twmiv/Voron-Hardware/Taco_Raven/KiCad/Voron_Klipper_Board.kicad_pcb

## KiCad design Taco_Raven/KiCad/Voron_Klipper_Board.kicad_pcb (2020-08-16)

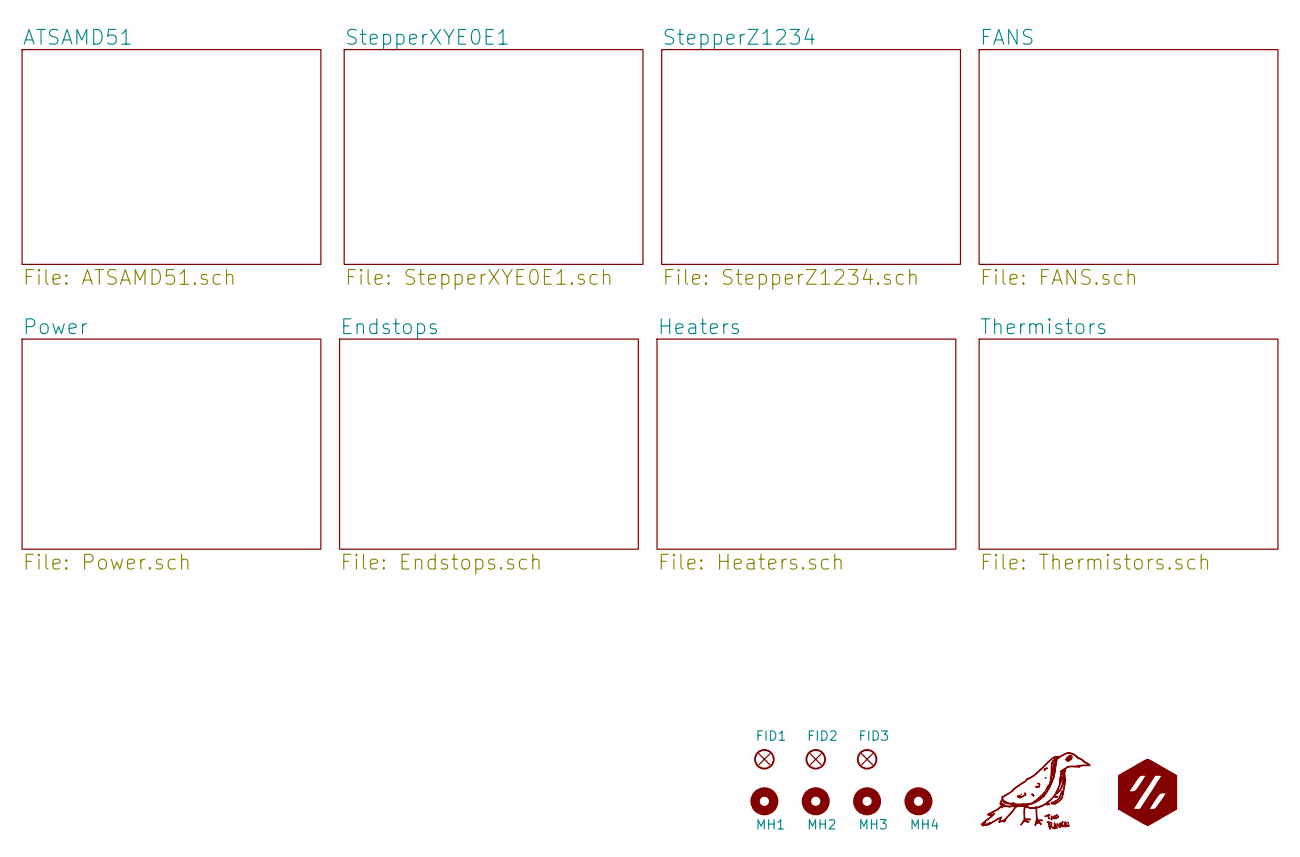
[picture p1: schematic Voron_Klipper_Board.sch, Taco Raven]

Parts:
FID1, FID2, FID3: FIDUCIAL_1MM; Fiducial_1mm_Dia_2.54mm_Outer_CopperBottom
G1: TACo; taco
G2: mzbot; LOGO
MH1, MH2, MH3, MH4: MountingHole; MountingHole_3.2mm_M3_DIN965

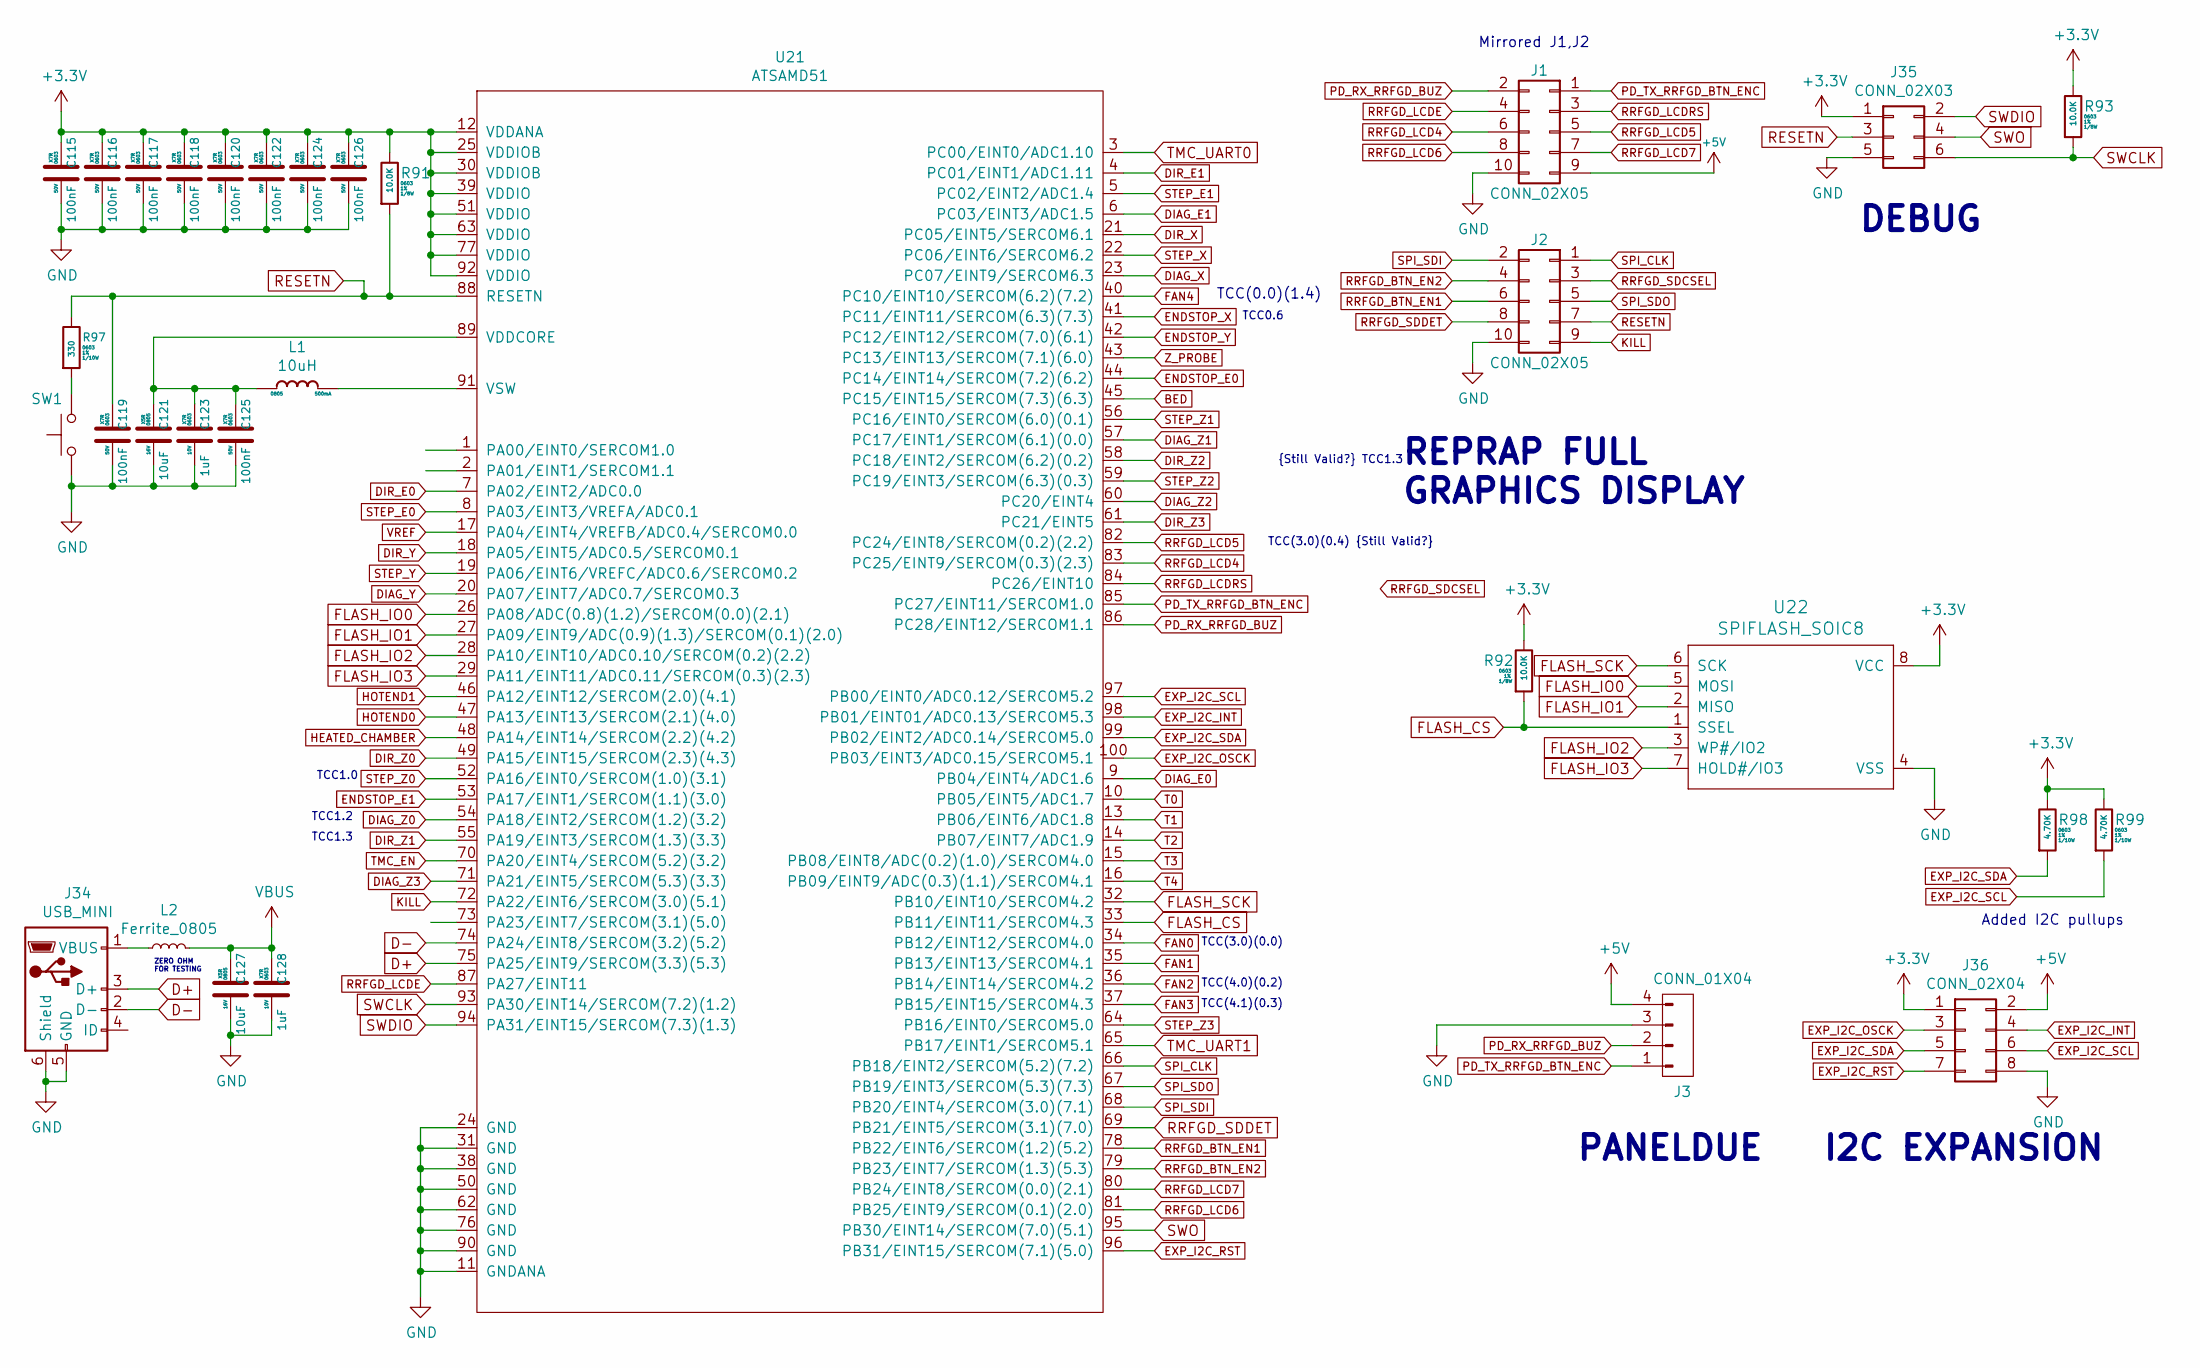
[picture p2: schematic ATSAMD51.sch, Taco Raven]

Parts:
C115, C116, C117, C118, C119, C120, C122, C124, C125, C126: 100nF; C_0603; Voltage 50V; MFG PN CC0603KRX7R9BB104; Digikey P/N 311-1344-1-ND
C121, C127: 10uF; C_0805; Voltage 16V; MFG PN CL21A106KOQNNWE; Digikey P/N 1276-2894-1-ND
C123, C128: 1uF; C_0603; Voltage 10V; MFG PN CL10B105KP8NNNC; Digikey P/N 1276-1946-1-ND
J1, J2: CONN_02X05; PinSocket_2x05_P2.54mm_Vertical; MFG PN 302-S101; Digikey P/N ED1543-ND
J3: CONN_01X04; Molex_KK_1X4; MFG PN 0022232041; Digikey P/N WM4202-ND
J34: USB_MINI; USB_Mini-B_Lumberg_2486_01_Horizontal; MFG PN 690-005-299-043; Digikey P/N 151-1206-1-ND
J35: CONN_02X03; PinHeader_2x03_P2.54mm_Vertical
J36: CONN_02X04; PinHeader_2x04_P2.54mm_Vertical; MFG PN 75869-332LF; Digikey P/N 609-5123-ND
L1: 10uH; L_0805_2012Metric; MFG PN MLZ2012N100LT000; Digikey P/N 445-6762-1-ND
L2: Ferrite_0805; L_0805_2012Metric; MFG PN CRCW08050000Z0EA; Digikey P/N 541-0.0ACT-ND
R91, R92, R93: 10.0K; R_0603; Tolerance 1%; MFG PN RNCP0603FTD10K0; Digikey P/N RNCP0603FTD10K0CT-ND
R97: 330; R_0603; Tolerance 1%; MFG PN RMCF0603JT330R; Digikey P/N RMCF0603JT330RCT-ND
R98, R99: 4.70K; R_0603; Tolerance 1%; MFG PN RC0603FR-074K7L; Digikey P/N 311-4.70KHRCT-ND
SW1: SW_Push; SW_SPST_B3S-1000; MFG PN B3S-1000P; Digikey P/N SW836CT-ND
U21: ATSAMD51; TQFP-100_14x14mm_P0.5mm; MFG PN ATSAMD51N19A-AU; Digikey P/N ATSAMD51N19A-AU-ND
U22: SPIFLASH_SOIC8; SOIC-8_3.9x4.9mm_Pitch1.27mm; MFG PN AT25SF041-SSHD-T; Digikey P/N 1265-1131-1-ND

Connections:
+3.3V: C115.2, C116.2, C117.2, C118.2, C120.2, C122.2, C124.2, C126.2, J35.1, J36.1, R91.1, R92.1, R93.1, R98.1, R99.1, U21.12 (VDDANA), U21.25 (VDDIOB), U21.30 (VDDIOB), U21.39 (VDDIO), U21.51 (VDDIO), U21.63 (VDDIO), U21.77 (VDDIO), U21.92 (VDDIO), U22.8 (VCC); also elsewhere on the board
+5V: J1.9, J3.4, J36.2; also elsewhere on the board
BED: U21.45 (PC15/EINT15/SERCOM(7.3)(6.3)); also elsewhere on the board
D+: J34.3 (D+), U21.75 (PA25/EINT9/SERCOM(3.3)(5.3))
D-: J34.2 (D-), U21.74 (PA24/EINT8/SERCOM(3.2)(5.2))
DIAG_E0: U21.9 (PB04/EINT4/ADC1.6); also elsewhere on the board
DIAG_E1: U21.6 (PC03/EINT3/ADC1.5); also elsewhere on the board
DIAG_X: U21.23 (PC07/EINT9/SERCOM6.3); also elsewhere on the board
DIAG_Y: U21.20 (PA07/EINT7/ADC0.7/SERCOM0.3); also elsewhere on the board
DIAG_Z0: U21.54 (PA18/EINT2/SERCOM(1.2)(3.2)); also elsewhere on the board
DIAG_Z1: U21.57 (PC17/EINT1/SERCOM(6.1)(0.0)); also elsewhere on the board
DIAG_Z2: U21.60 (PC20/EINT4); also elsewhere on the board
DIAG_Z3: U21.71 (PA21/EINT5/SERCOM(5.3)(3.3)); also elsewhere on the board
DIR_E0: U21.7 (PA02/EINT2/ADC0.0); also elsewhere on the board
DIR_E1: U21.4 (PC01/EINT1/ADC1.11); also elsewhere on the board
DIR_X: U21.21 (PC05/EINT5/SERCOM6.1); also elsewhere on the board
DIR_Y: U21.18 (PA05/EINT5/ADC0.5/SERCOM0.1); also elsewhere on the board
DIR_Z0: U21.49 (PA15/EINT15/SERCOM(2.3)(4.3)); also elsewhere on the board
DIR_Z1: U21.55 (PA19/EINT3/SERCOM(1.3)(3.3)); also elsewhere on the board
DIR_Z2: U21.58 (PC18/EINT2/SERCOM(6.2)(0.2)); also elsewhere on the board
DIR_Z3: U21.61 (PC21/EINT5); also elsewhere on the board
ENDSTOP_E0: U21.44 (PC14/EINT14/SERCOM(7.2)(6.2)); also elsewhere on the board
ENDSTOP_E1: U21.53 (PA17/EINT1/SERCOM(1.1)(3.0)); also elsewhere on the board
ENDSTOP_X: U21.41 (PC11/EINT11/SERCOM(6.3)(7.3)); also elsewhere on the board
ENDSTOP_Y: U21.42 (PC12/EINT12/SERCOM(7.0)(6.1)); also elsewhere on the board
EXP_I2C_INT: J36.4, U21.98 (PB01/EINT01/ADC0.13/SERCOM5.3)
EXP_I2C_OSCK: J36.3, U21.100 (PB03/EINT3/ADC0.15/SERCOM5.1)
EXP_I2C_RST: J36.7, U21.96 (PB31/EINT15/SERCOM(7.1)(5.0))
EXP_I2C_SCL: J36.6, R99.2, U21.97 (PB00/EINT0/ADC0.12/SERCOM5.2)
EXP_I2C_SDA: J36.5, R98.2, U21.99 (PB02/EINT2/ADC0.14/SERCOM5.0)
FAN0: U21.34 (PB12/EINT12/SERCOM4.0); also elsewhere on the board
FAN1: U21.35 (PB13/EINT13/SERCOM4.1); also elsewhere on the board
FAN2: U21.36 (PB14/EINT14/SERCOM4.2); also elsewhere on the board
FAN3: U21.37 (PB15/EINT15/SERCOM4.3); also elsewhere on the board
FAN4: U21.40 (PC10/EINT10/SERCOM(6.2)(7.2)); also elsewhere on the board
FLASH_CS: R92.2, U21.33 (PB11/EINT11/SERCOM4.3), U22.1 (SSEL)
FLASH_IO0: U21.26 (PA08/ADC(0.8)(1.2)/SERCOM(0.0)(2.1)), U22.5 (MOSI)
FLASH_IO1: U21.27 (PA09/EINT9/ADC(0.9)(1.3)/SERCOM(0.1)(2.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), U22.2 (MISO)
FLASH_IO2: U21.28 (PA10/EINT10/ADC0.10/SERCOM(0.2)(2.2)), U22.3 (WP#/IO2)
FLASH_IO3: U21.29 (PA11/EINT11/ADC0.11/SERCOM(0.3)(2.3)), U22.7 (HOLD#/IO3)
FLASH_SCK: U21.32 (PB10/EINT10/SERCOM4.2), U22.6 (SCK)
GND: C115.1, C116.1, C117.1, C118.1, C119.1, C120.1, C121.1, C122.1, C123.1, C124.1, C125.1, C126.1, C127.1, C128.1, J1.10, J2.10, J3.3, J34.5 (GND), J34.6 (Shield), J35.5, J36.8, SW1.1, U21.11 (GNDANA), U21.24 (GND), U21.31 (GND), U21.38 (GND), U21.50 (GND), U21.62 (GND), U21.76 (GND), U21.90 (GND), U22.4 (VSS); also elsewhere on the board
HEATED_CHAMBER: U21.48 (PA14/EINT14/SERCOM(2.2)(4.2)); also elsewhere on the board
HOTEND0: U21.47 (PA13/EINT13/SERCOM(2.1)(4.0)); also elsewhere on the board
HOTEND1: U21.46 (PA12/EINT12/SERCOM(2.0)(4.1)); also elsewhere on the board
KILL: J2.9, U21.72 (PA22/EINT6/SERCOM(3.0)(5.1))
unnamed: C121.2, C123.2, C125.2, L1.1, U21.89 (VDDCORE)
unnamed: J34.1 (VBUS), L2.1
unnamed: L1.2, U21.91 (VSW)
unnamed: R97.2, SW1.2
PD_RX_RRFGD_BUZ: J1.2, J3.2, U21.86 (PC28/EINT12/SERCOM1.1)
PD_TX_RRFGD_BTN_ENC: J1.1, J3.1, U21.85 (PC27/EINT11/SERCOM1.0)
RESETN: C119.2, J2.7, J35.3, R91.2, R97.1, U21.88 (RESETN)
RRFGD_BTN_EN1: J2.6, U21.78 (PB22/EINT6/SERCOM(1.2)(5.2))
RRFGD_BTN_EN2: J2.4, U21.79 (PB23/EINT7/SERCOM(1.3)(5.3))
RRFGD_LCD4: J1.6, U21.83 (PC25/EINT9/SERCOM(0.3)(2.3))
RRFGD_LCD5: J1.5, U21.82 (PC24/EINT8/SERCOM(0.2)(2.2))
RRFGD_LCD6: J1.8, U21.81 (PB25/EINT9/SERCOM(0.1)(2.0))
RRFGD_LCD7: J1.7, U21.80 (PB24/EINT8/SERCOM(0.0)(2.1))
RRFGD_LCDE: J1.4, U21.87 (PA27/EINT11)
RRFGD_LCDRS: J1.3, U21.84 (PC26/EINT10)
RRFGD_SDCSEL: J2.3
RRFGD_SDDET: J2.8, U21.69 (PB21/EINT5/SERCOM(3.1)(7.0))
SPI_CLK: J2.1, U21.66 (PB18/EINT2/SERCOM(5.2)(7.2))
SPI_SDI: J2.2, U21.68 (PB20/EINT4/SERCOM(3.0)(7.1))
SPI_SDO: J2.5, U21.67 (PB19/EINT3/SERCOM(5.3)(7.3))
STEP_E0: U21.8 (PA03/EINT3/VREFA/ADC0.1); also elsewhere on the board
STEP_E1: U21.5 (PC02/EINT2/ADC1.4); also elsewhere on the board
STEP_X: U21.22 (PC06/EINT6/SERCOM6.2); also elsewhere on the board
STEP_Y: U21.19 (PA06/EINT6/VREFC/ADC0.6/SERCOM0.2); also elsewhere on the board
STEP_Z0: U21.52 (PA16/EINT0/SERCOM(1.0)(3.1)); also elsewhere on the board
STEP_Z1: U21.56 (PC16/EINT0/SERCOM(6.0)(0.1)); also elsewhere on the board
STEP_Z2: U21.59 (PC19/EINT3/SERCOM(6.3)(0.3)); also elsewhere on the board
STEP_Z3: U21.64 (PB16/EINT0/SERCOM5.0); also elsewhere on the board
SWCLK: J35.6, R93.2, U21.93 (PA30/EINT14/SERCOM(7.2)(1.2))
SWDIO: J35.2, U21.94 (PA31/EINT15/SERCOM(7.3)(1.3))
SWO: J35.4, U21.95 (PB30/EINT14/SERCOM(7.0)(5.1))
T0: U21.10 (PB05/EINT5/ADC1.7); also elsewhere on the board
T1: U21.13 (PB06/EINT6/ADC1.8); also elsewhere on the board
T2: U21.14 (PB07/EINT7/ADC1.9); also elsewhere on the board
T3: U21.15 (PB08/EINT8/ADC(0.2)(1.0)/SERCOM4.0); also elsewhere on the board
T4: U21.16 (PB09/EINT9/ADC(0.3)(1.1)/SERCOM4.1); also elsewhere on the board
TMC_EN: U21.70 (PA20/EINT4/SERCOM(5.2)(3.2)); also elsewhere on the board
TMC_UART0: U21.3 (PC00/EINT0/ADC1.10); also elsewhere on the board
TMC_UART1: U21.65 (PB17/EINT1/SERCOM5.1); also elsewhere on the board
VBUS: C127.2, C128.2, L2.2; also elsewhere on the board
VREF: U21.17 (PA04/EINT4/VREFB/ADC0.4/SERCOM0.0); also elsewhere on the board
Z_PROBE: U21.43 (PC13/EINT13/SERCOM(7.1)(6.0)); also elsewhere on the board

Notes on the sheet:
PANELDUE
REPRAP FULL GRAPHICS DISPLAY
TCC0.6
TCC1.0
TCC1.3
{Still Valid?} TCC1.3
DEBUG
TCC(3.0)(0.0)
TCC(4.0)(0.2)
TCC(4.1)(0.3)
TCC(3.0)(0.4) {Still Valid?}
TCC(0.0)(1.4)
I2C EXPANSION
ZERO OHM FOR TESTING
Mirrored J1,J2
Added I2C pullups
TCC1.2
