twmiv/Voron-Hardware/Taco_Raven/KiCad/Voron_Klipper_Board.kicad_pcb

## KiCad design Taco_Raven/KiCad/Voron_Klipper_Board.kicad_pcb (continued)

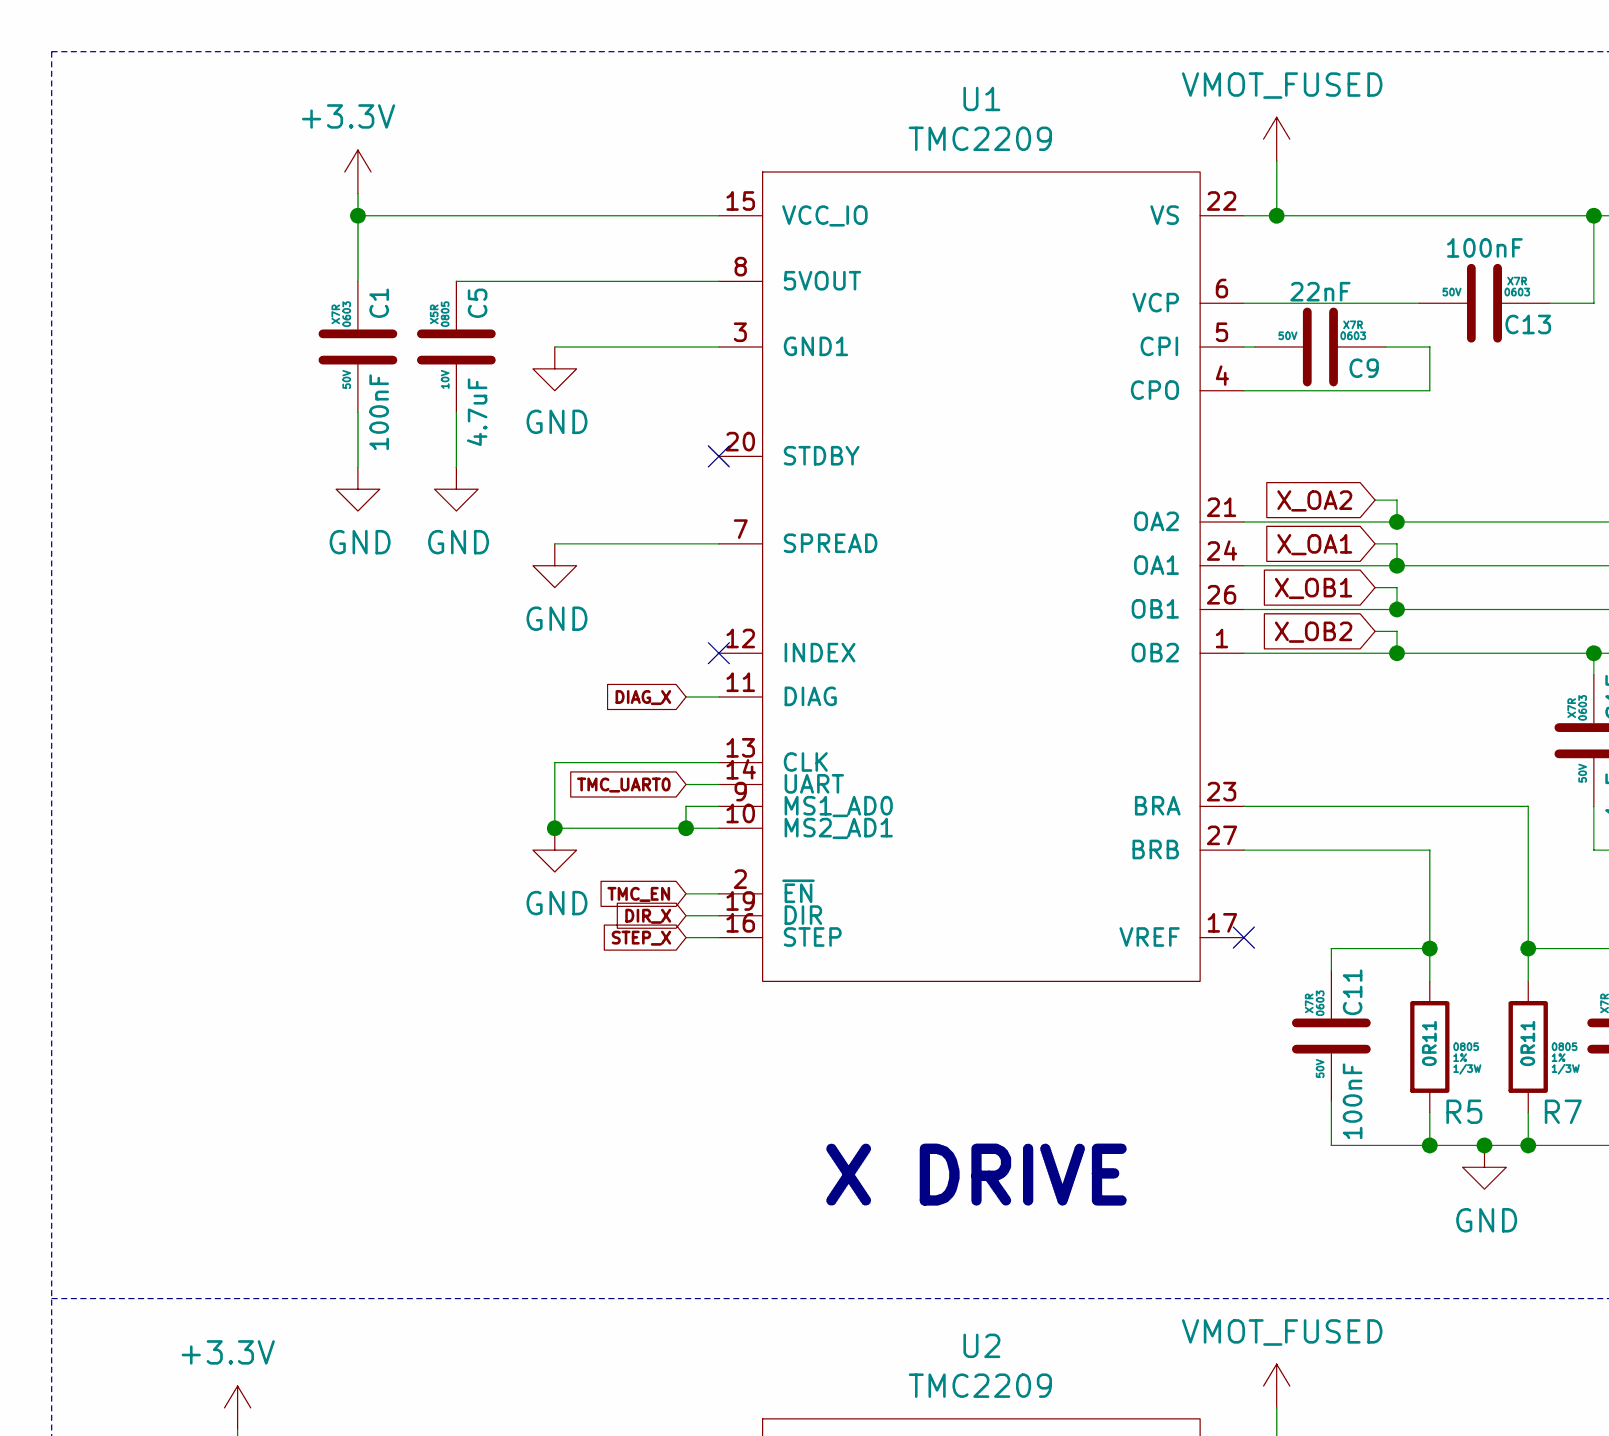
[picture p3: schematic StepperXYE0E1.sch, Taco Raven, part in row 1, column 1]

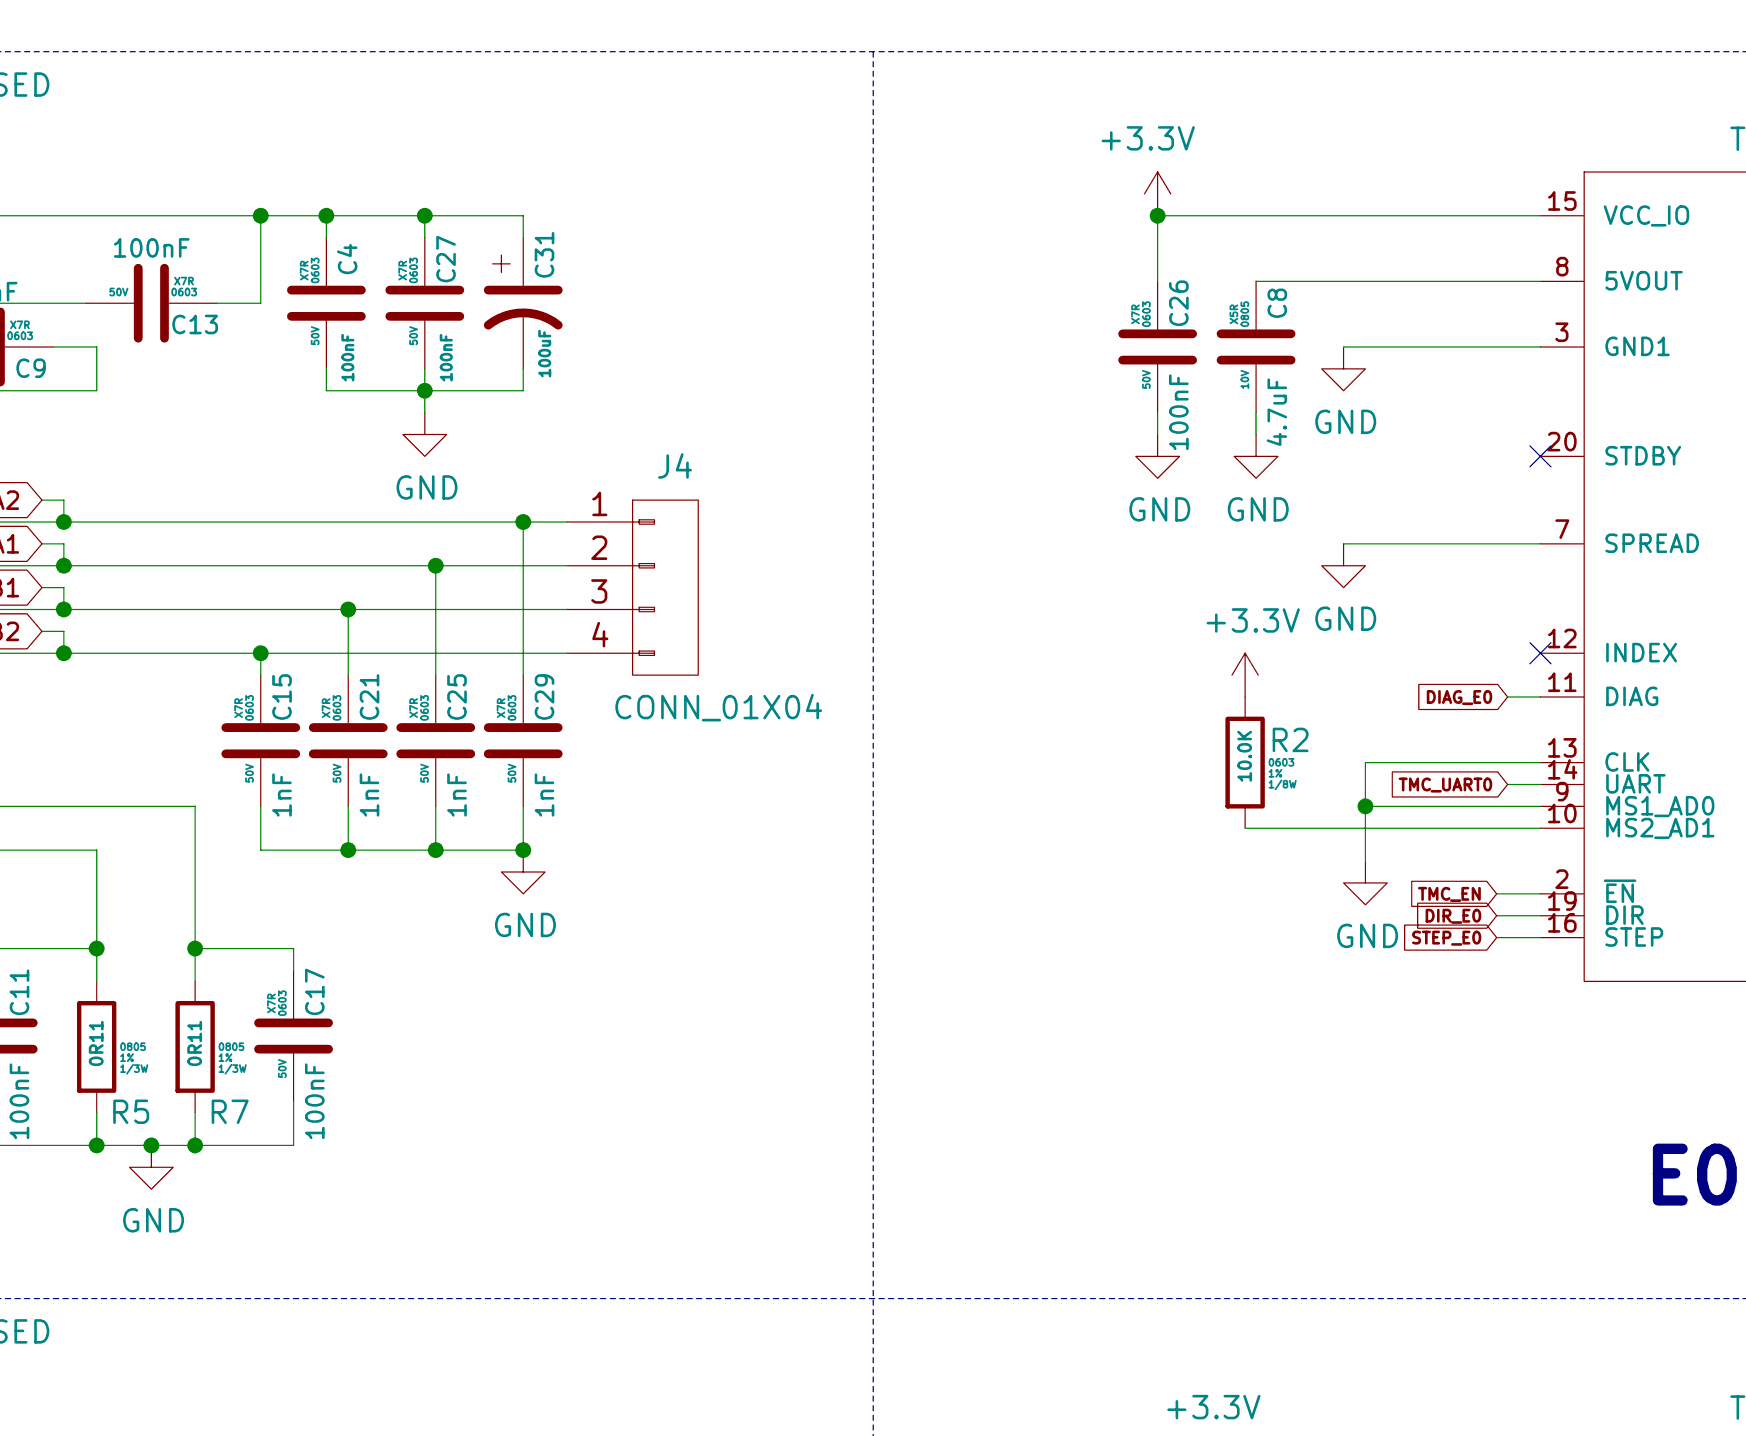
[picture p4: schematic StepperXYE0E1.sch, Taco Raven, part in row 1, column 2]

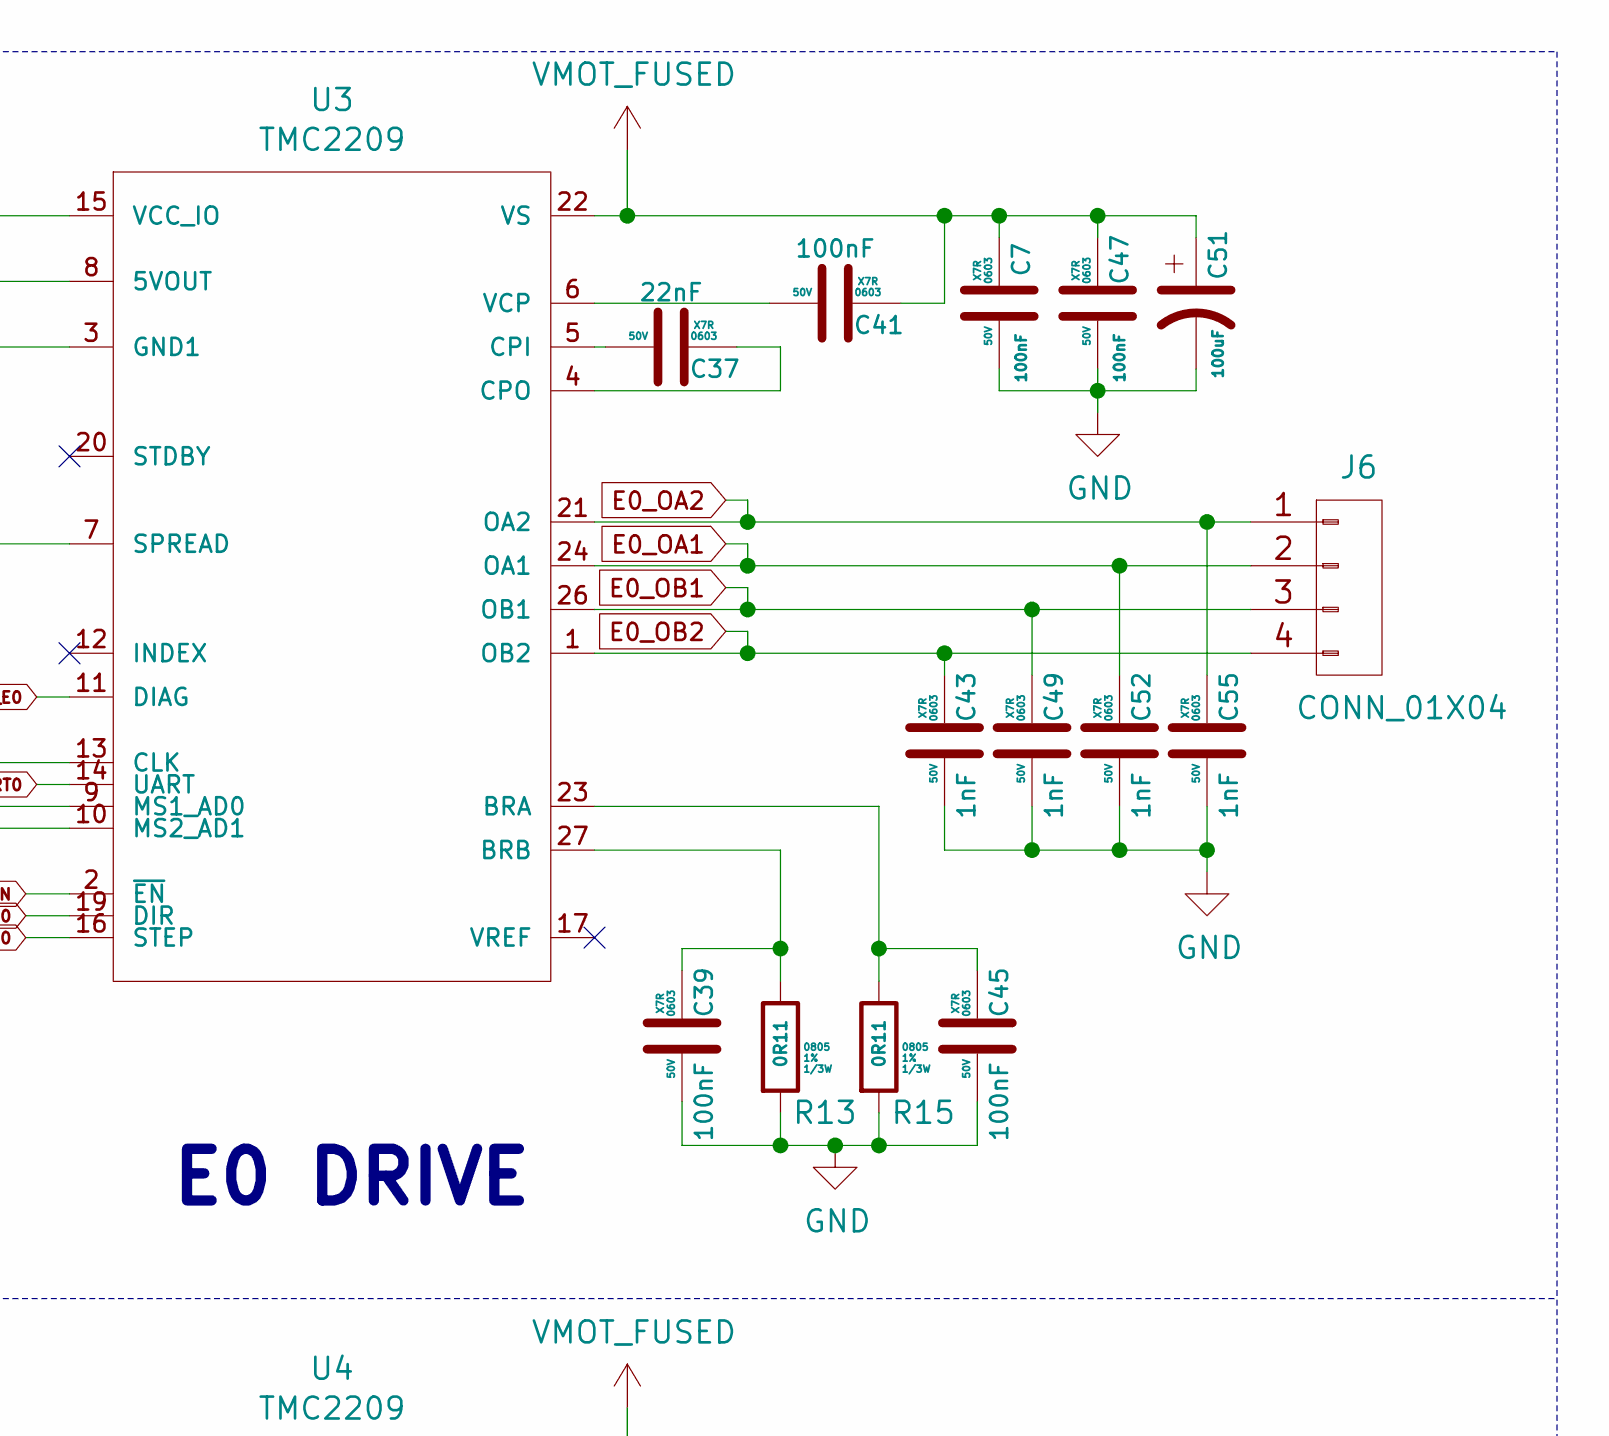
[picture p5: schematic StepperXYE0E1.sch, Taco Raven, part in row 1, column 3]

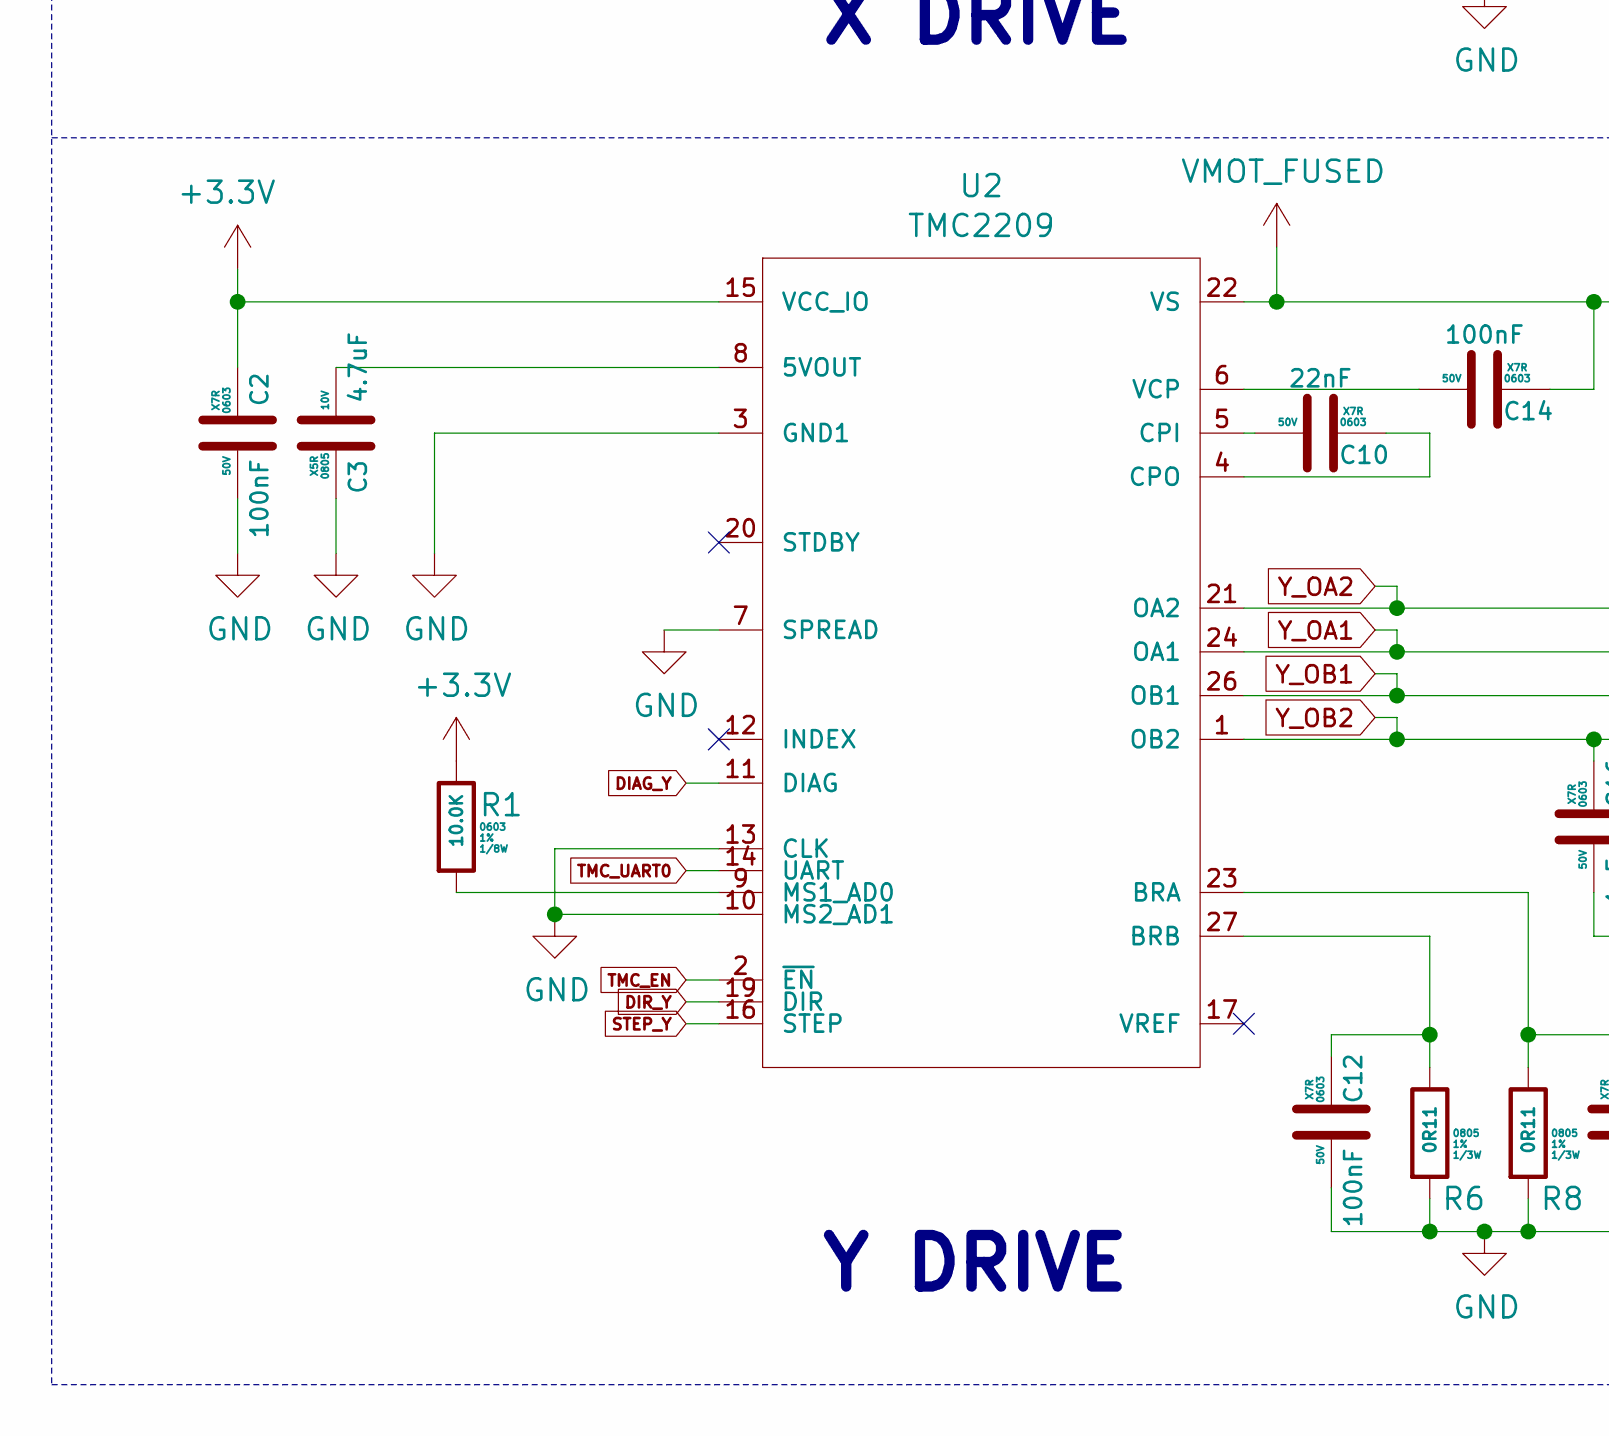
[picture p6: schematic StepperXYE0E1.sch, Taco Raven, part in row 2, column 1]

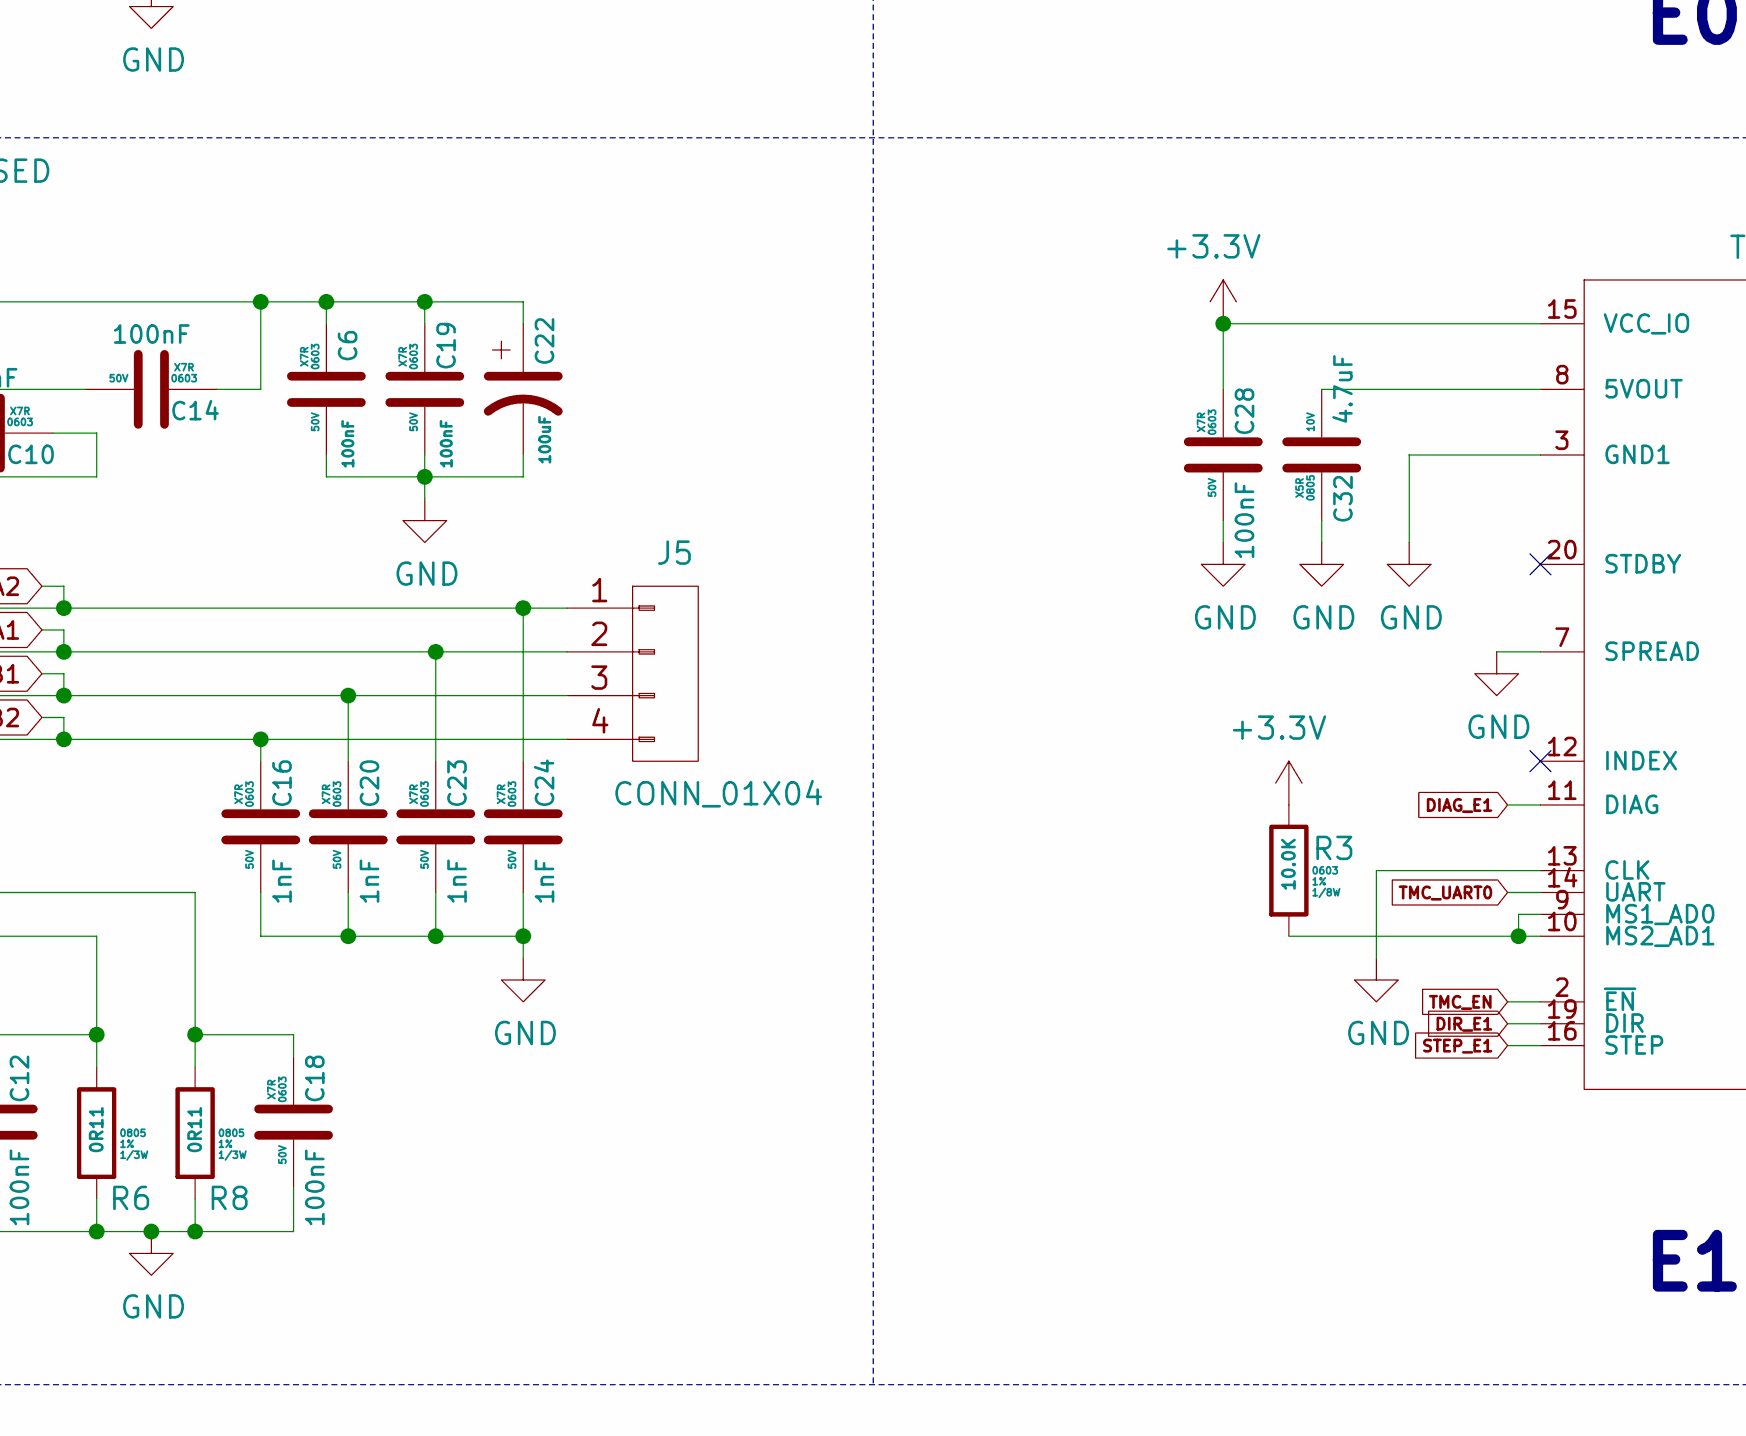
[picture p7: schematic StepperXYE0E1.sch, Taco Raven, part in row 2, column 2]

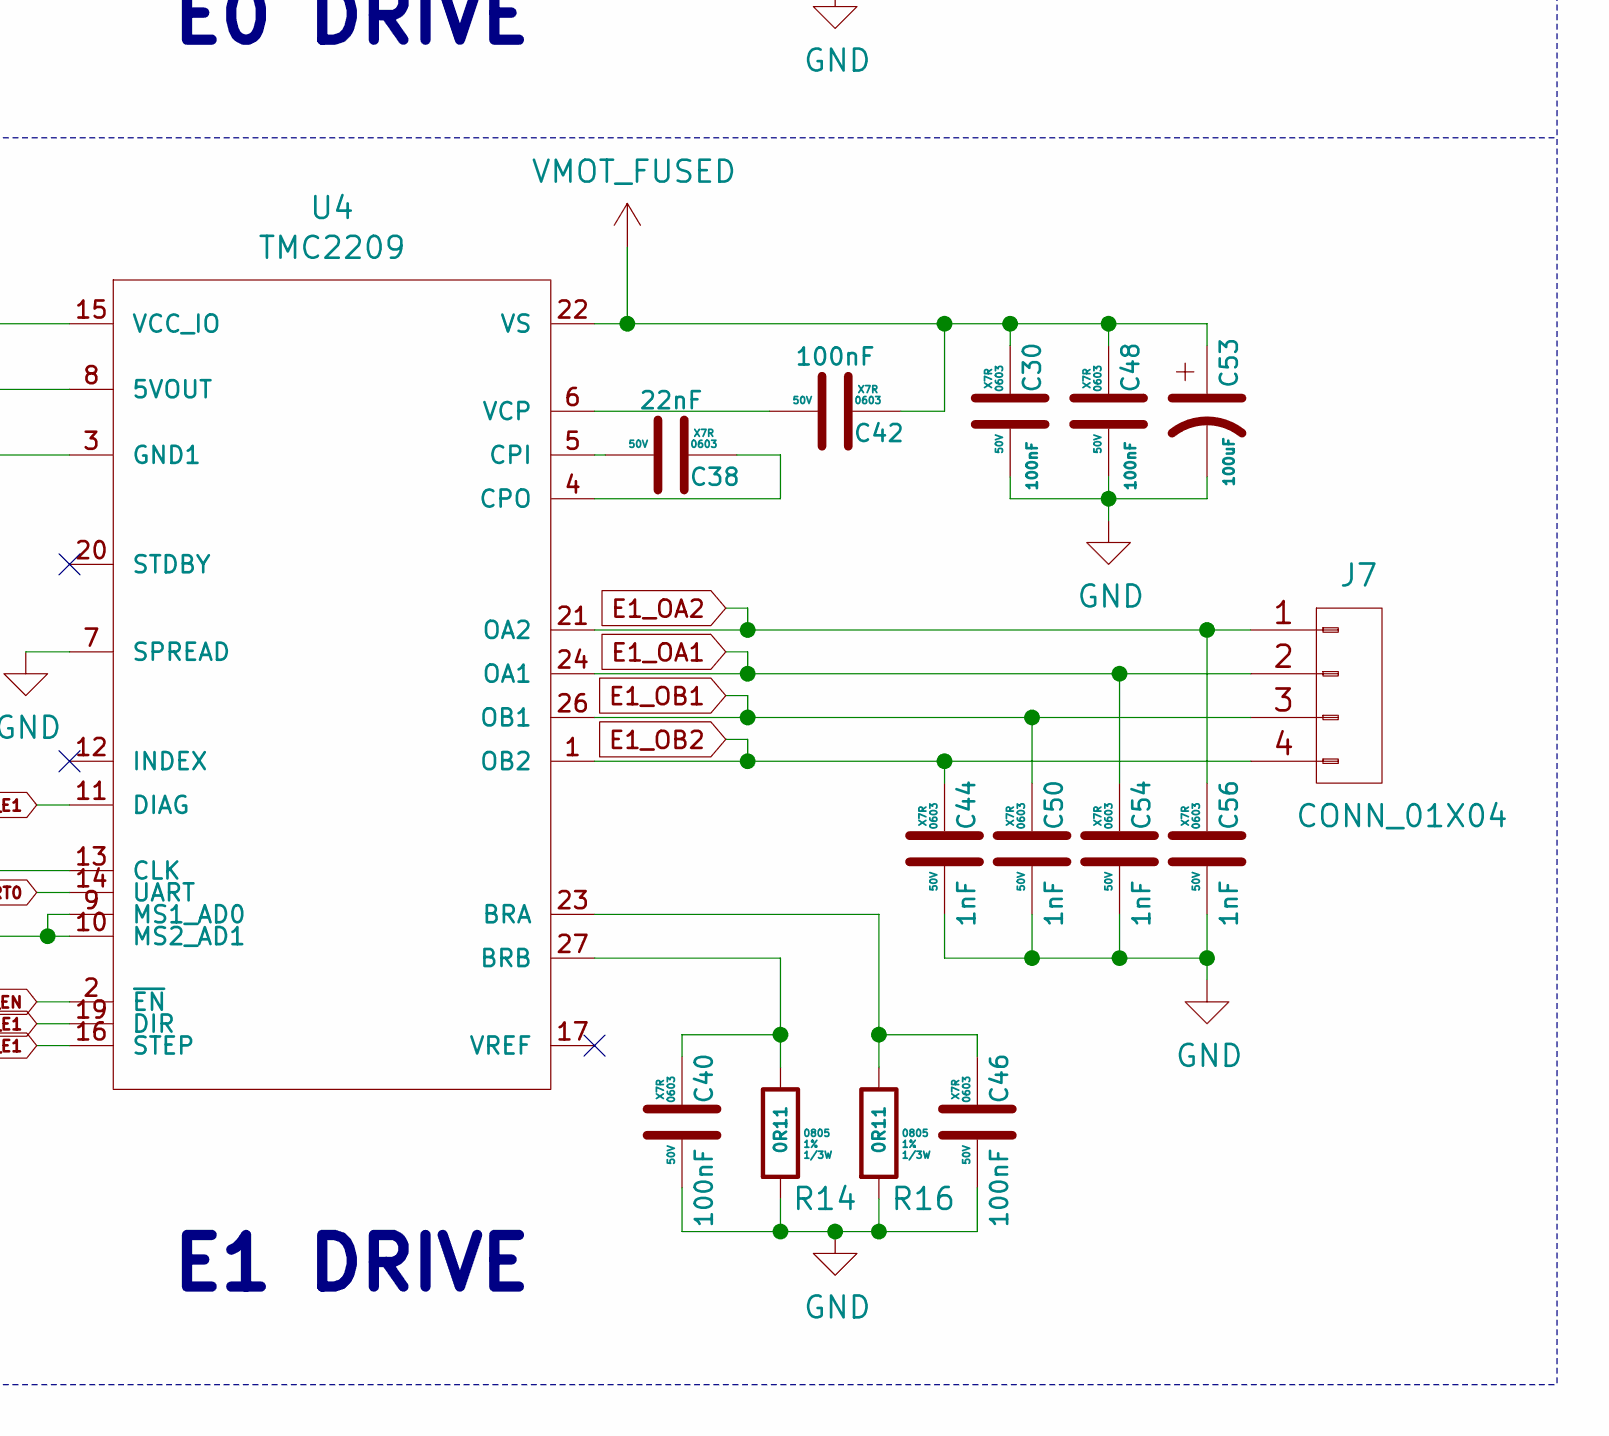
[picture p8: schematic StepperXYE0E1.sch, Taco Raven, part in row 2, column 3]

Parts:
C1, C2, C4, C6, C7, C11, C12, C13, C14, C17, C18, C19, C26, C27, C28, C30, C39, C40, C41, C42, C45, C46, C47, C48: 100nF; C_0603; Voltage 50V; MFG PN CC0603KRX7R9BB104; Digikey P/N 311-1344-1-ND
C3, C5, C8, C32: 4.7uF; C_0805; Voltage 10V; MFG PN CL21A475KPFNNNG; Digikey P/N 1276-6464-1-ND
C9, C10, C37, C38: 22nF; C_0603; Voltage 50V; MFG PN CL10B223KB8WPNC; Digikey P/N 311-3601-1-ND
C15, C16, C20, C21, C23, C24, C25, C29, C43, C44, C49, C50, C52, C54, C55, C56: 1nF; C_0603; Voltage 50V; MFG PN CC0603KRX7R9BB102; Digikey P/N 311-1080-1-ND
C22, C31, C51, C53: 100uF; CP_Elec_6.3x7.7; Voltage 50V; MFG PN EMZR500ARA101MF80G; Digikey P/N 565-5153-1-ND
J4, J5, J6, J7: CONN_01X04; Molex_KK_1X4; MFG PN 0022232041; Digikey P/N WM4202-ND
R1, R2, R3: 10.0K; R_0603; Tolerance 1%; MFG PN RNCP0603FTD10K0; Digikey P/N RNCP0603FTD10K0CT-ND
R5, R6, R7, R8, R13, R14, R15, R16: 0R11; R_0805; Tolerance 1%; MFG PN RL1220S-R11-F; Digikey P/N RL12S.11FCT-ND
U1, U2, U3, U4: TMC2209; QFN-28_EP_5x5_Pitch0.5mm

Connections:
+3.3V: C1.2, C2.2, C26.2, C28.2, R1.1, R2.1, R3.1, U1.15 (VCC_IO), U2.15 (VCC_IO), U3.15 (VCC_IO), U4.15 (VCC_IO); also elsewhere on the board
DIAG_E0: U3.11 (DIAG); also elsewhere on the board
DIAG_E1: U4.11 (DIAG); also elsewhere on the board
DIAG_X: U1.11 (DIAG); also elsewhere on the board
DIAG_Y: U2.11 (DIAG); also elsewhere on the board
DIR_E0: U3.19 (DIR); also elsewhere on the board
DIR_E1: U4.19 (DIR); also elsewhere on the board
DIR_X: U1.19 (DIR); also elsewhere on the board
DIR_Y: U2.19 (DIR); also elsewhere on the board
E0_OA1: C52.2, J6.2, U3.24 (OA1)
E0_OA2: C55.2, J6.1, U3.21 (OA2)
E0_OB1: C49.2, J6.3, U3.26 (OB1)
E0_OB2: C43.2, J6.4, U3.1 (OB2)
E1_OA1: C54.2, J7.2, U4.24 (OA1)
E1_OA2: C56.2, J7.1, U4.21 (OA2)
E1_OB1: C50.2, J7.3, U4.26 (OB1)
E1_OB2: C44.2, J7.4, U4.1 (OB2)
GND: C1.1, C2.1, C3.2, C4.1, C5.1, C6.1, C7.1, C8.1, C11.1, C12.1, C15.1, C16.1, C17.1, C18.1, C19.1, C20.1, C21.1, C22.2, C23.1, C24.1, C25.1, C26.1, C27.1, C28.1, C29.1, C30.1, C31.2, C32.2, C39.1, C40.1, C43.1, C44.1, C45.1, C46.1, C47.1, C48.1, C49.1, C50.1, C51.2, C52.1, C53.2, C54.1, C55.1, C56.1, R5.2, R6.2, R7.2, R8.2, R13.2, R14.2, R15.2, R16.2, U1.3 (GND1), U1.7 (SPREAD), U1.9 (MS1_AD0), U1.10 (MS2_AD1), U1.13 (CLK), U1.18 (GND2), U1.25 (GND3), U1.29 (G_PAD), U2.3 (GND1), U2.7 (SPREAD), U2.10 (MS2_AD1), U2.13 (CLK), U2.18 (GND2), U2.25 (GND3), U2.29 (G_PAD), U3.3 (GND1), U3.7 (SPREAD), U3.9 (MS1_AD0), U3.13 (CLK), U3.18 (GND2), U3.25 (GND3), U3.29 (G_PAD), U4.3 (GND1), U4.7 (SPREAD), U4.13 (CLK), U4.18 (GND2), U4.25 (GND3), U4.29 (G_PAD); also elsewhere on the board
unnamed: C3.1, U2.8 (5VOUT)
unnamed: C5.2, U1.8 (5VOUT)
unnamed: C8.2, U3.8 (5VOUT)
unnamed: C9.1, U1.5 (CPI)
unnamed: C9.2, U1.4 (CPO)
unnamed: C10.1, U2.5 (CPI)
unnamed: C10.2, U2.4 (CPO)
unnamed: C11.2, R5.1, U1.27 (BRB)
unnamed: C12.2, R6.1, U2.27 (BRB)
unnamed: C13.1, U1.6 (VCP)
unnamed: C14.1, U2.6 (VCP)
unnamed: C17.2, R7.1, U1.23 (BRA)
unnamed: C18.2, R8.1, U2.23 (BRA)
unnamed: C32.1, U4.8 (5VOUT)
unnamed: C37.1, U3.5 (CPI)
unnamed: C37.2, U3.4 (CPO)
unnamed: C38.1, U4.5 (CPI)
unnamed: C38.2, U4.4 (CPO)
unnamed: C39.2, R13.1, U3.27 (BRB)
unnamed: C40.2, R14.1, U4.27 (BRB)
unnamed: C41.1, U3.6 (VCP)
unnamed: C42.1, U4.6 (VCP)
unnamed: C45.2, R15.1, U3.23 (BRA)
unnamed: C46.2, R16.1, U4.23 (BRA)
unnamed: R1.2, U2.9 (MS1_AD0)
unnamed: R2.2, U3.10 (MS2_AD1)
unnamed: R3.2, U4.9 (MS1_AD0), U4.10 (MS2_AD1)
STEP_E0: U3.16 (STEP); also elsewhere on the board
STEP_E1: U4.16 (STEP); also elsewhere on the board
STEP_X: U1.16 (STEP); also elsewhere on the board
STEP_Y: U2.16 (STEP); also elsewhere on the board
TMC_EN: U1.2 (~EN), U2.2 (~EN), U3.2 (~EN), U4.2 (~EN); also elsewhere on the board
TMC_UART0: U1.14 (UART), U2.14 (UART), U3.14 (UART), U4.14 (UART); also elsewhere on the board
VMOT_FUSED: C4.2, C6.2, C7.2, C13.2, C14.2, C19.2, C22.1, C27.2, C30.2, C31.1, C41.2, C42.2, C47.2, C48.2, C51.1, C53.1, U1.22 (VS), U1.28 (VS), U2.22 (VS), U2.28 (VS), U3.22 (VS), U3.28 (VS), U4.22 (VS), U4.28 (VS); also elsewhere on the board
X_OA1: C25.2, J4.2, U1.24 (OA1)
X_OA2: C29.2, J4.1, U1.21 (OA2)
X_OB1: C21.2, J4.3, U1.26 (OB1)
X_OB2: C15.2, J4.4, U1.1 (OB2)
Y_OA1: C23.2, J5.2, U2.24 (OA1)
Y_OA2: C24.2, J5.1, U2.21 (OA2)
Y_OB1: C20.2, J5.3, U2.26 (OB1)
Y_OB2: C16.2, J5.4, U2.1 (OB2)

Notes on the sheet:
X DRIVE
Y DRIVE
E0 DRIVE
E1 DRIVE
