twmiv/Voron-Hardware/Taco_Raven/KiCad/Voron_Klipper_Board.kicad_pcb

## KiCad design Taco_Raven/KiCad/Voron_Klipper_Board.kicad_pcb (continued)

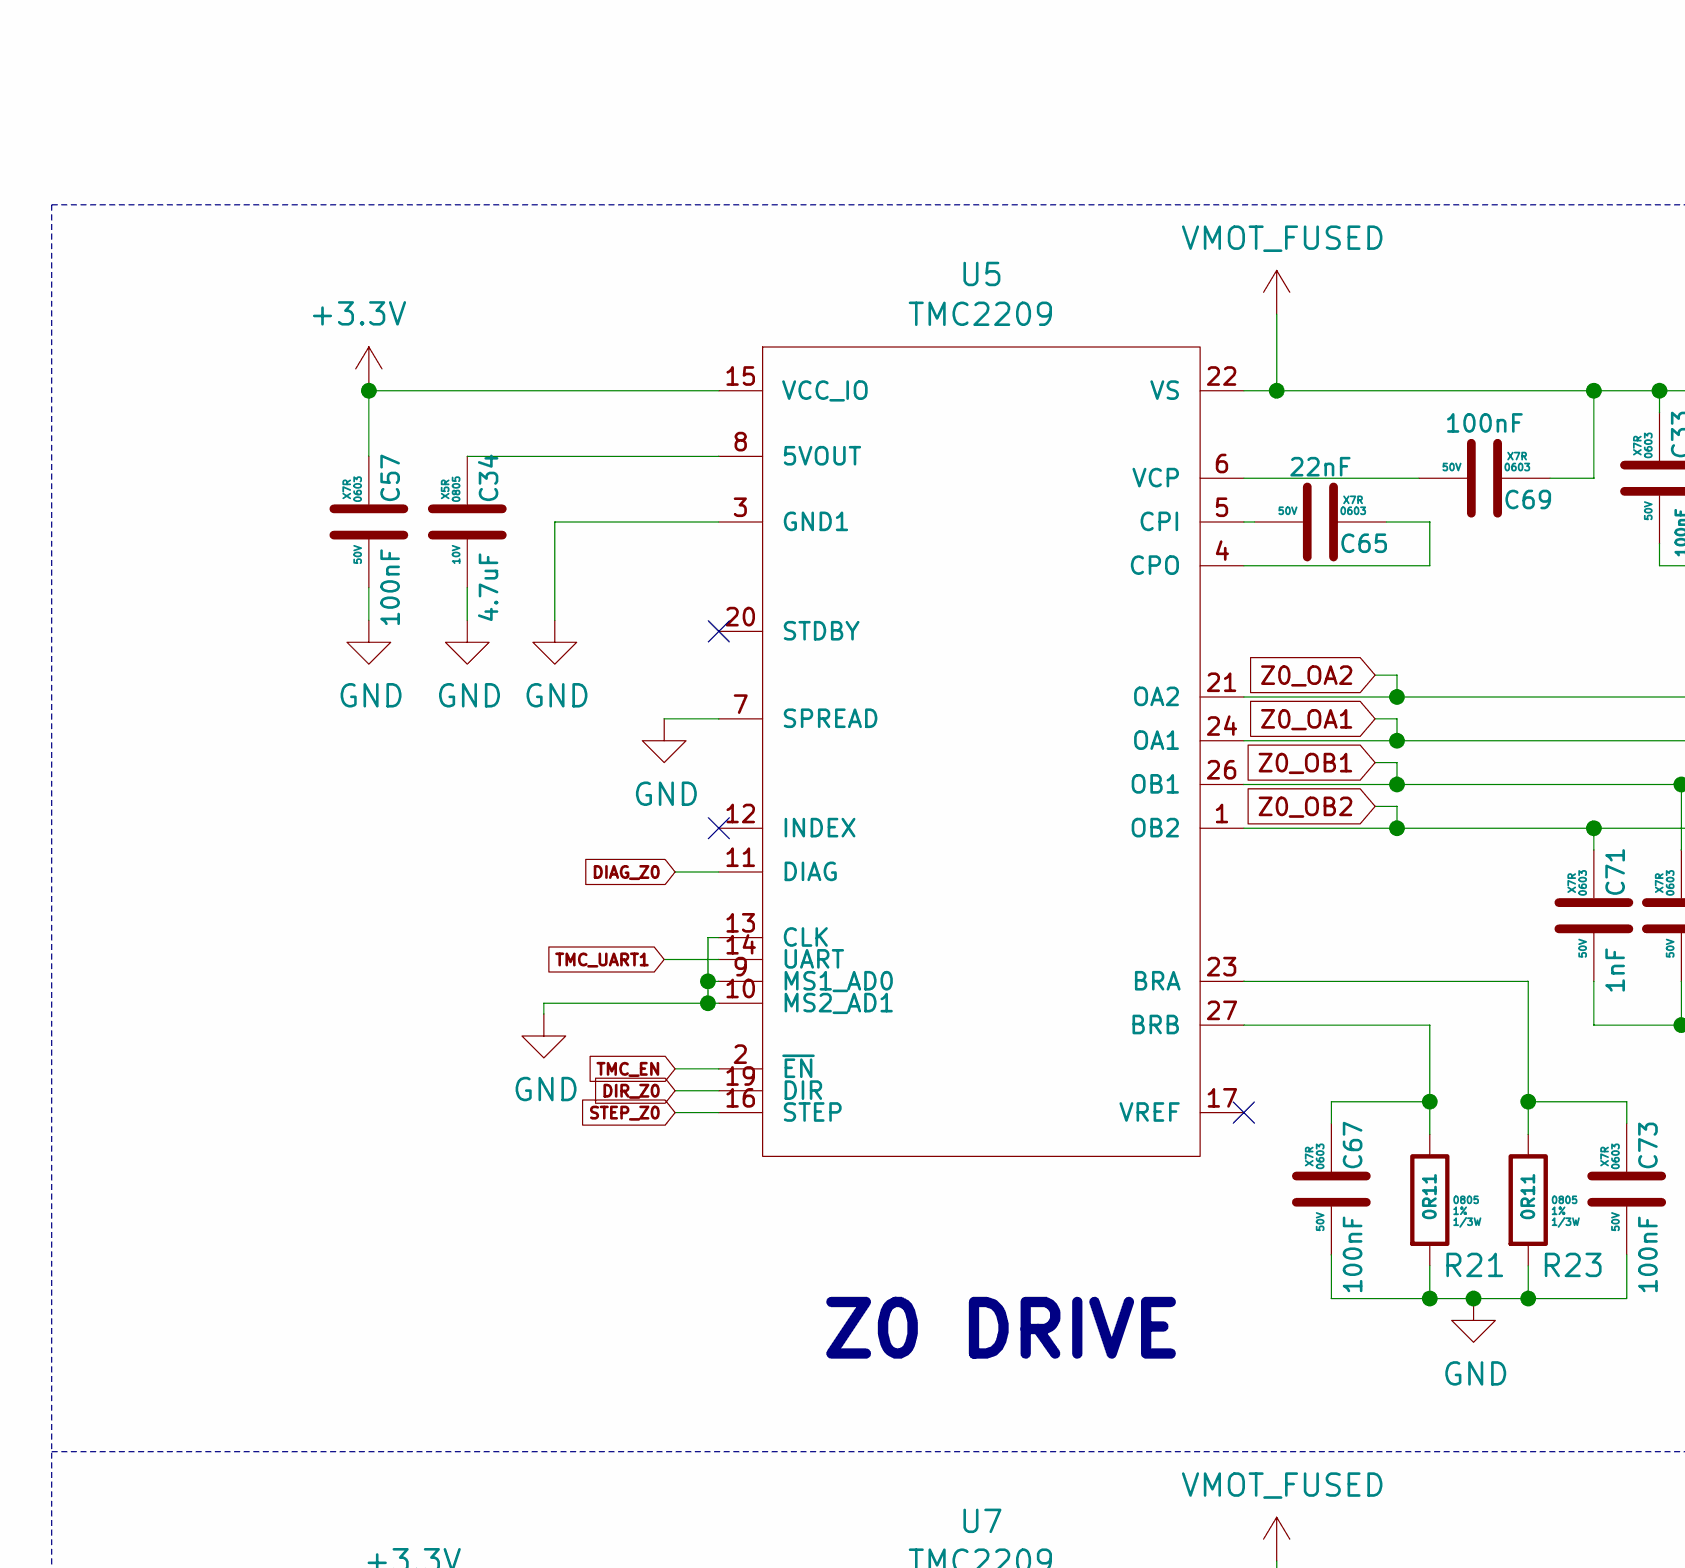
[picture p9: schematic StepperZ1234.sch, Taco Raven, part in row 1, column 1]

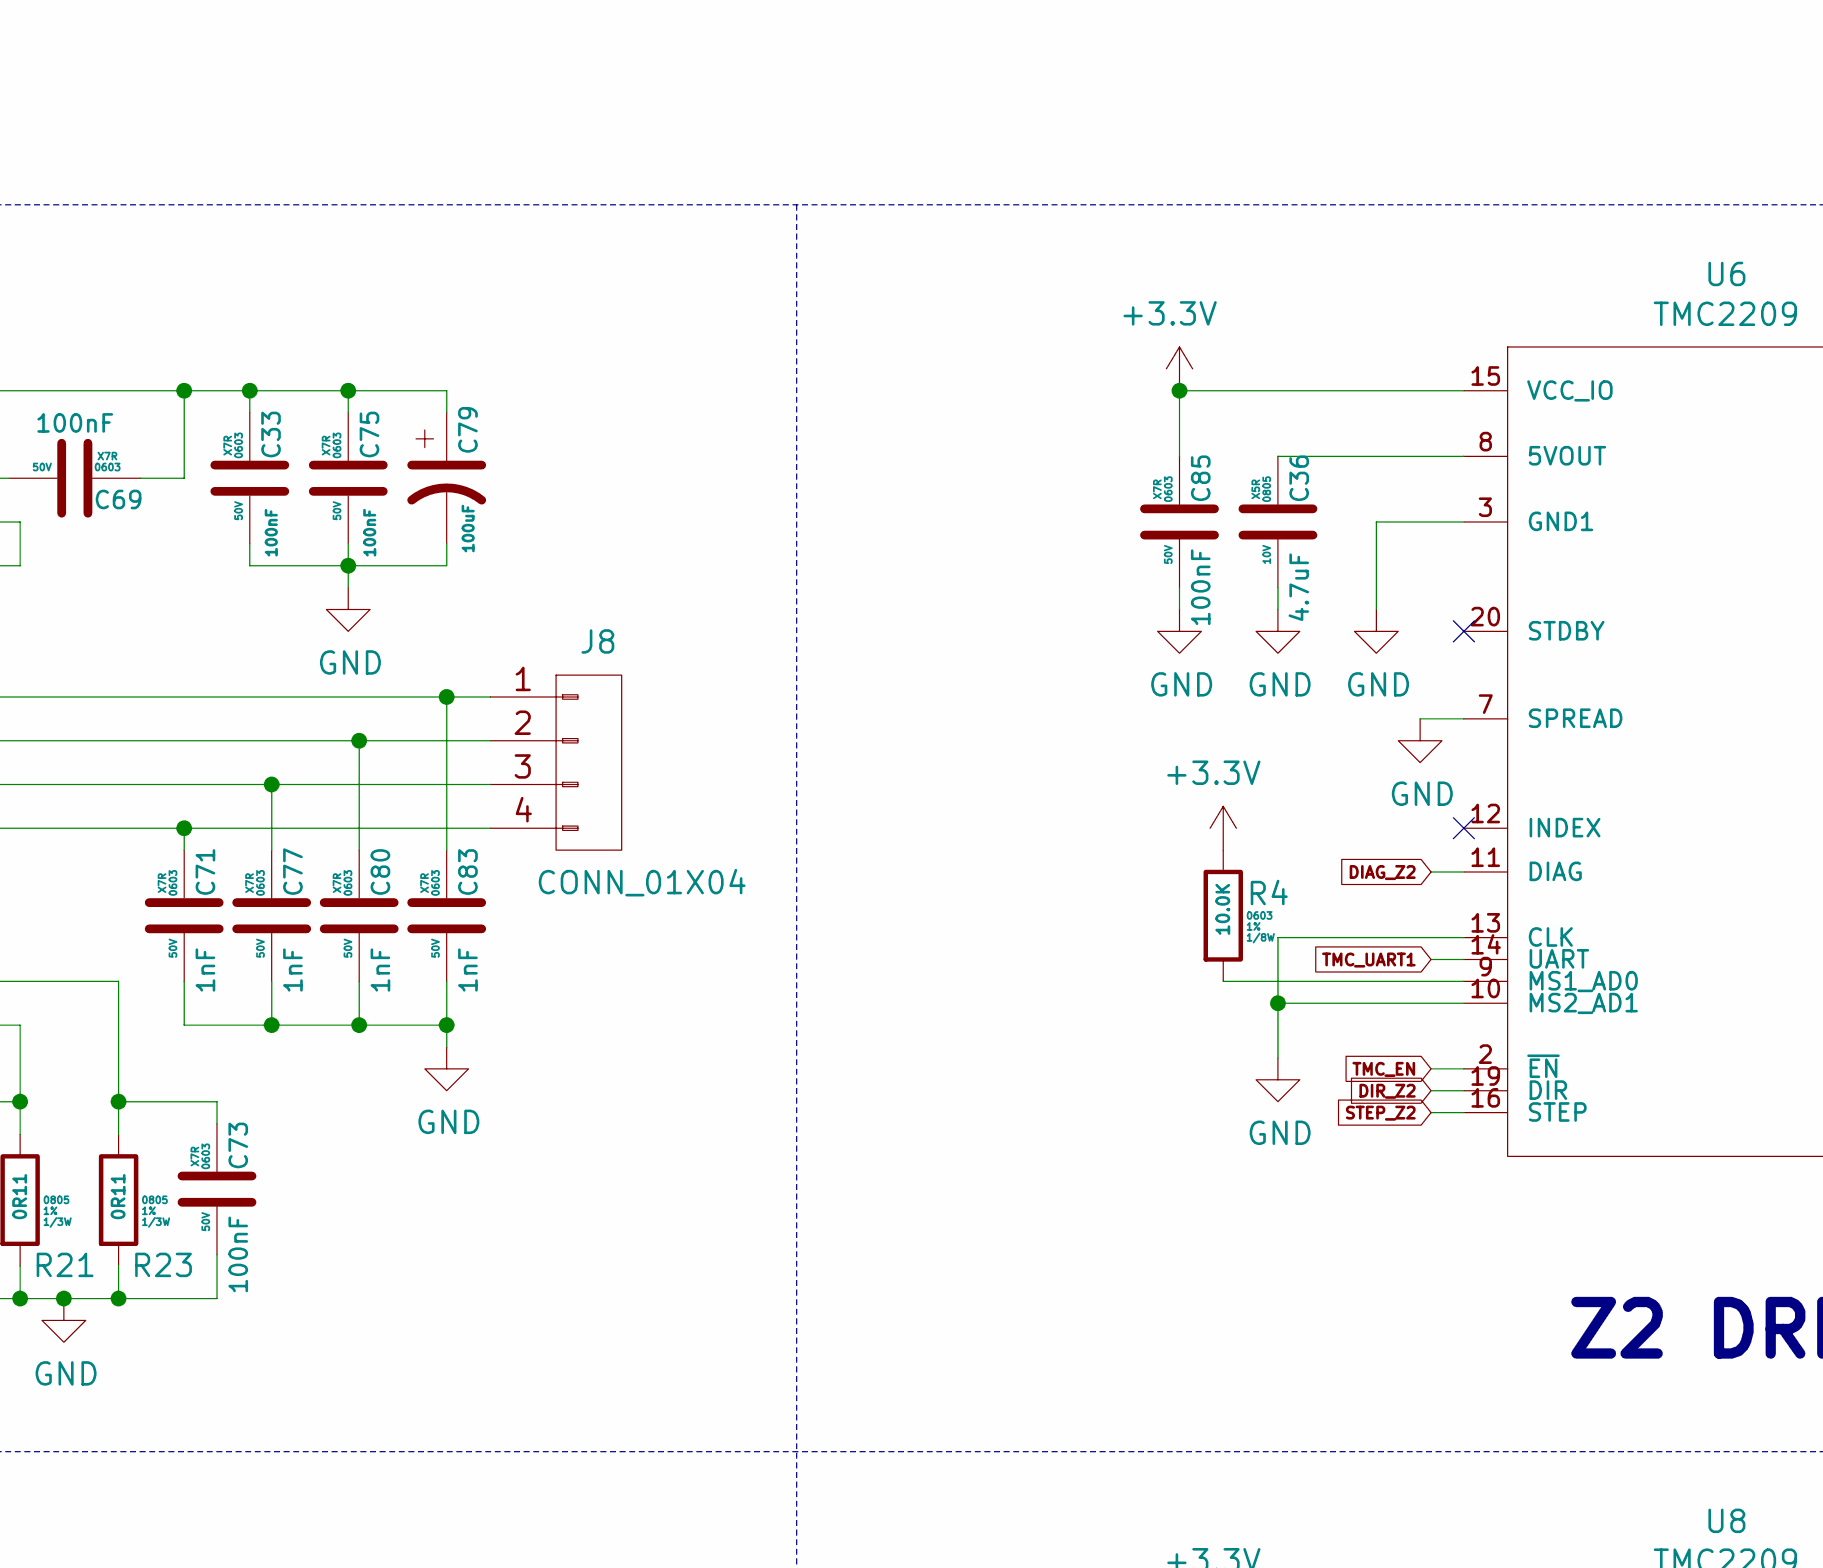
[picture p10: schematic StepperZ1234.sch, Taco Raven, part in row 1, column 2]

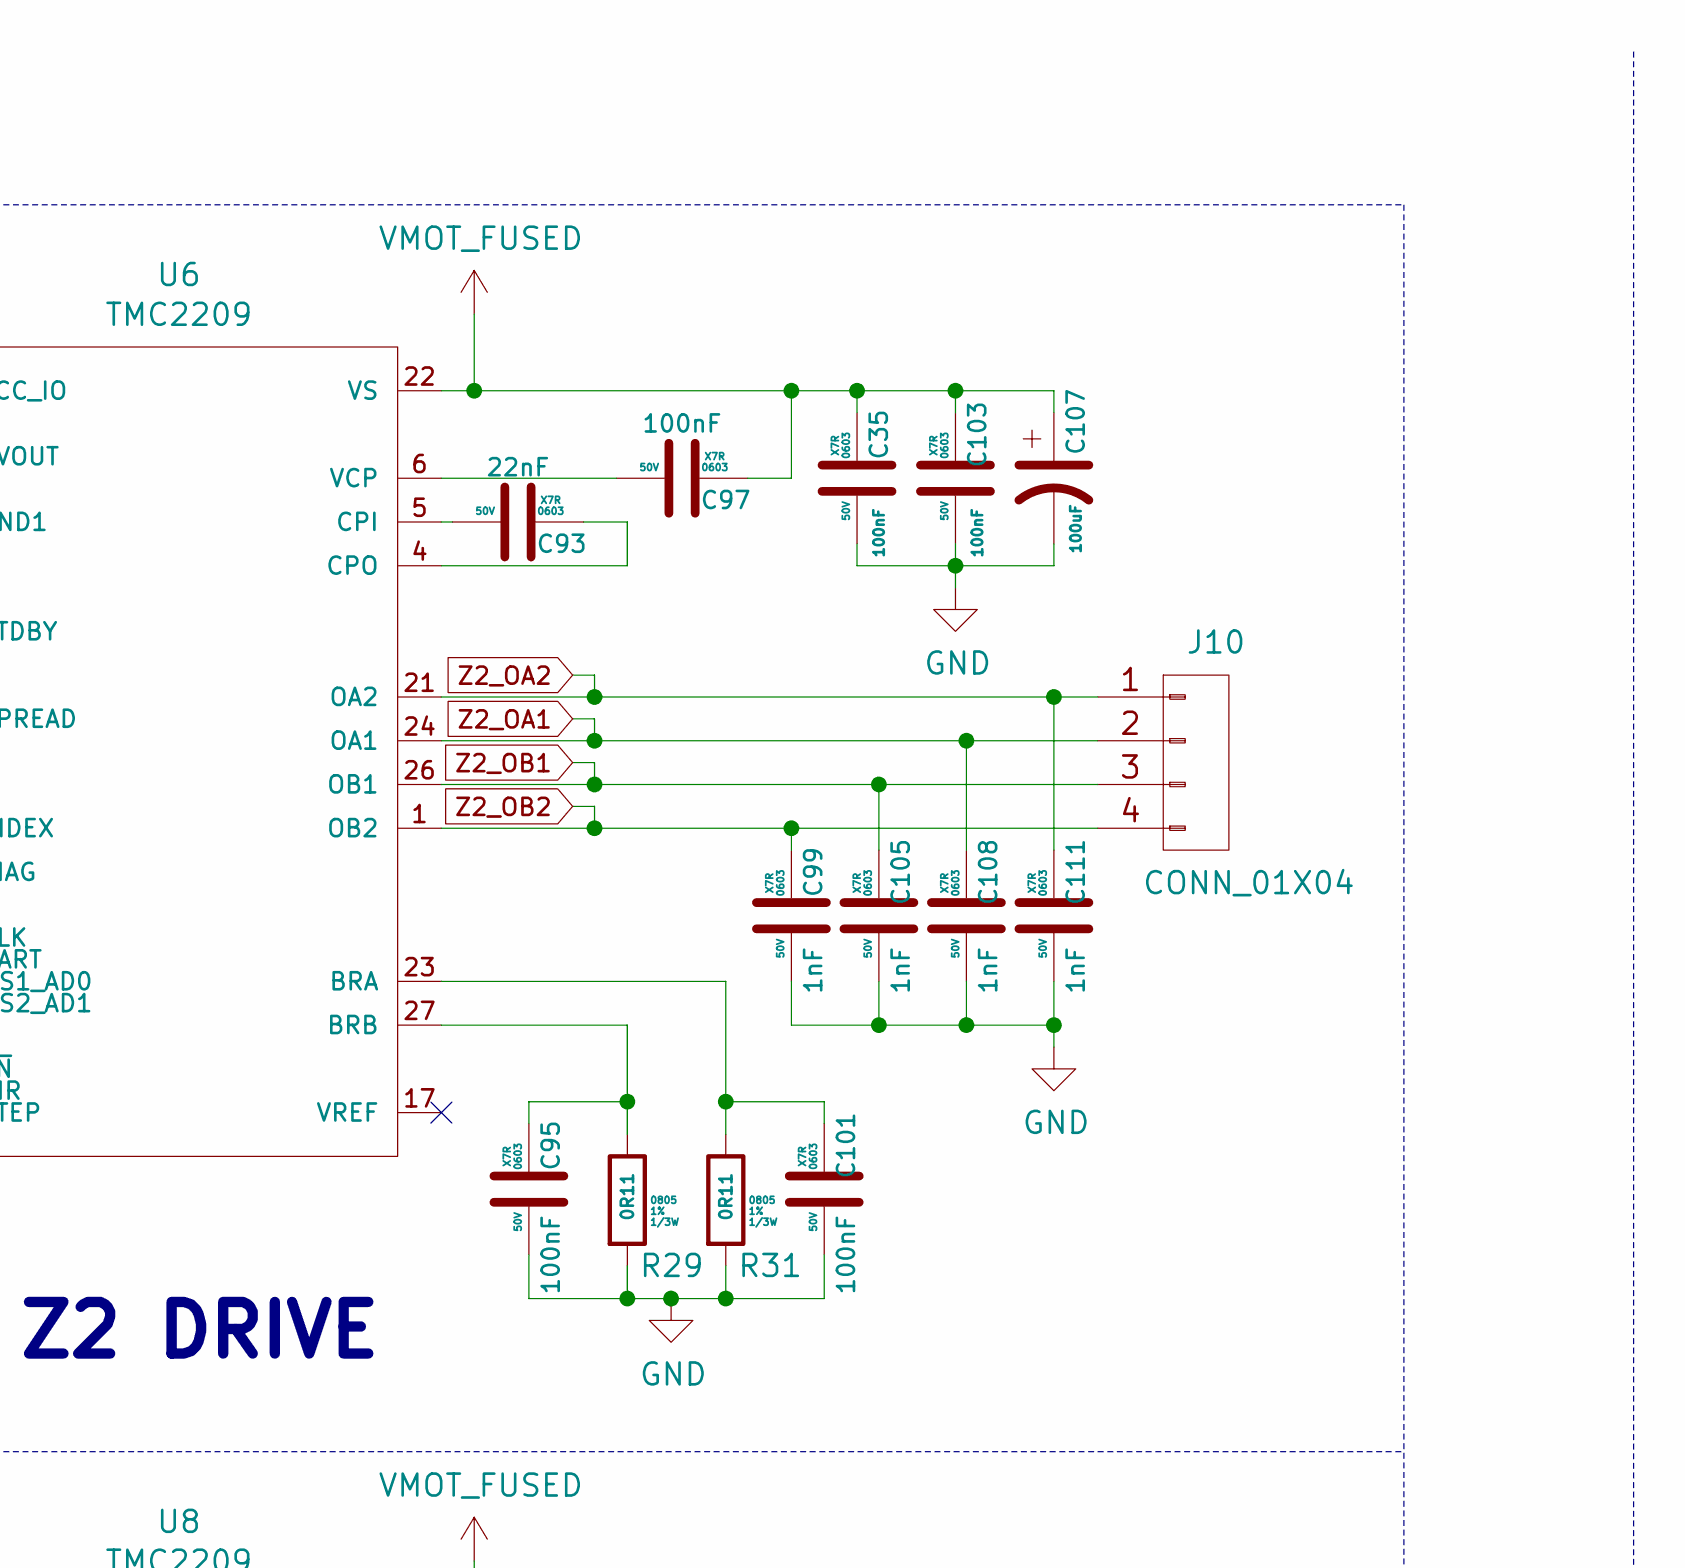
[picture p11: schematic StepperZ1234.sch, Taco Raven, part in row 1, column 3]

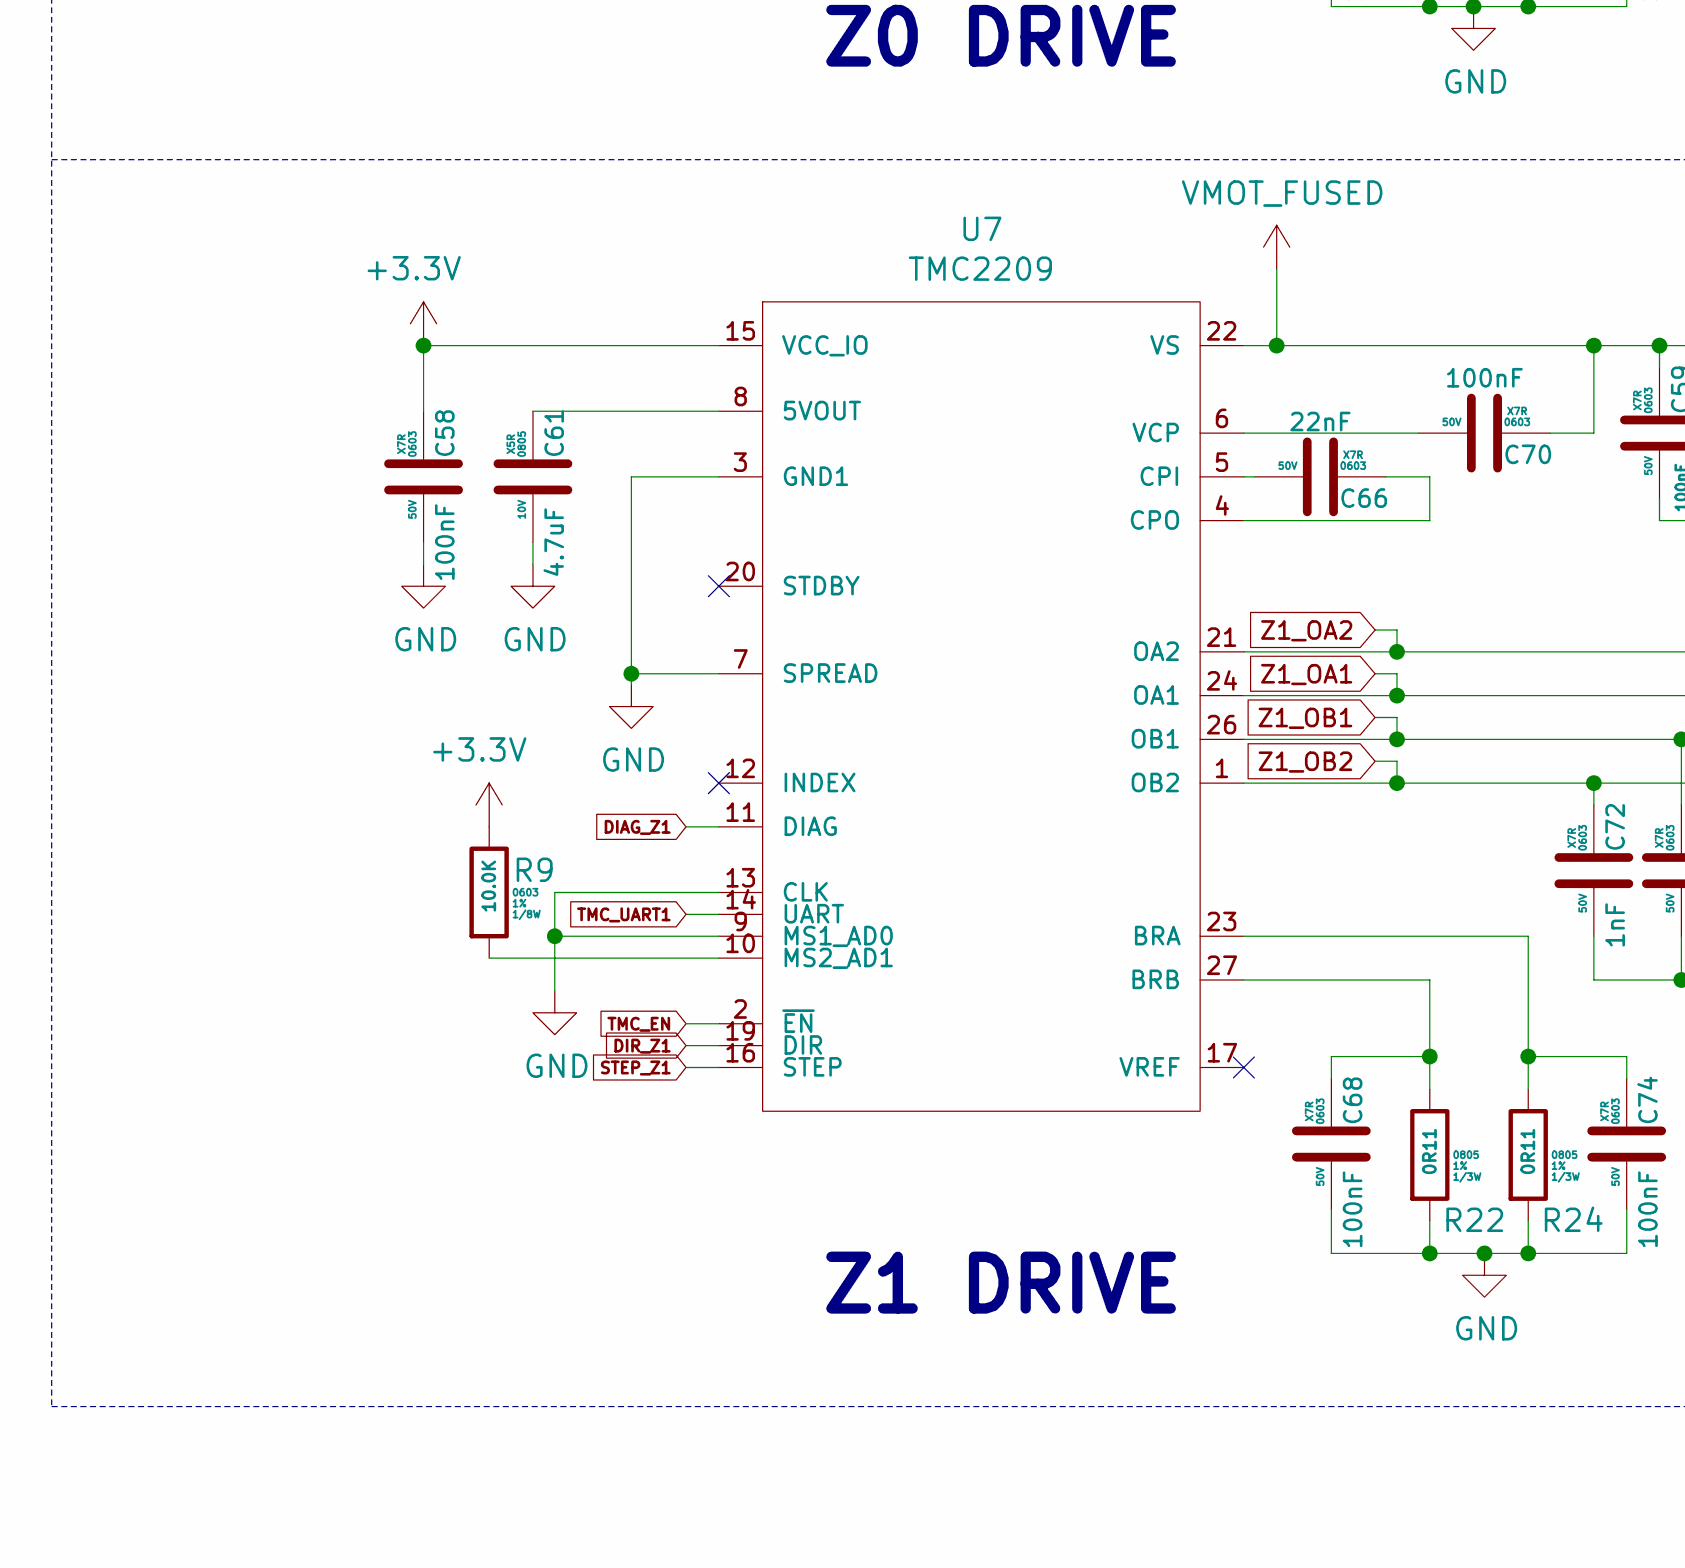
[picture p12: schematic StepperZ1234.sch, Taco Raven, part in row 2, column 1]

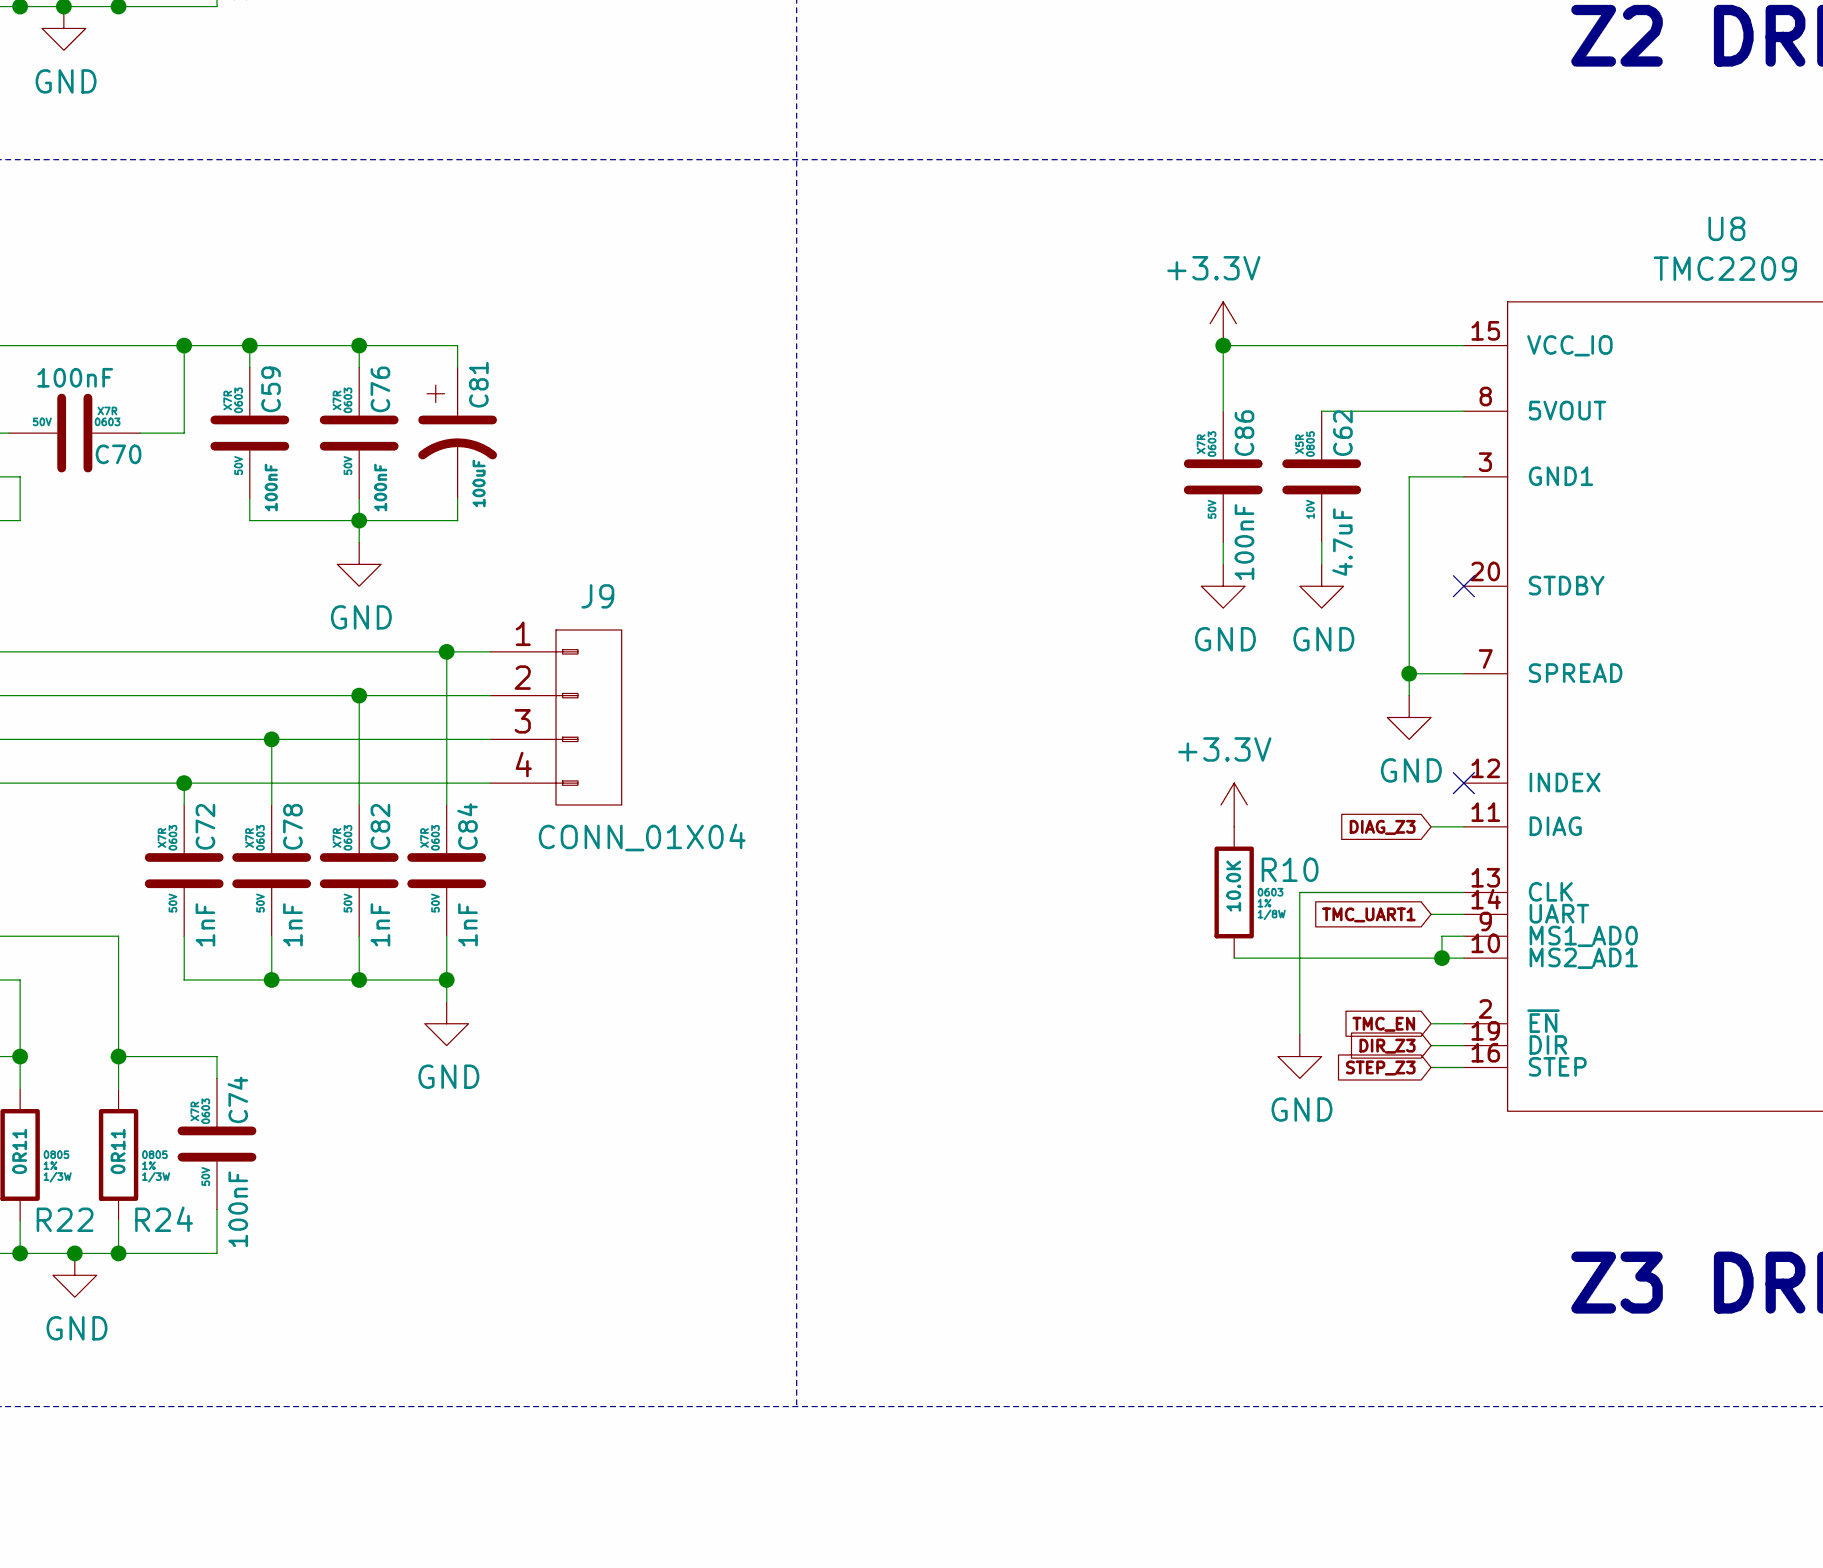
[picture p13: schematic StepperZ1234.sch, Taco Raven, part in row 2, column 2]

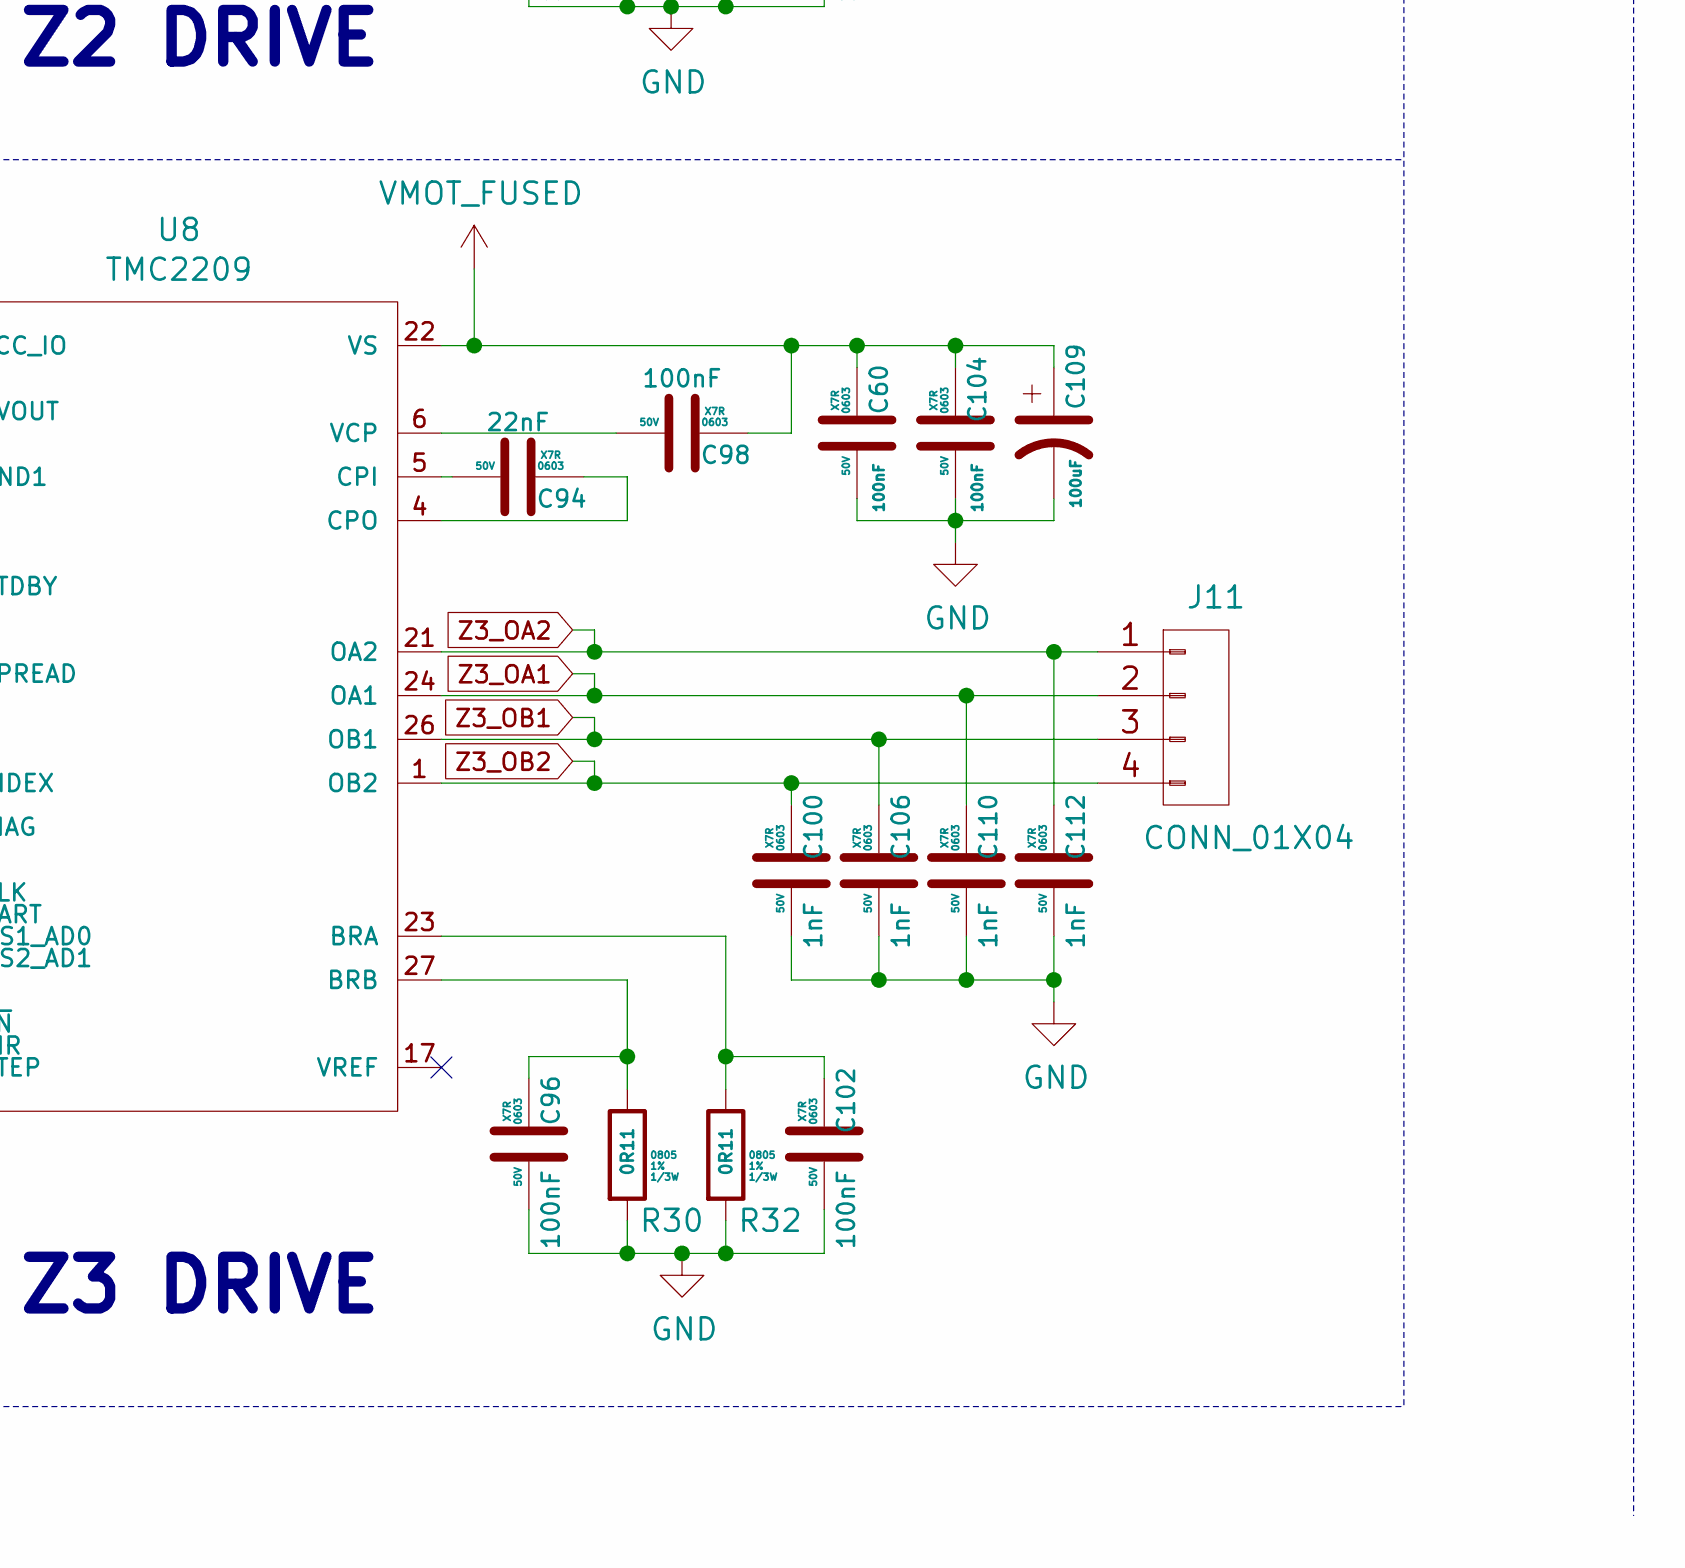
[picture p14: schematic StepperZ1234.sch, Taco Raven, part in row 2, column 3]

Parts:
C33, C35, C57, C58, C59, C60, C67, C68, C69, C70, C73, C74, C75, C76, C85, C86, C95, C96, C97, C98, C101, C102, C103, C104: 100nF; C_0603; Voltage 50V; MFG PN CC0603KRX7R9BB104; Digikey P/N 311-1344-1-ND
C34, C36, C61, C62: 4.7uF; C_0805; Voltage 10V; MFG PN CL21A475KPFNNNG; Digikey P/N 1276-6464-1-ND
C65, C66, C93, C94: 22nF; C_0603; Voltage 50V; MFG PN CL10B223KB8WPNC; Digikey P/N 311-3601-1-ND
C71, C72, C77, C78, C80, C82, C83, C84, C99, C100, C105, C106, C108, C110, C111, C112: 1nF; C_0603; Voltage 50V; MFG PN CC0603KRX7R9BB102; Digikey P/N 311-1080-1-ND
C79, C81, C107, C109: 100uF; CP_Elec_6.3x7.7; Voltage 50V; MFG PN EMZR500ARA101MF80G; Digikey P/N 565-5153-1-ND
J8, J9, J10, J11: CONN_01X04; Molex_KK_1X4; MFG PN 0022232041; Digikey P/N WM4202-ND
R4, R9, R10: 10.0K; R_0603; Tolerance 1%; MFG PN RNCP0603FTD10K0; Digikey P/N RNCP0603FTD10K0CT-ND
R21, R22, R23, R24, R29: 0R11; R_0805; Tolerance 1%; MFG PN RL1220S-R11-F; Digikey P/N RL12S.11FCT-ND
R30, R31, R32: 0R11; R_0805; Tolerance 1%; MFG PN RL1220S-R11-F; Digikey P/N RL12S.22FCT-ND
U5, U6, U7, U8: TMC2209; QFN-28_EP_5x5_Pitch0.5mm

Connections:
+3.3V: C57.2, C58.2, C85.2, C86.2, R4.1, R9.1, R10.1, U5.15 (VCC_IO), U6.15 (VCC_IO), U7.15 (VCC_IO), U8.15 (VCC_IO); also elsewhere on the board
DIAG_Z0: U5.11 (DIAG); also elsewhere on the board
DIAG_Z1: U7.11 (DIAG); also elsewhere on the board
DIAG_Z2: U6.11 (DIAG); also elsewhere on the board
DIAG_Z3: U8.11 (DIAG); also elsewhere on the board
DIR_Z0: U5.19 (DIR); also elsewhere on the board
DIR_Z1: U7.19 (DIR); also elsewhere on the board
DIR_Z2: U6.19 (DIR); also elsewhere on the board
DIR_Z3: U8.19 (DIR); also elsewhere on the board
GND: C33.1, C34.1, C35.1, C36.1, C57.1, C58.1, C59.1, C60.1, C61.1, C62.1, C67.1, C68.1, C71.1, C72.1, C73.1, C74.1, C75.1, C76.1, C77.1, C78.1, C79.2, C80.1, C81.2, C82.1, C83.1, C84.1, C85.1, C86.1, C95.1, C96.1, C99.1, C100.1, C101.1, C102.1, C103.1, C104.1, C105.1, C106.1, C107.2, C108.1, C109.2, C110.1, C111.1, C112.1, R21.2, R22.2, R23.2, R24.2, R29.2, R30.2, R31.2, R32.2, U5.3 (GND1), U5.7 (SPREAD), U5.9 (MS1_AD0), U5.10 (MS2_AD1), U5.13 (CLK), U5.18 (GND2), U5.25 (GND3), U5.29 (G_PAD), U6.3 (GND1), U6.7 (SPREAD), U6.10 (MS2_AD1), U6.13 (CLK), U6.18 (GND2), U6.25 (GND3), U6.29 (G_PAD), U7.3 (GND1), U7.7 (SPREAD), U7.9 (MS1_AD0), U7.13 (CLK), U7.18 (GND2), U7.25 (GND3), U7.29 (G_PAD), U8.3 (GND1), U8.7 (SPREAD), U8.13 (CLK), U8.18 (GND2), U8.25 (GND3), U8.29 (G_PAD); also elsewhere on the board
unnamed: C34.2, U5.8 (5VOUT)
unnamed: C36.2, U6.8 (5VOUT)
unnamed: C61.2, U7.8 (5VOUT)
unnamed: C62.2, U8.8 (5VOUT)
unnamed: C65.1, U5.5 (CPI)
unnamed: C65.2, U5.4 (CPO)
unnamed: C66.1, U7.5 (CPI)
unnamed: C66.2, U7.4 (CPO)
unnamed: C67.2, R21.1, U5.27 (BRB)
unnamed: C68.2, R22.1, U7.27 (BRB)
unnamed: C69.1, U5.6 (VCP)
unnamed: C70.1, U7.6 (VCP)
unnamed: C73.2, R23.1, U5.23 (BRA)
unnamed: C74.2, R24.1, U7.23 (BRA)
unnamed: C93.1, U6.5 (CPI)
unnamed: C93.2, U6.4 (CPO)
unnamed: C94.1, U8.5 (CPI)
unnamed: C94.2, U8.4 (CPO)
unnamed: C95.2, R29.1, U6.27 (BRB)
unnamed: C96.2, R30.1, U8.27 (BRB)
unnamed: C97.1, U6.6 (VCP)
unnamed: C98.1, U8.6 (VCP)
unnamed: C101.2, R31.1, U6.23 (BRA)
unnamed: C102.2, R32.1, U8.23 (BRA)
unnamed: R4.2, U6.9 (MS1_AD0)
unnamed: R9.2, U7.10 (MS2_AD1)
unnamed: R10.2, U8.9 (MS1_AD0), U8.10 (MS2_AD1)
STEP_Z0: U5.16 (STEP); also elsewhere on the board
STEP_Z1: U7.16 (STEP); also elsewhere on the board
STEP_Z2: U6.16 (STEP); also elsewhere on the board
STEP_Z3: U8.16 (STEP); also elsewhere on the board
TMC_EN: U5.2 (~EN), U6.2 (~EN), U7.2 (~EN), U8.2 (~EN); also elsewhere on the board
TMC_UART1: U5.14 (UART), U6.14 (UART), U7.14 (UART), U8.14 (UART); also elsewhere on the board
VMOT_FUSED: C33.2, C35.2, C59.2, C60.2, C69.2, C70.2, C75.2, C76.2, C79.1, C81.1, C97.2, C98.2, C103.2, C104.2, C107.1, C109.1, U5.22 (VS), U5.28 (VS), U6.22 (VS), U6.28 (VS), U7.22 (VS), U7.28 (VS), U8.22 (VS), U8.28 (VS); also elsewhere on the board
Z0_OA1: C80.2, J8.2, U5.24 (OA1)
Z0_OA2: C83.2, J8.1, U5.21 (OA2)
Z0_OB1: C77.2, J8.3, U5.26 (OB1)
Z0_OB2: C71.2, J8.4, U5.1 (OB2)
Z1_OA1: C82.2, J9.2, U7.24 (OA1)
Z1_OA2: C84.2, J9.1, U7.21 (OA2)
Z1_OB1: C78.2, J9.3, U7.26 (OB1)
Z1_OB2: C72.2, J9.4, U7.1 (OB2)
Z2_OA1: C108.2, J10.2, U6.24 (OA1)
Z2_OA2: C111.2, J10.1, U6.21 (OA2)
Z2_OB1: C105.2, J10.3, U6.26 (OB1)
Z2_OB2: C99.2, J10.4, U6.1 (OB2)
Z3_OA1: C110.2, J11.2, U8.24 (OA1)
Z3_OA2: C112.2, J11.1, U8.21 (OA2)
Z3_OB1: C106.2, J11.3, U8.26 (OB1)
Z3_OB2: C100.2, J11.4, U8.1 (OB2)

Notes on the sheet:
Z0 DRIVE
Z1 DRIVE
Z2 DRIVE
Z3 DRIVE
