twmiv/Voron-Hardware/Taco_Raven/KiCad/Voron_Klipper_Board.kicad_pcb

## KiCad design Taco_Raven/KiCad/Voron_Klipper_Board.kicad_pcb (continued)

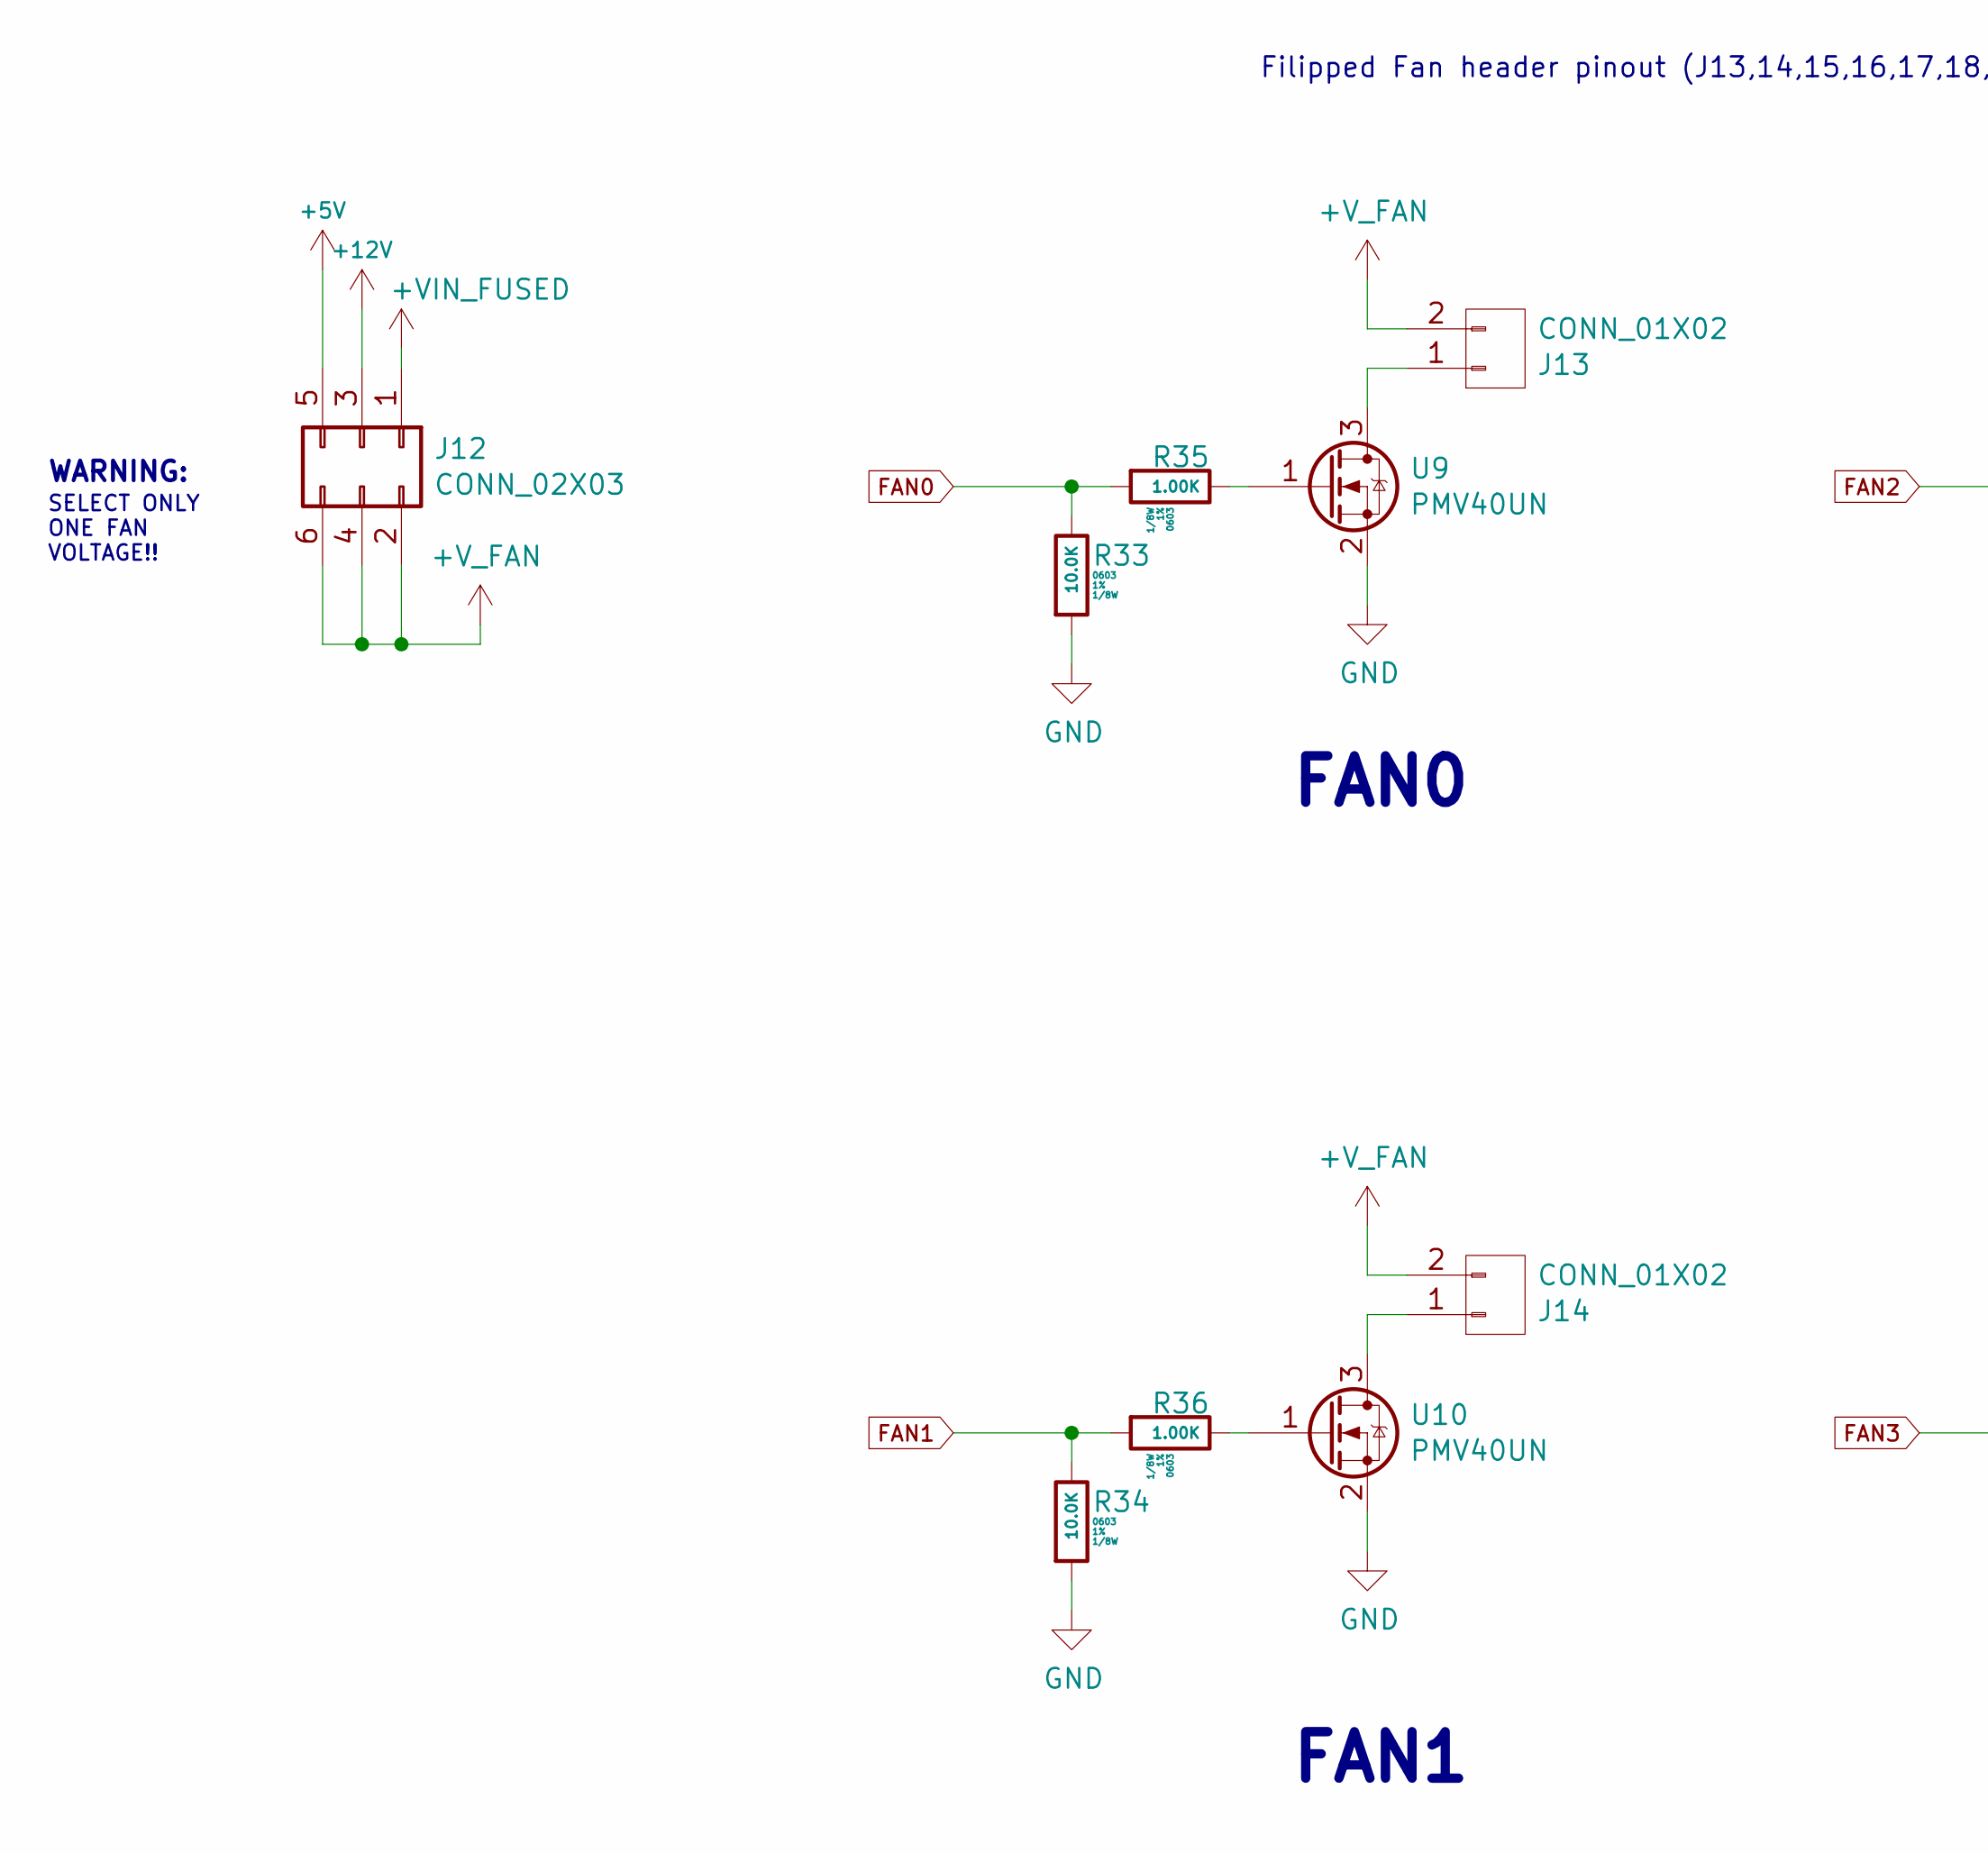
[picture p15: schematic FANS.sch, Taco Raven, part in row 1, column 1]

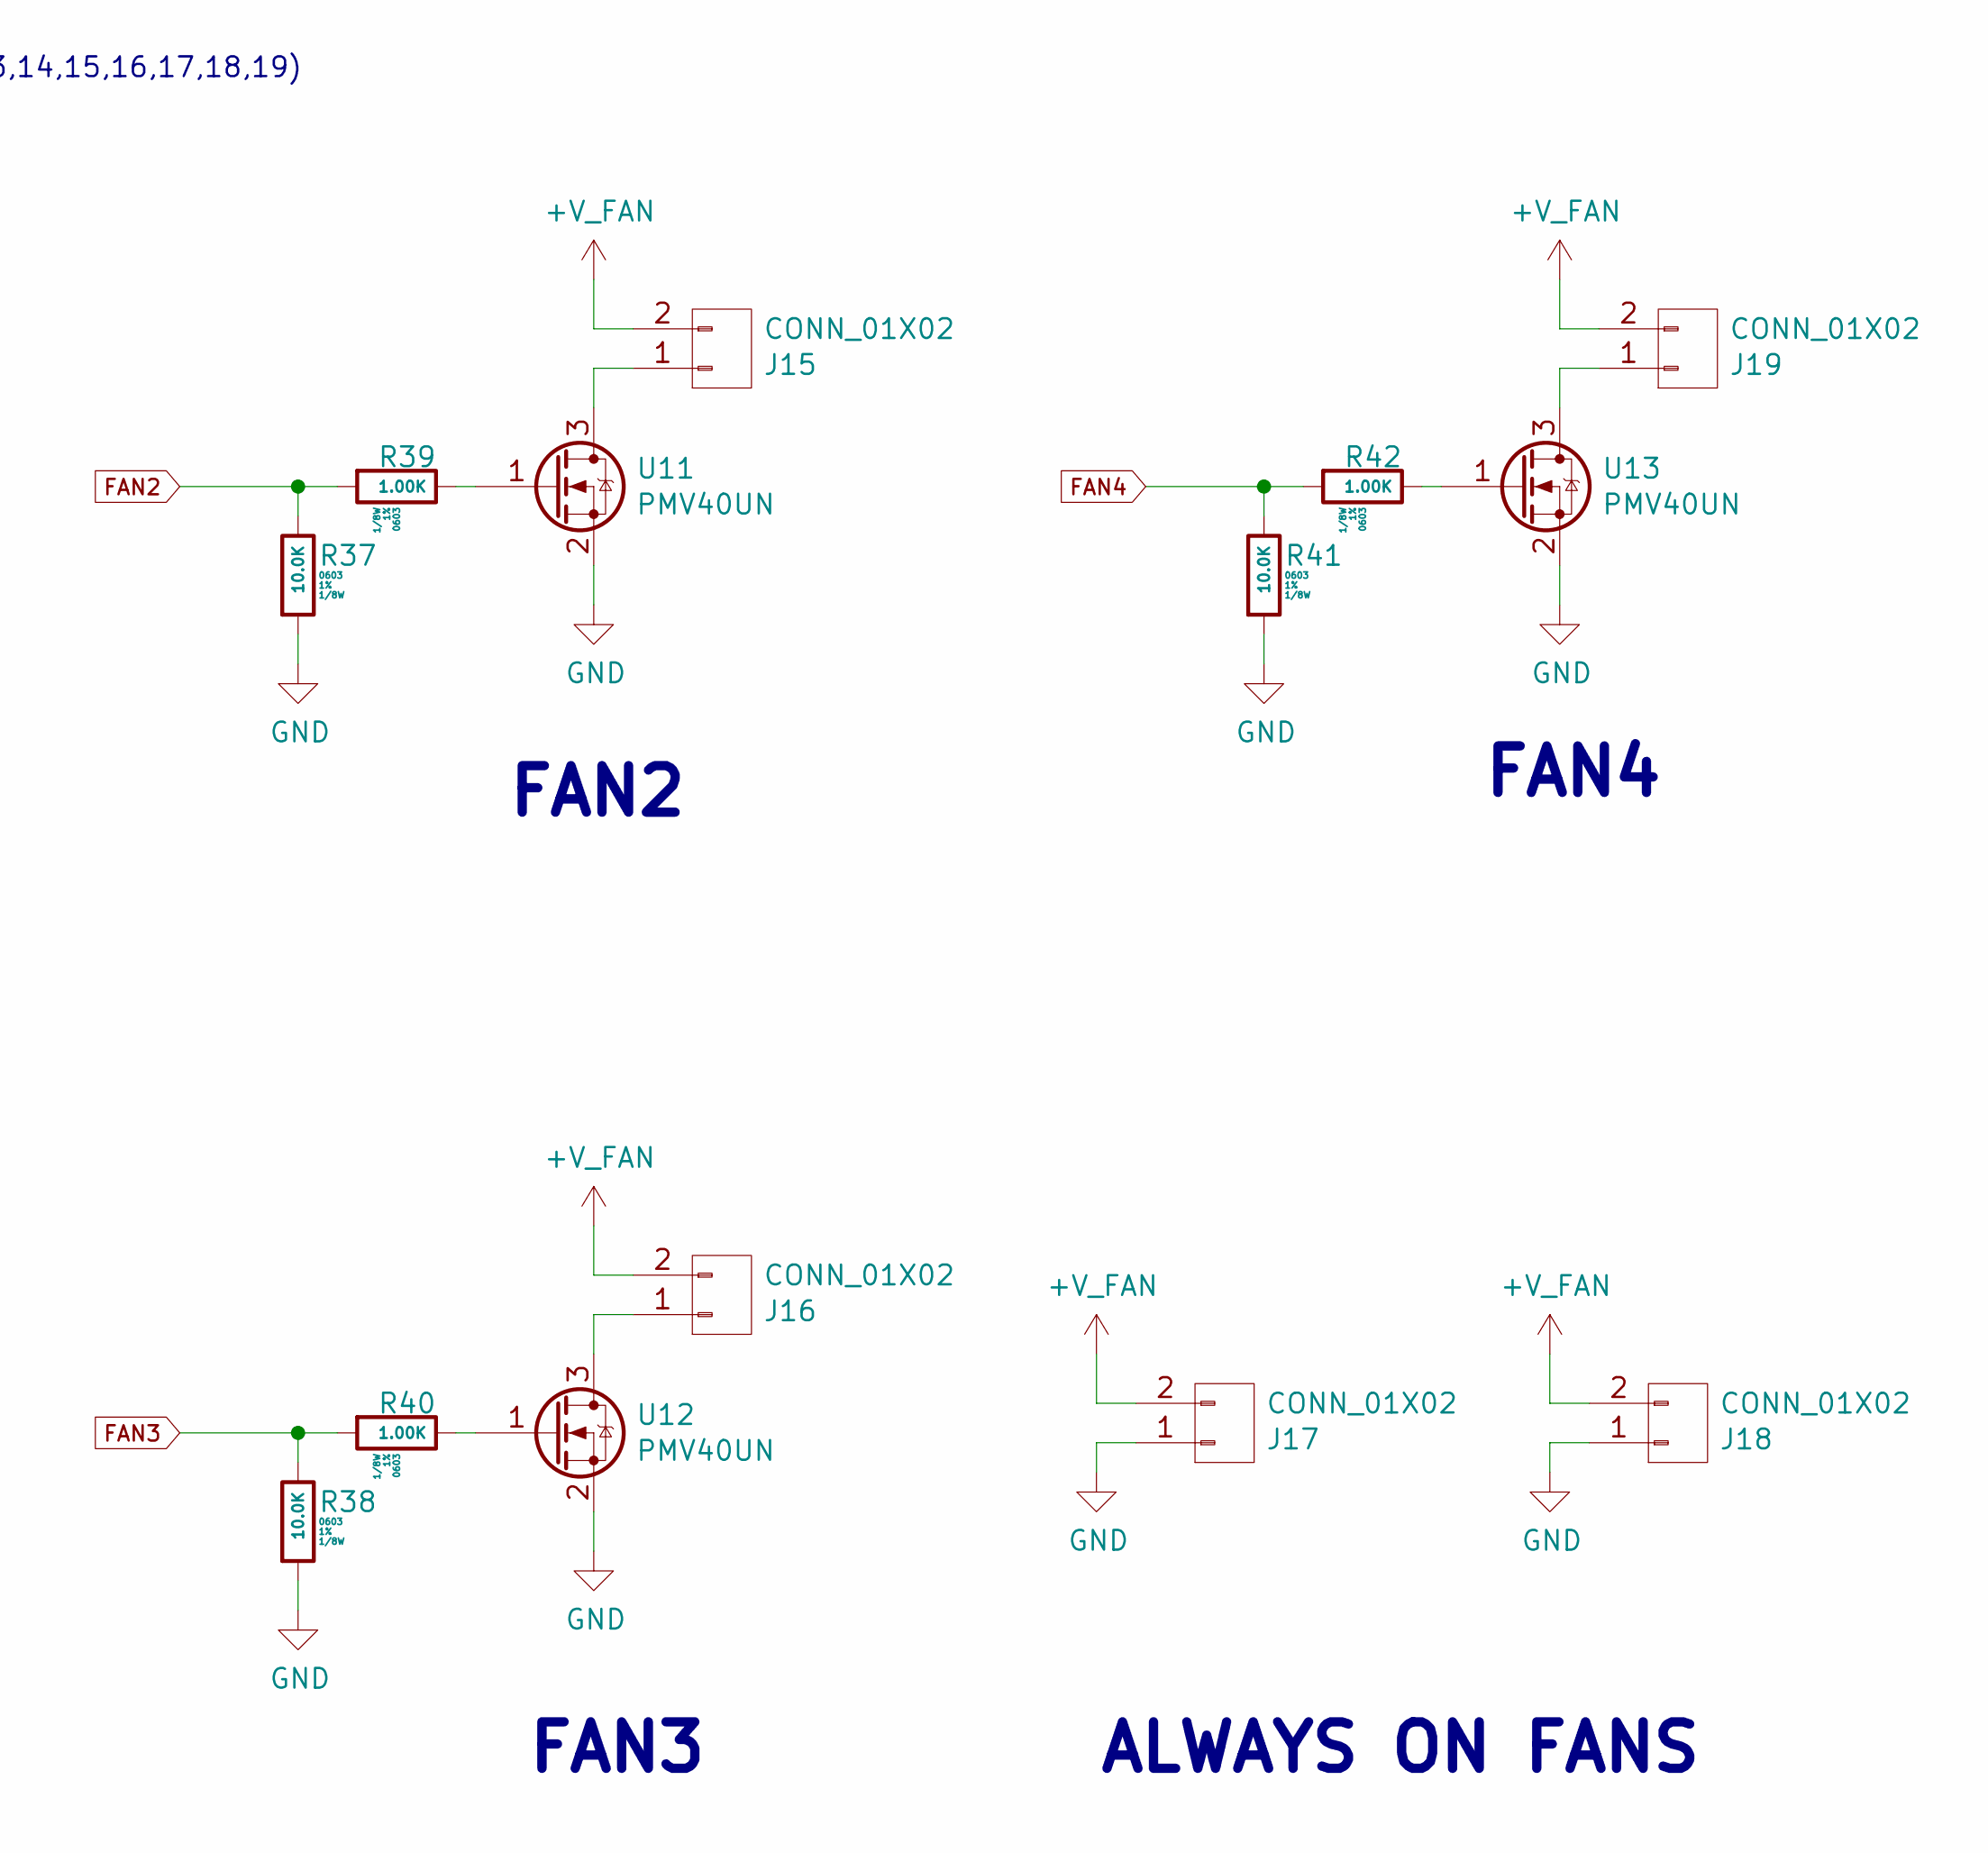
[picture p16: schematic FANS.sch, Taco Raven, part in row 1, column 2]

Parts:
J12: CONN_02X03; PinHeader_2x03_P2.54mm_Vertical; MFG PN M20-9980346; Digikey P/N 952-2121-ND
J13, J14, J15, J16, J17, J18, J19: CONN_01X02; Molex_KK_1X2; MFG PN 22-23-2021; Digikey P/N WM4200-ND
R33, R34, R37, R38, R41: 10.0K; R_0603; Tolerance 1%; MFG PN RNCP0603FTD10K0; Digikey P/N RNCP0603FTD10K0CT-ND
R35, R36, R39, R40, R42: 1.00K; R_0603; Tolerance 1%; MFG PN RNCP0603FTD1K00; Digikey P/N RNCP0603FTD1K00CT-ND
U9, U10, U11, U12, U13: PMV40UN; SOT-23; MFG PN PMV40UN2R; Digikey P/N 1727-1900-1-ND

Connections:
+5V: J12.5; also elsewhere on the board
+12V: J12.3; also elsewhere on the board
+VIN_FUSED: J12.1; also elsewhere on the board
+V_FAN: J12.2, J12.4, J12.6, J13.2, J14.2, J15.2, J16.2, J17.2, J18.2, J19.2
FAN0: R33.1, R35.2; also elsewhere on the board
FAN1: R34.1, R36.2; also elsewhere on the board
FAN2: R37.1, R39.2; also elsewhere on the board
FAN3: R38.1, R40.2; also elsewhere on the board
FAN4: R41.1, R42.2; also elsewhere on the board
GND: J17.1, J18.1, R33.2, R34.2, R37.2, R38.2, R41.2, U9.2, U10.2, U11.2, U12.2, U13.2; also elsewhere on the board
unnamed: J13.1, U9.3
unnamed: J14.1, U10.3
unnamed: J15.1, U11.3
unnamed: J16.1, U12.3
unnamed: J19.1, U13.3
unnamed: R35.1, U9.1
unnamed: R36.1, U10.1
unnamed: R39.1, U11.1
unnamed: R40.1, U12.1
unnamed: R42.1, U13.1

Notes on the sheet:
FAN0
FAN1
FAN2
FAN3
FAN4
ALWAYS ON FANS
SELECT ONLY ONE FAN VOLTAGE!!
WARNING:
Filipped Fan header pinout (J13,14,15,16,17,18,19)

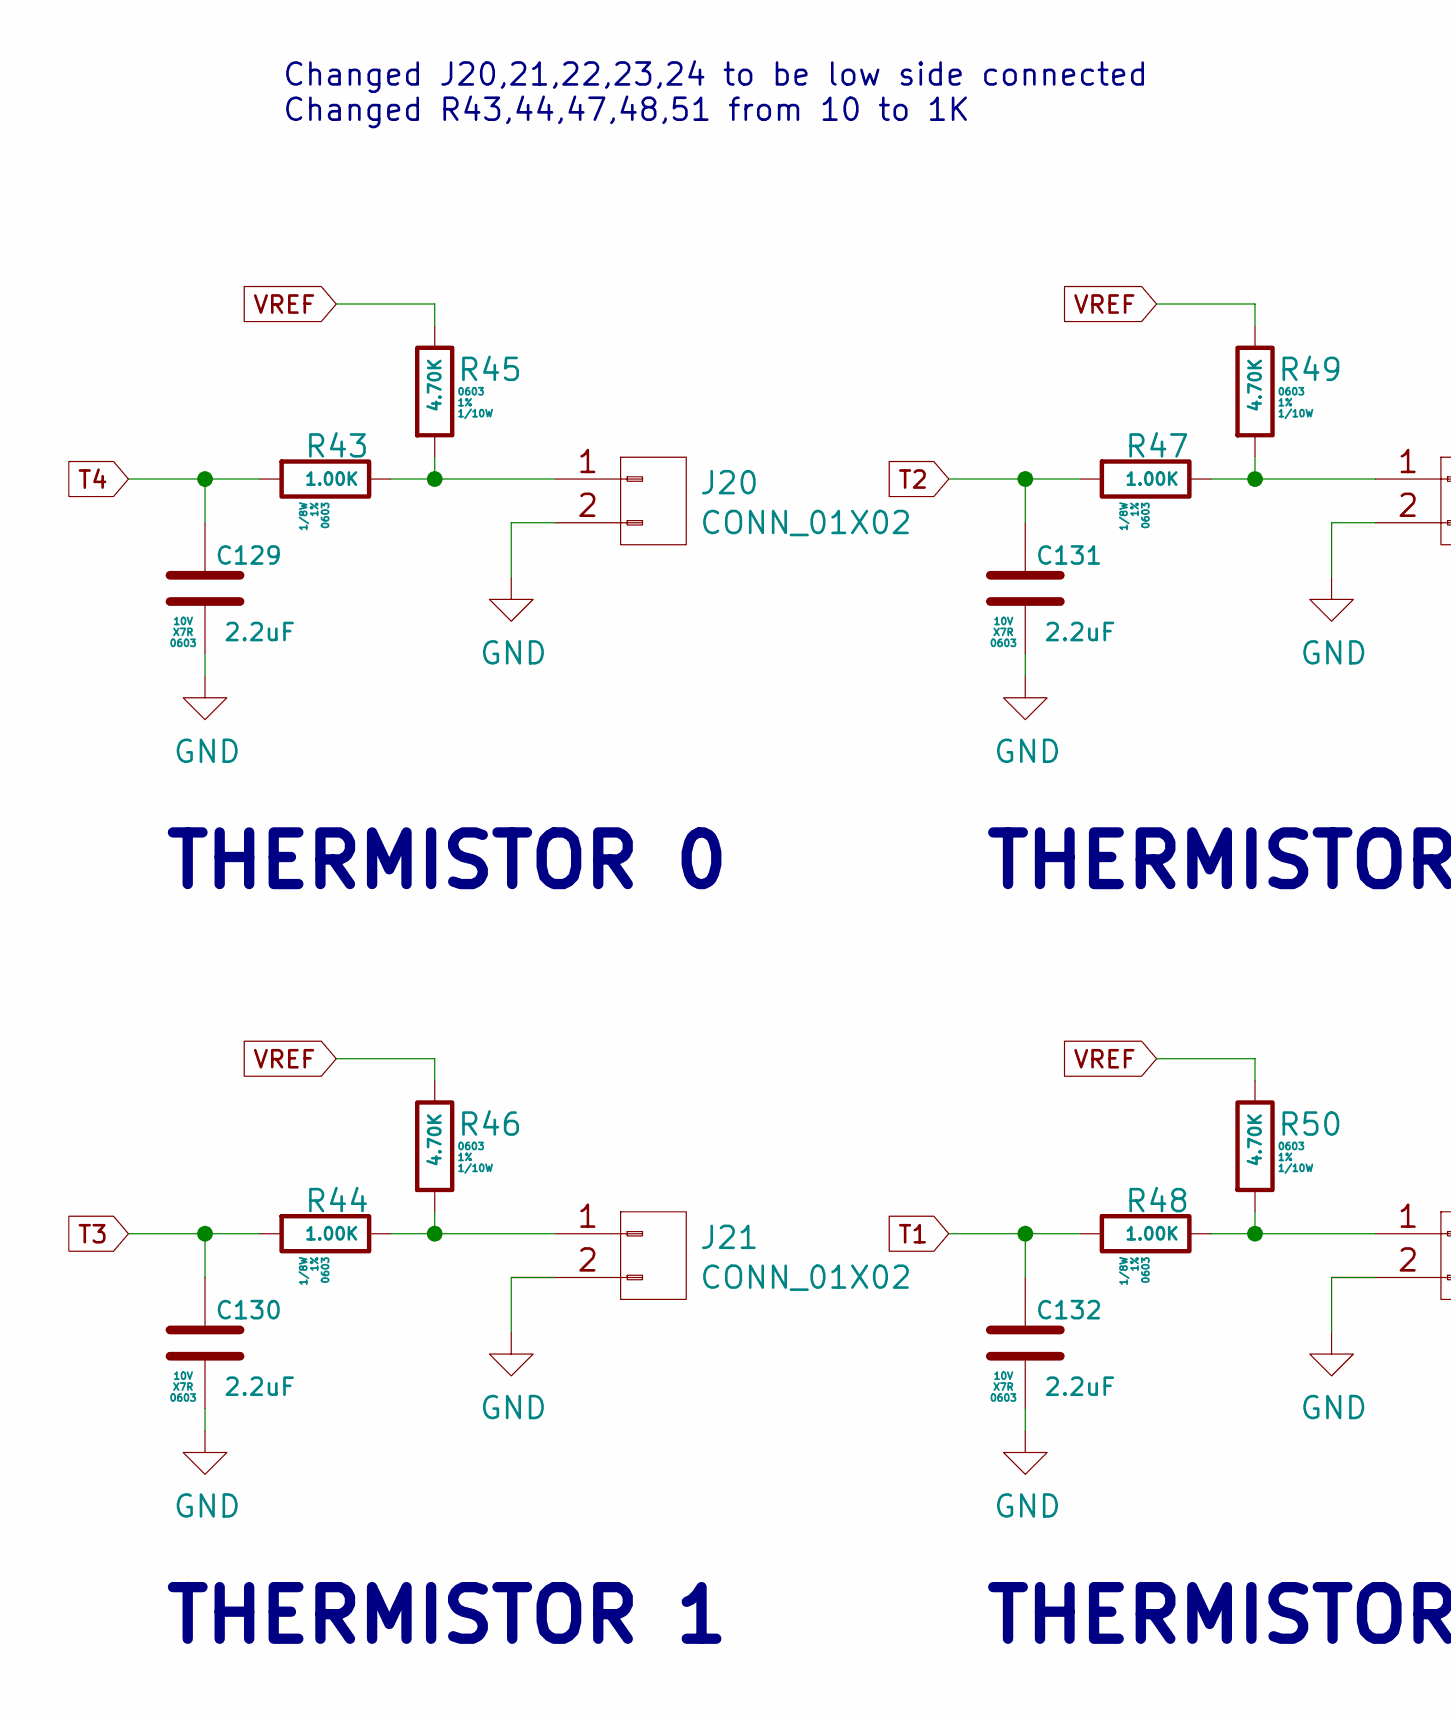
[picture p17: schematic Thermistors.sch, Taco Raven, part in row 1, column 1]

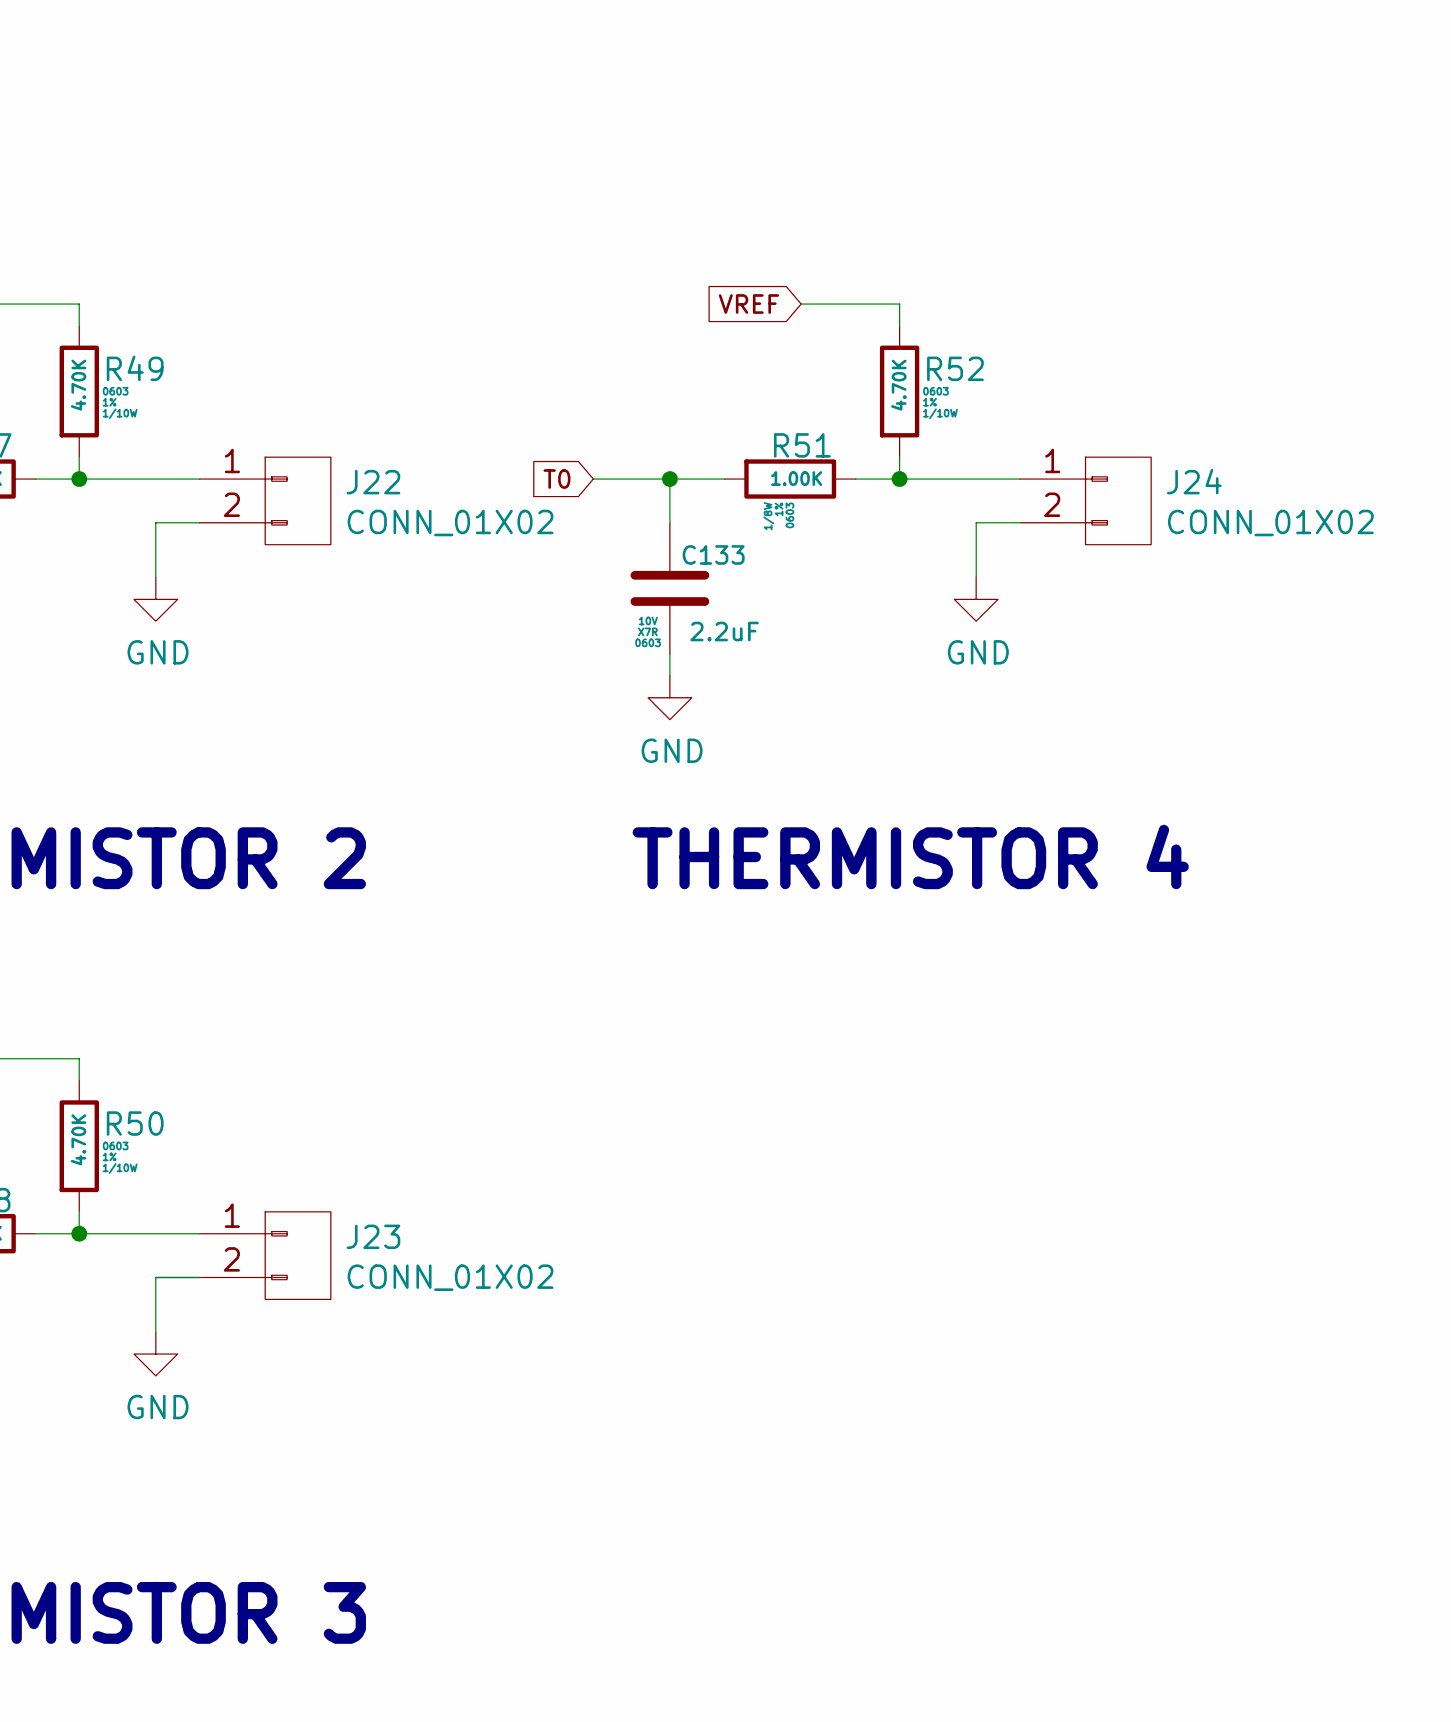
[picture p18: schematic Thermistors.sch, Taco Raven, part in row 1, column 2]

Parts:
C129, C130, C131, C132, C133: 2.2uF; C_0603; Voltage 10V; MFG PN LMK107B7225KA-T; Digikey P/N 587-2983-1-ND
J20, J21, J22, J23, J24: CONN_01X02; Molex_KK_1X2; MFG PN 22-23-2021; Digikey P/N WM4200-ND
R43, R44, R47, R48, R51: 1.00K; R_0603; Tolerance 1%; MFG PN RNCP0603FTD1K00; Digikey P/N RNCP0603FTD1K00CT-ND
R45, R46, R49, R50, R52: 4.70K; R_0603; Tolerance 1%; MFG PN RC0603FR-074K7L; Digikey P/N 311-4.70KHRCT-ND

Connections:
GND: C129.1, C130.1, C131.1, C132.1, C133.1, J20.2, J21.2, J22.2, J23.2, J24.2; also elsewhere on the board
unnamed: J20.1, R43.1, R45.2
unnamed: J21.1, R44.1, R46.2
unnamed: J22.1, R47.1, R49.2
unnamed: J23.1, R48.1, R50.2
unnamed: J24.1, R51.1, R52.2
T0: C133.2, R51.2; also elsewhere on the board
T1: C132.2, R48.2; also elsewhere on the board
T2: C131.2, R47.2; also elsewhere on the board
T3: C130.2, R44.2; also elsewhere on the board
T4: C129.2, R43.2; also elsewhere on the board
VREF: R45.1, R46.1, R49.1, R50.1, R52.1; also elsewhere on the board

Notes on the sheet:
THERMISTOR 0
THERMISTOR 2
THERMISTOR 4
THERMISTOR 1
THERMISTOR 3
Changed J20,21,22,23,24 to be low side connected Changed R43,44,47,48,51 from 10 to 1K
