twmiv/Voron-Hardware/Taco_Raven/KiCad/Voron_Klipper_Board.kicad_pcb

## KiCad design Taco_Raven/KiCad/Voron_Klipper_Board.kicad_pcb (continued)

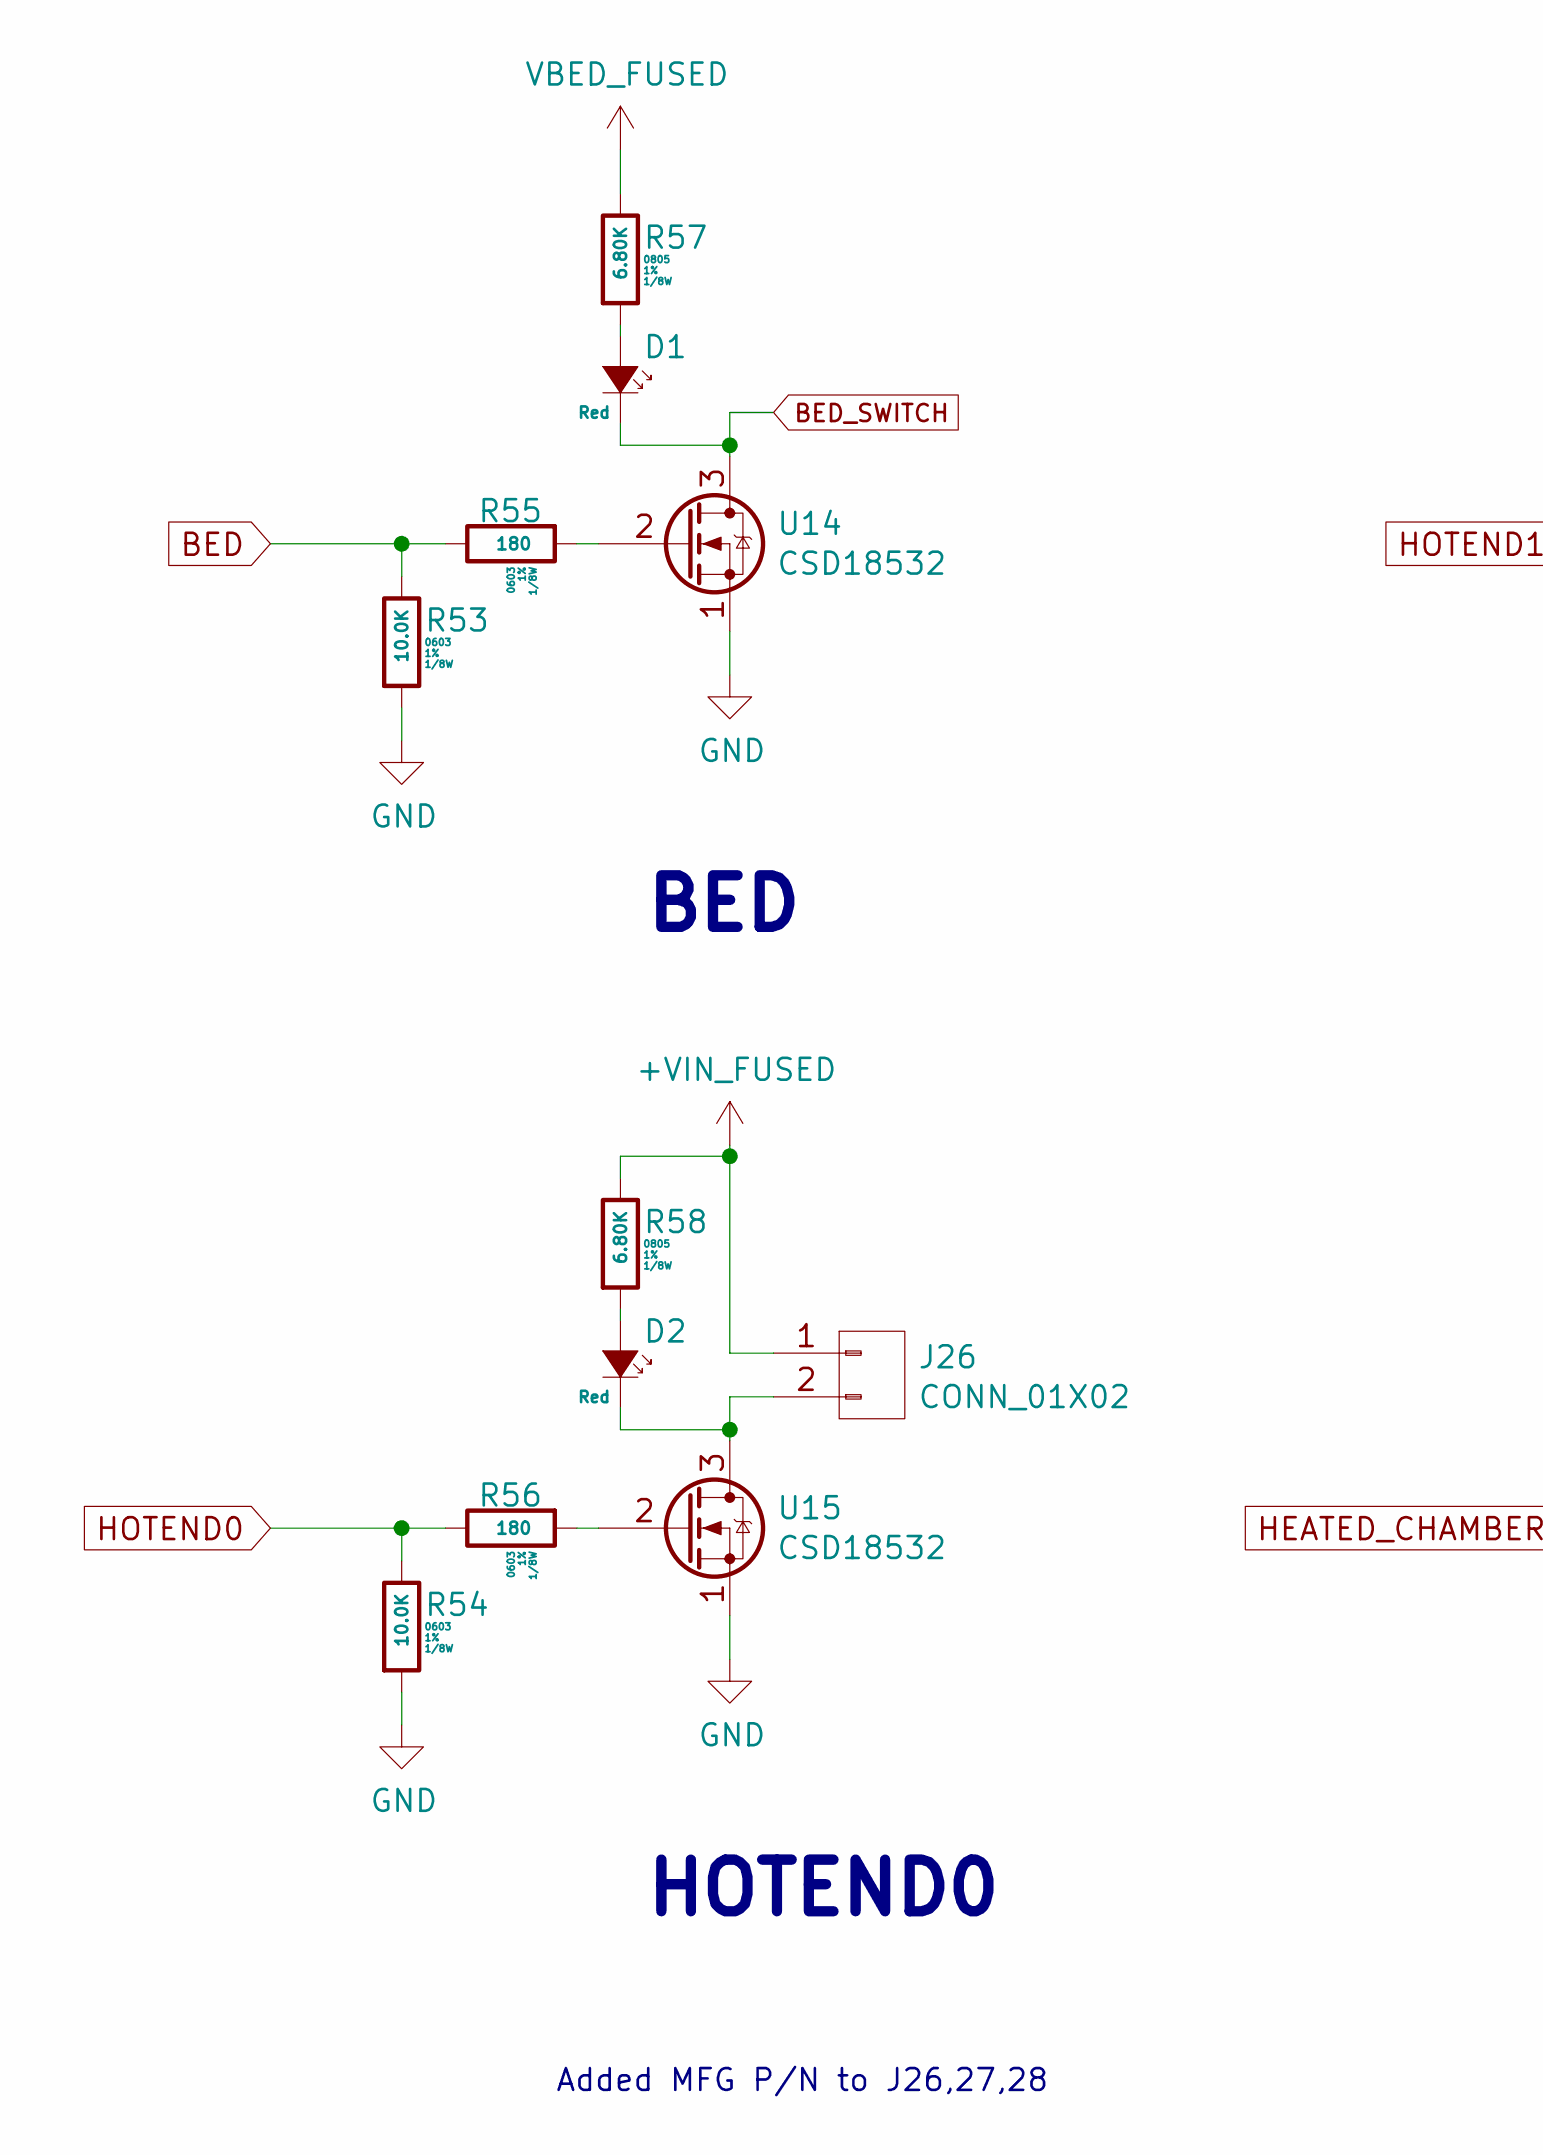
[picture p19: schematic Heaters.sch, Taco Raven, part in row 1, column 1]

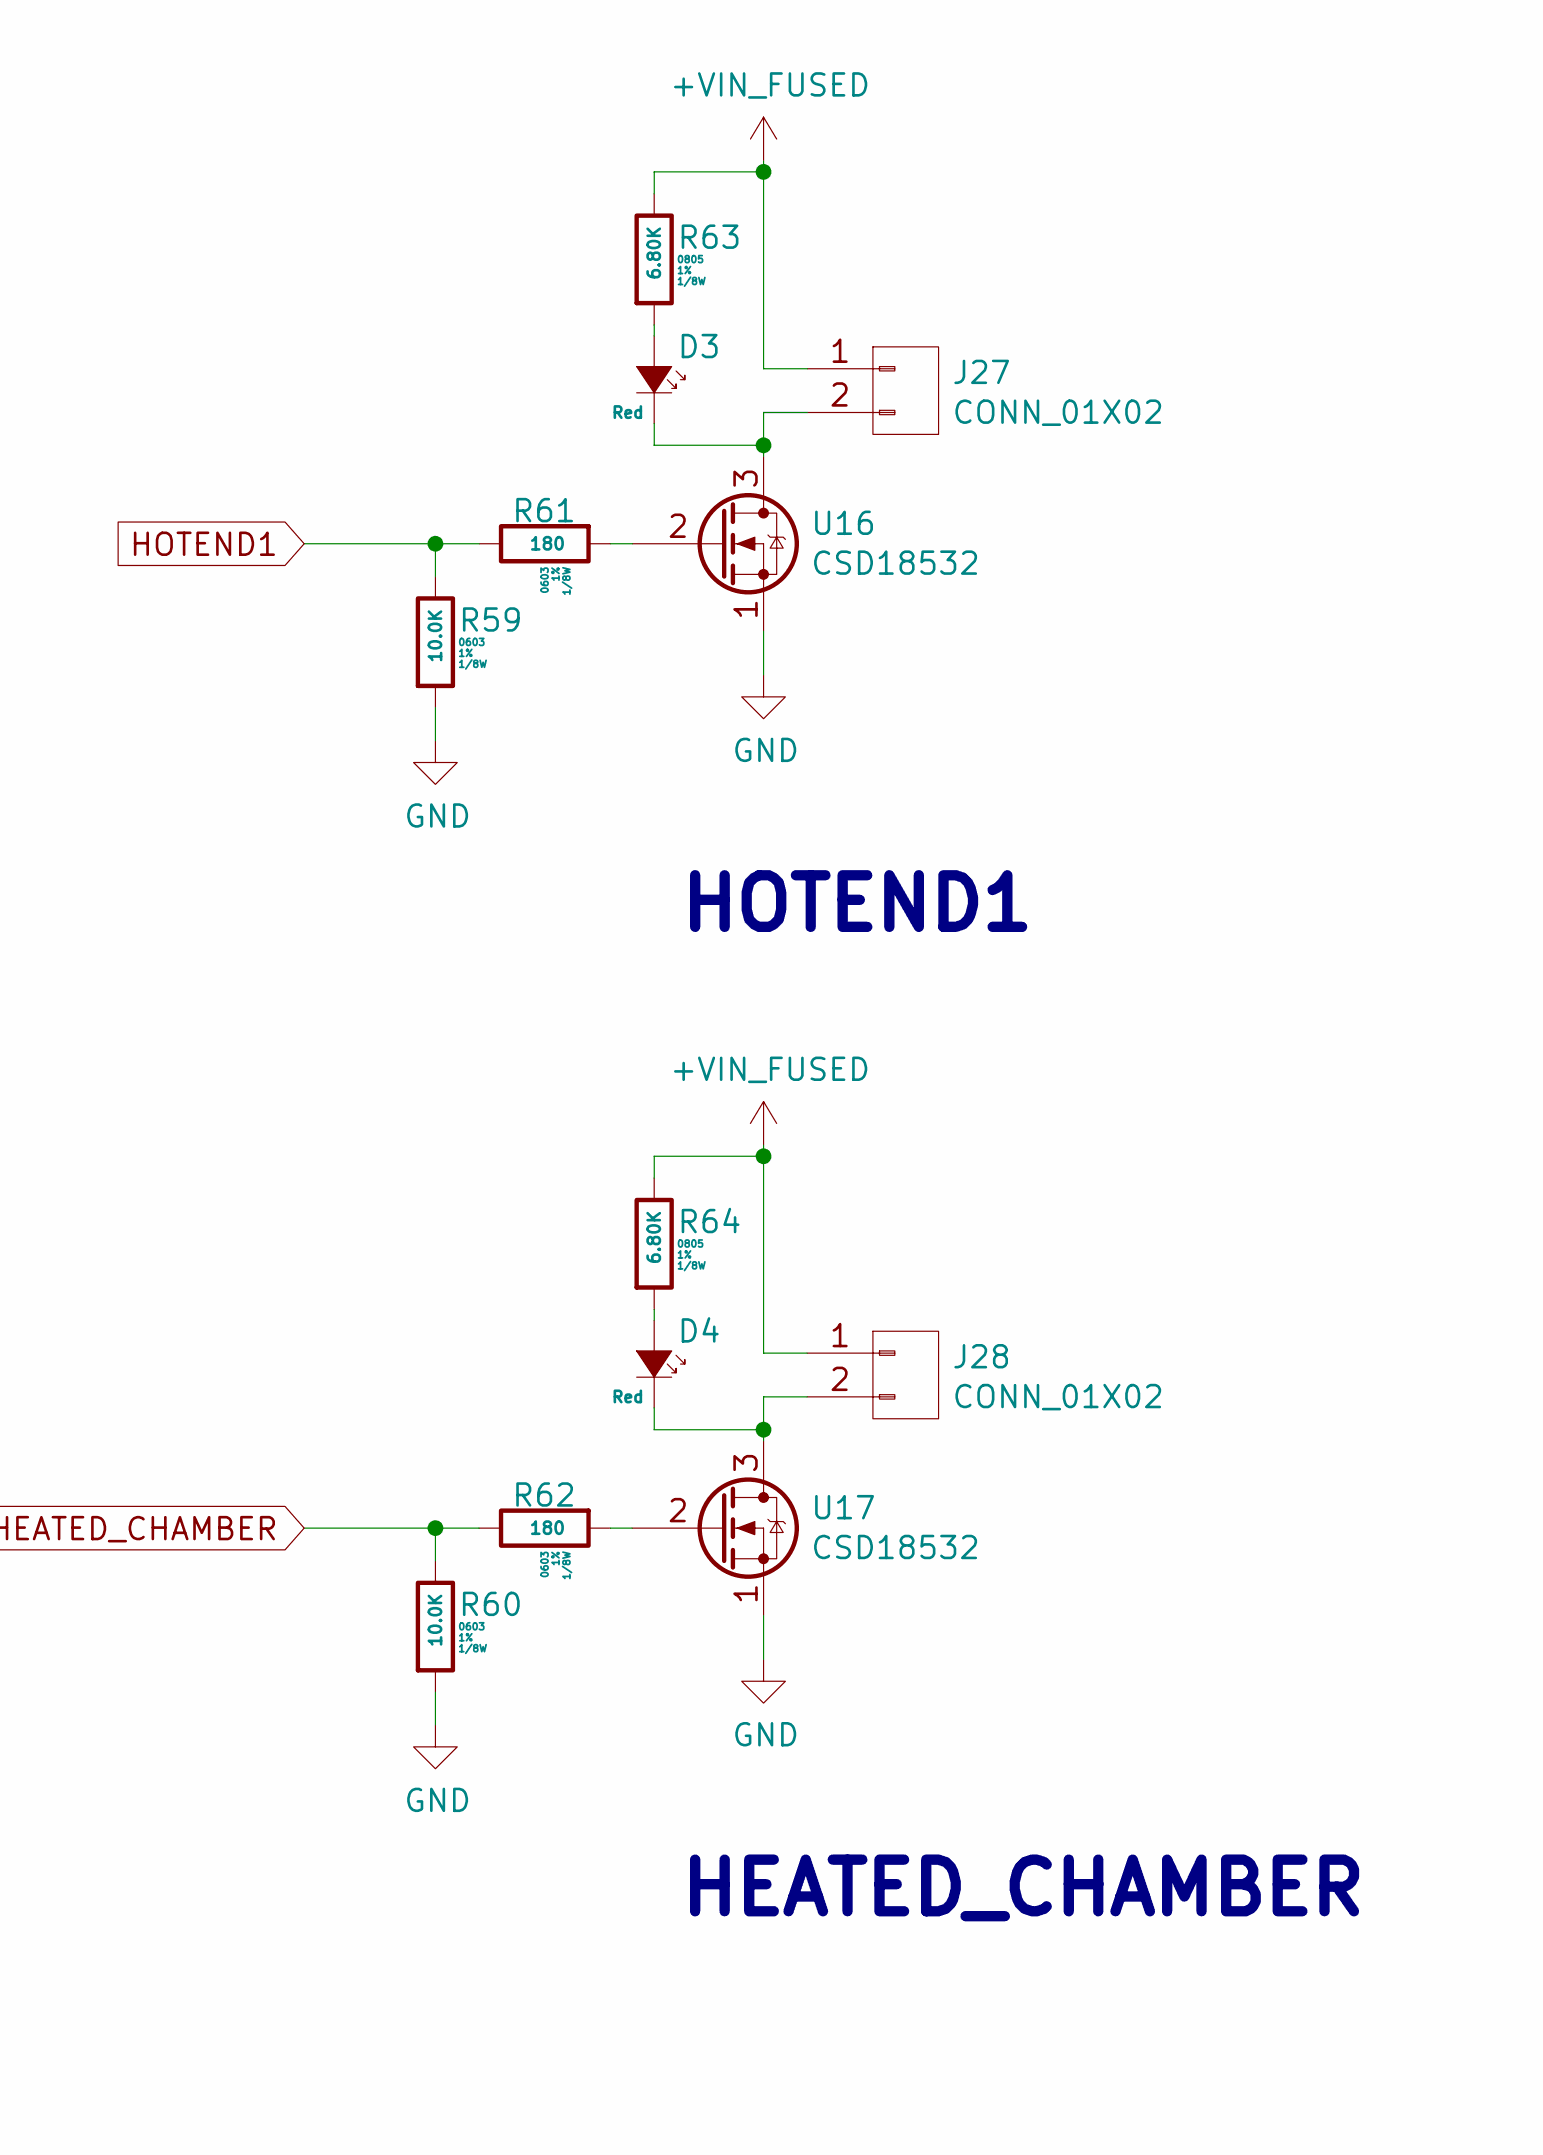
[picture p20: schematic Heaters.sch, Taco Raven, part in row 1, column 2]

Parts:
D1, D2, D3, D4: Red; LED_0805; MFG PN 150080SS75000; Digikey P/N 732-4985-1-ND
J26, J27, J28: CONN_01X02; TerminalBlock_TE_282834-2_1x02_P2.54mm_Horizontal; MFG PN 282834-2; Digikey P/N A98333-ND
R53, R54, R59, R60: 10.0K; R_0603; Tolerance 1%; MFG PN RNCP0603FTD10K0; Digikey P/N RNCP0603FTD10K0CT-ND
R55, R56, R61, R62: 180; R_0603; Tolerance 1%; MFG PN RNCP0603FTD180R; Digikey P/N RNCP0603FTD180RCT-ND
R57, R58, R63, R64: 6.80K; R_0805; Tolerance 1%; MFG PN RMCF0805FT6K80; Digikey P/N RMCF0805FT6K80CT-ND
U14, U15, U16, U17: CSD18532; VSONP-8-1EP_5x6_P1.27mm; MFG PN CSD18532Q5B; Digikey P/N 296-35628-6-ND

Connections:
+VIN_FUSED: J26.1, J27.1, J28.1, R58.1, R63.1, R64.1; also elsewhere on the board
BED: R53.1, R55.1; also elsewhere on the board
BED_SWITCH: D1.1 (K), U14.3; also elsewhere on the board
GND: R53.2, R54.2, R59.2, R60.2, U14.1, U15.1, U16.1, U17.1; also elsewhere on the board
HEATED_CHAMBER: R60.1, R62.1; also elsewhere on the board
HOTEND0: R54.1, R56.1; also elsewhere on the board
HOTEND1: R59.1, R61.1; also elsewhere on the board
unnamed: D1.2 (A), R57.2
unnamed: D2.1 (K), J26.2, U15.3
unnamed: D2.2 (A), R58.2
unnamed: D3.1 (K), J27.2, U16.3
unnamed: D3.2 (A), R63.2
unnamed: D4.1 (K), J28.2, U17.3
unnamed: D4.2 (A), R64.2
unnamed: R55.2, U14.2
unnamed: R56.2, U15.2
unnamed: R61.2, U16.2
unnamed: R62.2, U17.2
VBED_FUSED: R57.1; also elsewhere on the board

Notes on the sheet:
BED
HOTEND0
HOTEND1
HEATED_CHAMBER
Added MFG P/N to J26,27,28

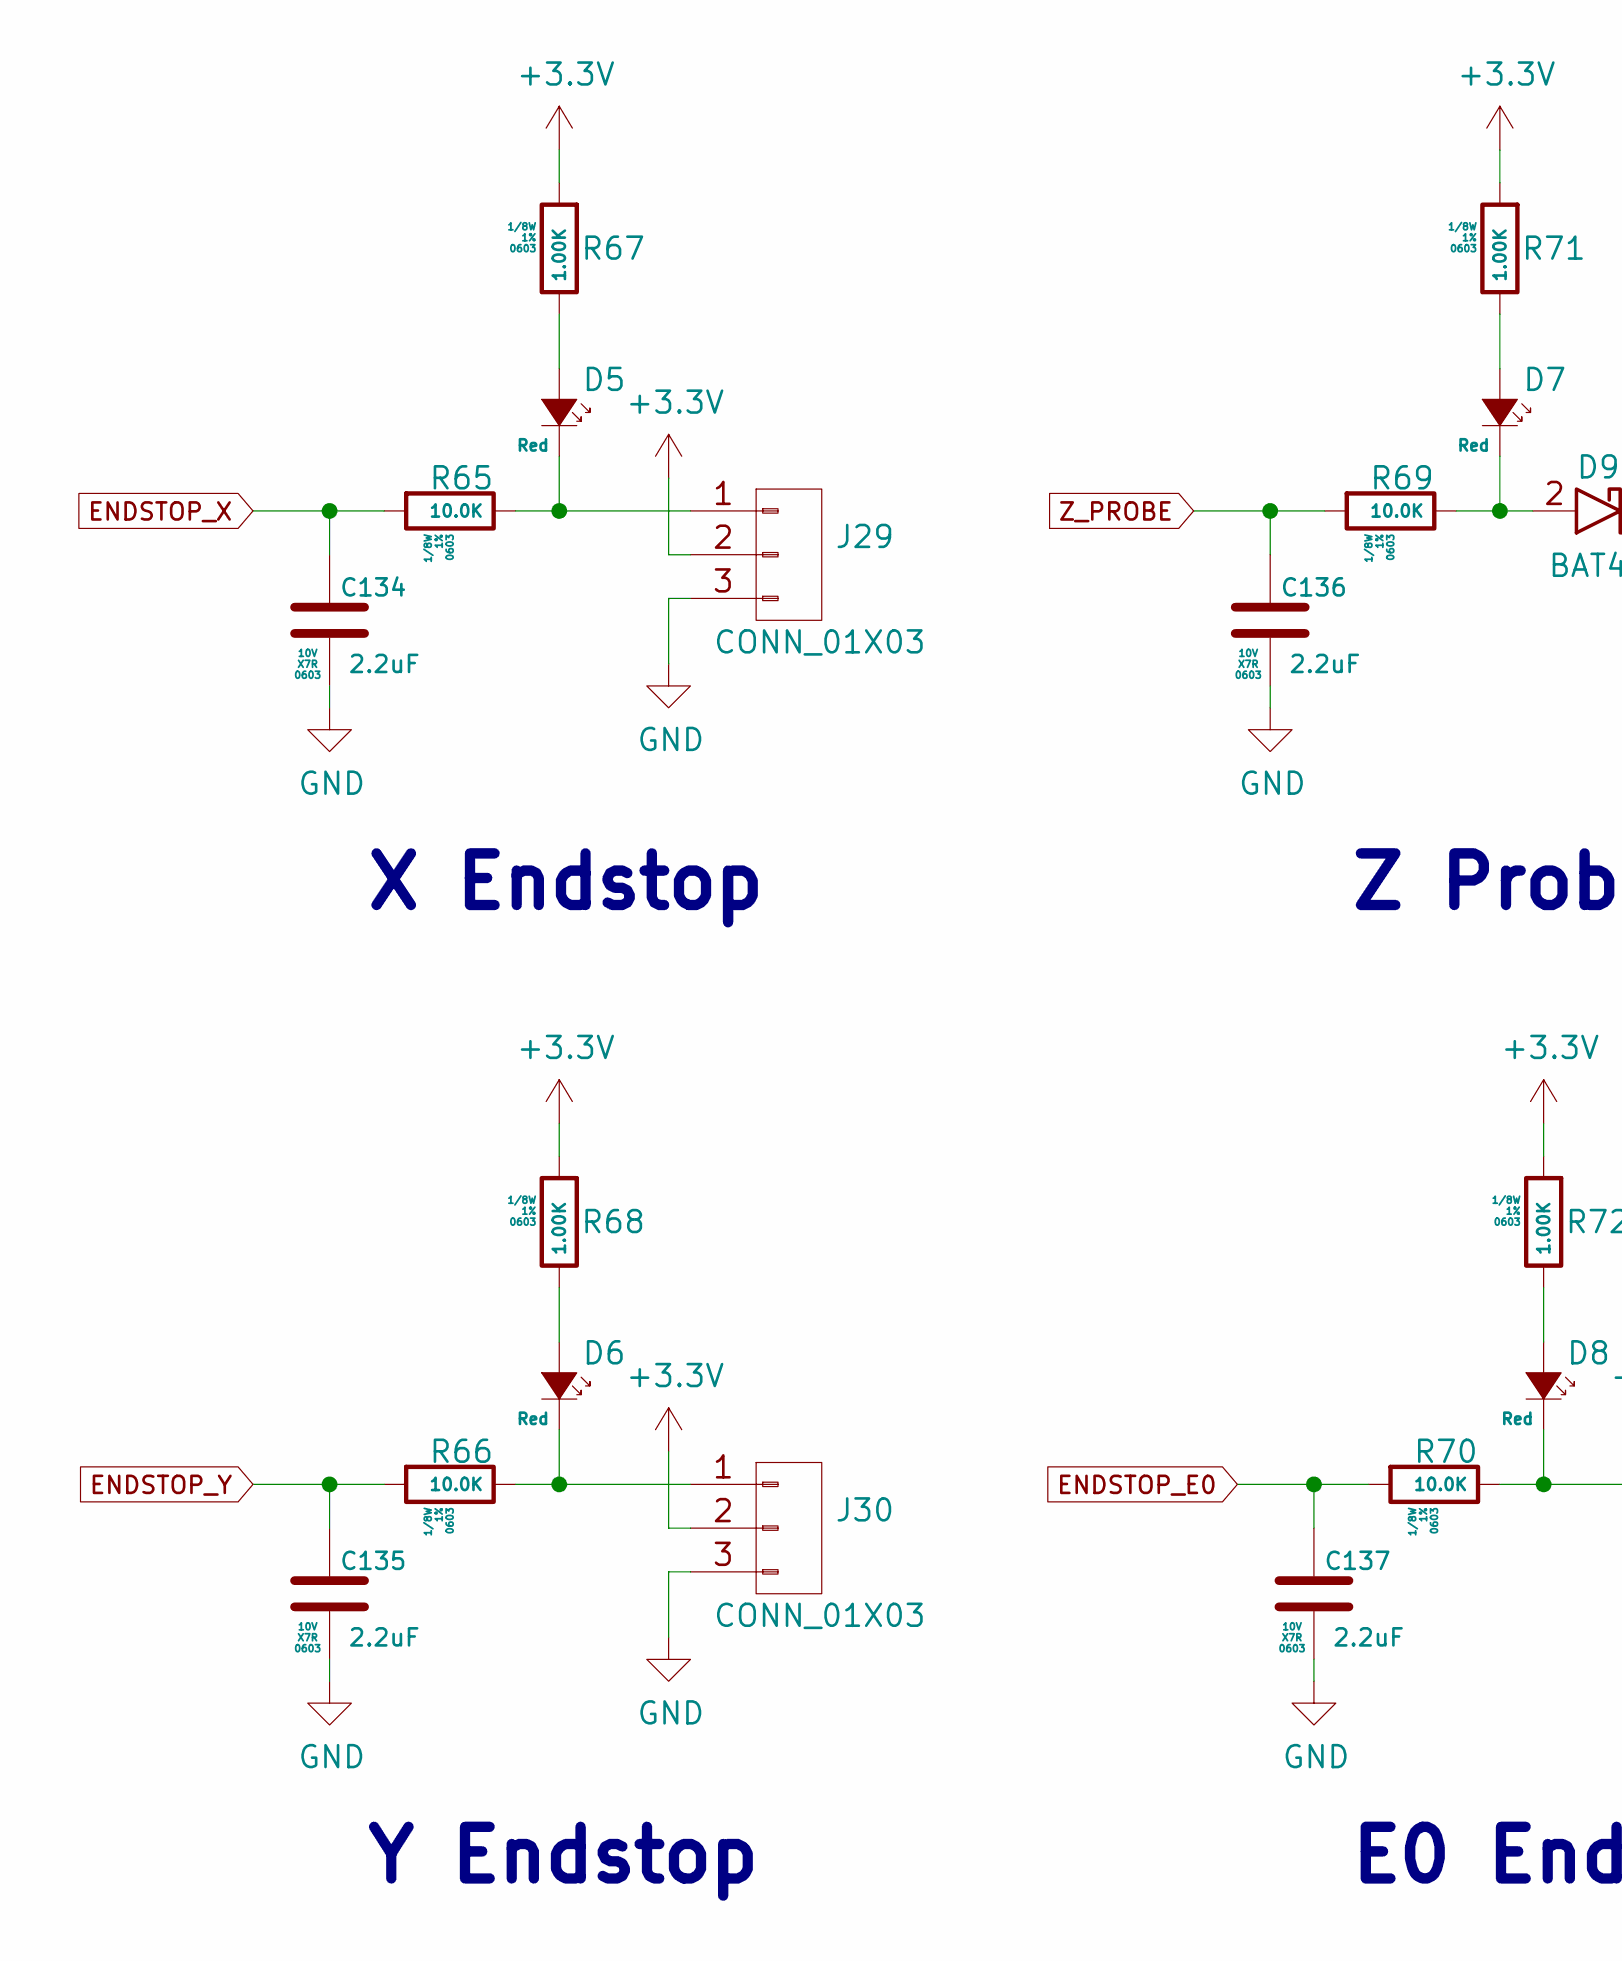
[picture p21: schematic Endstops.sch, Taco Raven, part in row 1, column 1]

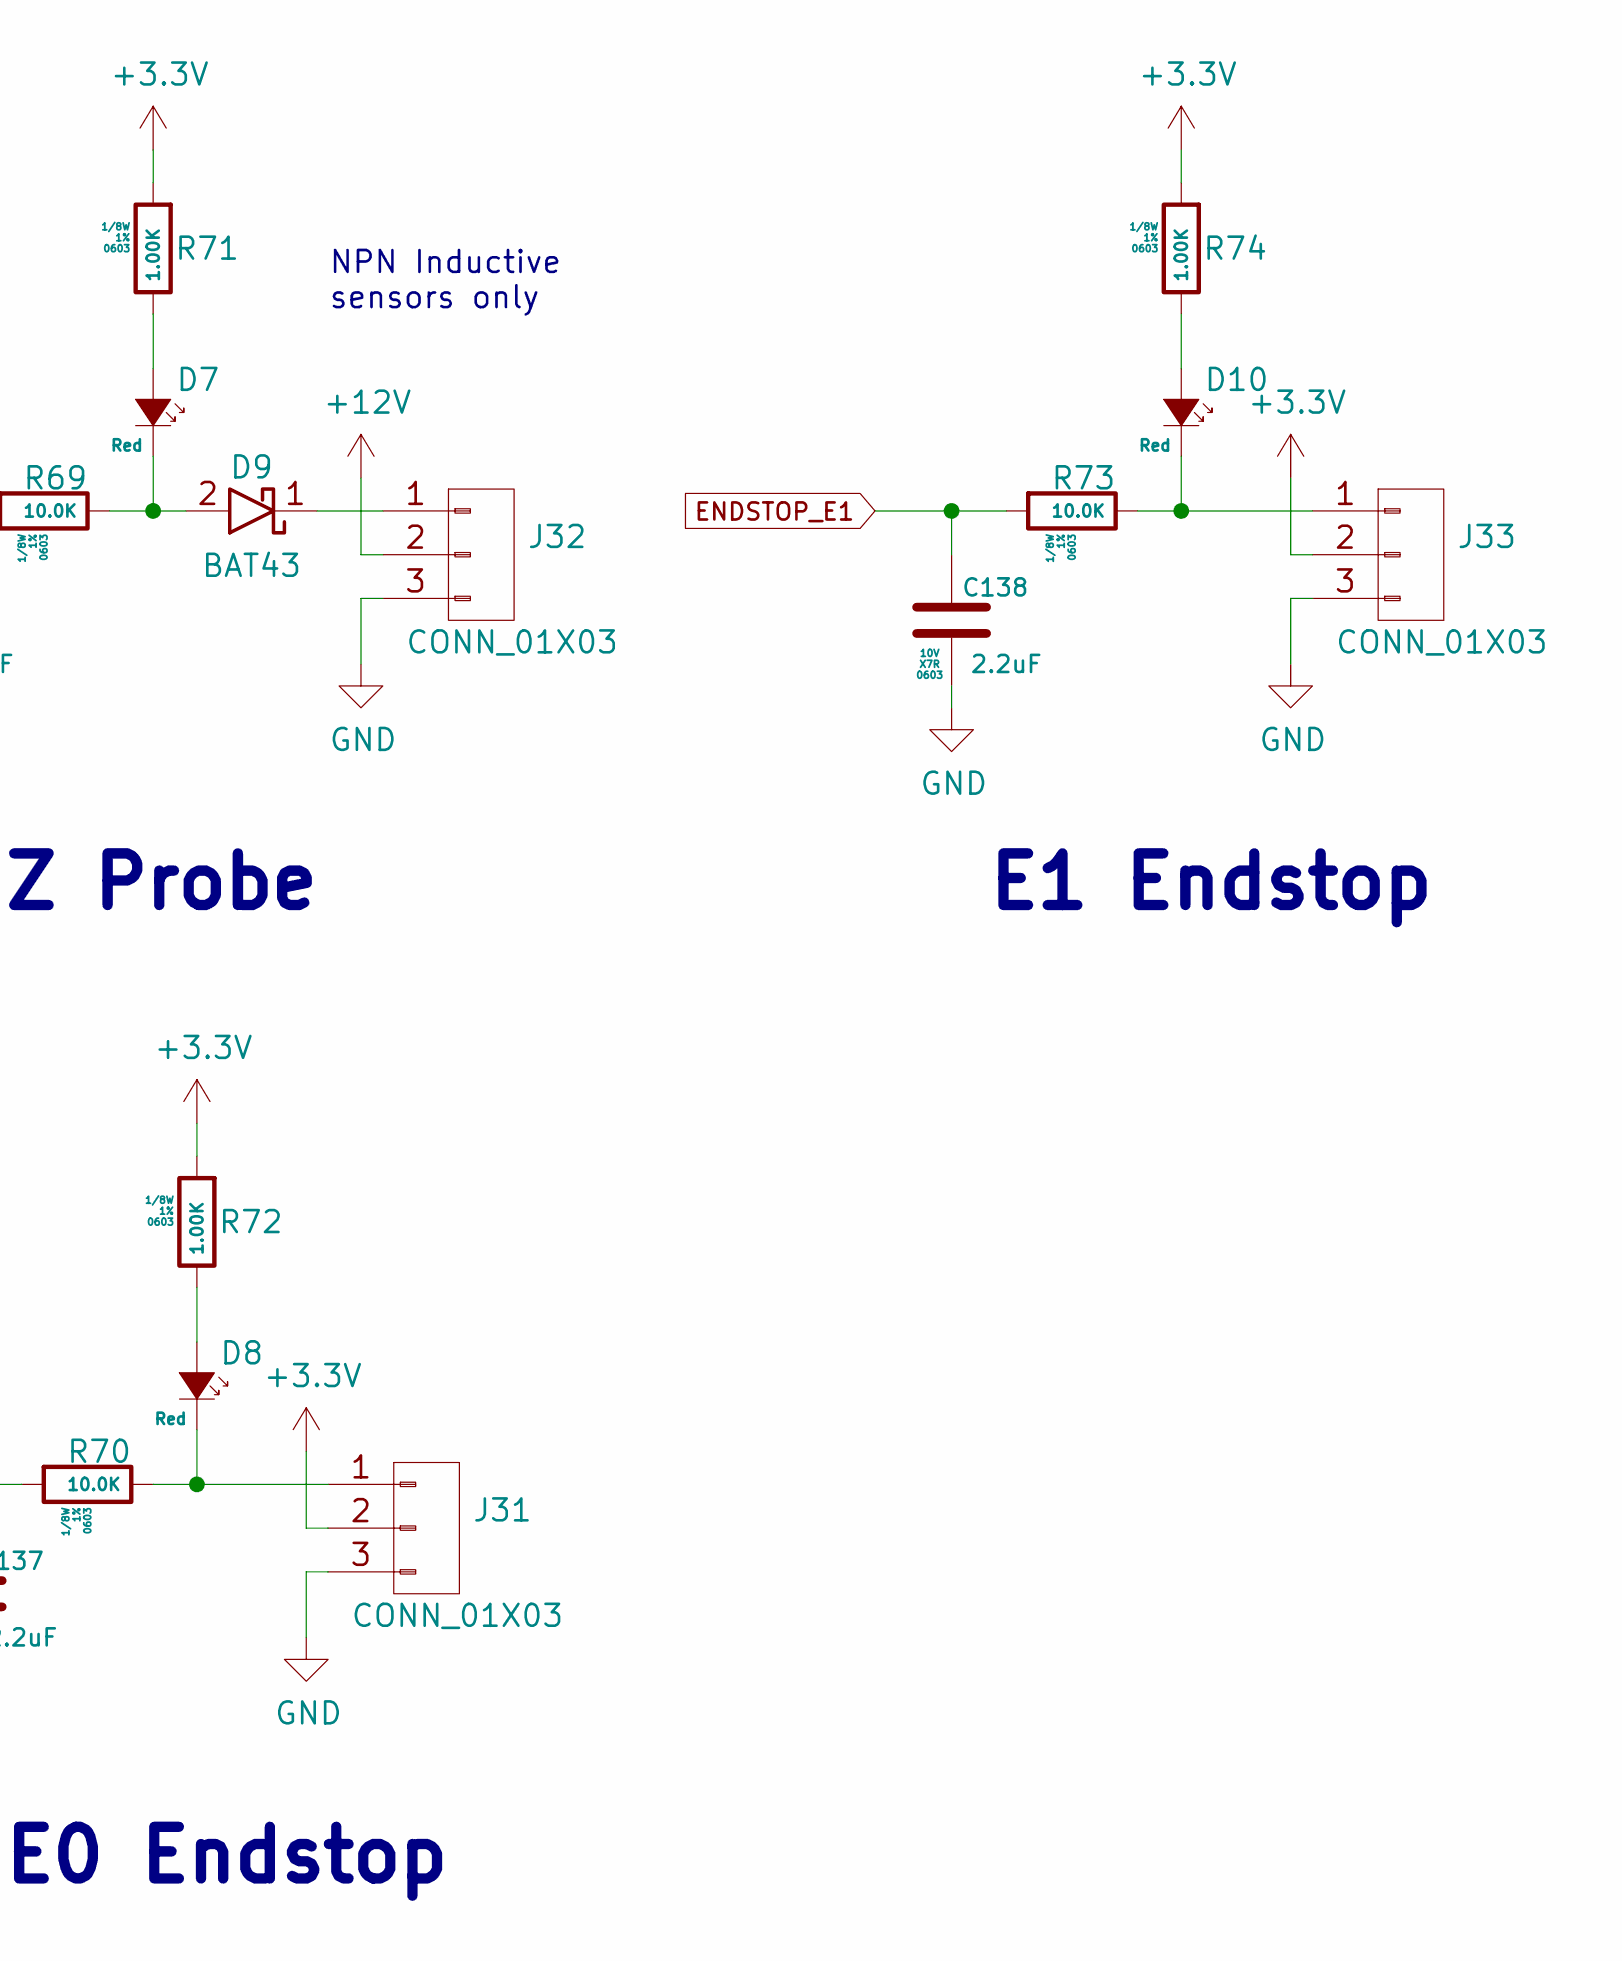
[picture p22: schematic Endstops.sch, Taco Raven, part in row 1, column 2]

Parts:
C134, C135, C136, C137, C138: 2.2uF; C_0603; Voltage 10V; MFG PN LMK107B7225KA-T; Digikey P/N 587-2983-1-ND
D5, D6, D7, D8, D10: Red; LED_0805; MFG PN 150080SS75000; Digikey P/N 732-4985-1-ND
D9: BAT43; D_SOD-323; MFG PN BAT43WS-7-F; Digikey P/N BAT43WS-FDICT-ND
J29, J30, J31, J32, J33: CONN_01X03; Molex_KK_1X3; MFG PN 0022232031; Digikey P/N WM4201-ND
R65, R66, R69, R70, R73: 10.0K; R_0603; Tolerance 1%; MFG PN RNCP0603FTD10K0; Digikey P/N RNCP0603FTD10K0CT-ND
R67, R68, R71, R72, R74: 1.00K; R_0603; Tolerance 1%; MFG PN RNCP0603FTD1K00; Digikey P/N RNCP0603FTD1K00CT-ND

Connections:
+3.3V: J29.2, J30.2, J31.2, J33.2, R67.2, R68.2, R71.2, R72.2, R74.2; also elsewhere on the board
+12V: J32.2; also elsewhere on the board
ENDSTOP_E0: C137.2, R70.2; also elsewhere on the board
ENDSTOP_E1: C138.2, R73.2; also elsewhere on the board
ENDSTOP_X: C134.2, R65.2; also elsewhere on the board
ENDSTOP_Y: C135.2, R66.2; also elsewhere on the board
GND: C134.1, C135.1, C136.1, C137.1, C138.1, J29.3, J30.3, J31.3, J32.3, J33.3; also elsewhere on the board
unnamed: D5.1 (K), J29.1, R65.1
unnamed: D5.2 (A), R67.1
unnamed: D6.1 (K), J30.1, R66.1
unnamed: D6.2 (A), R68.1
unnamed: D7.1 (K), D9.2, R69.1
unnamed: D7.2 (A), R71.1
unnamed: D8.1 (K), J31.1, R70.1
unnamed: D8.2 (A), R72.1
unnamed: D9.1, J32.1
unnamed: D10.1 (K), J33.1, R73.1
unnamed: D10.2 (A), R74.1
Z_PROBE: C136.2, R69.2; also elsewhere on the board

Notes on the sheet:
X Endstop
Z Probe
E1 Endstop
Y Endstop
E0 Endstop
NPN Inductive sensors only
