twmiv/Voron-Hardware/Taco_Raven/KiCad/Voron_Klipper_Board.kicad_pcb

## KiCad design Taco_Raven/KiCad/Voron_Klipper_Board.kicad_pcb (continued)

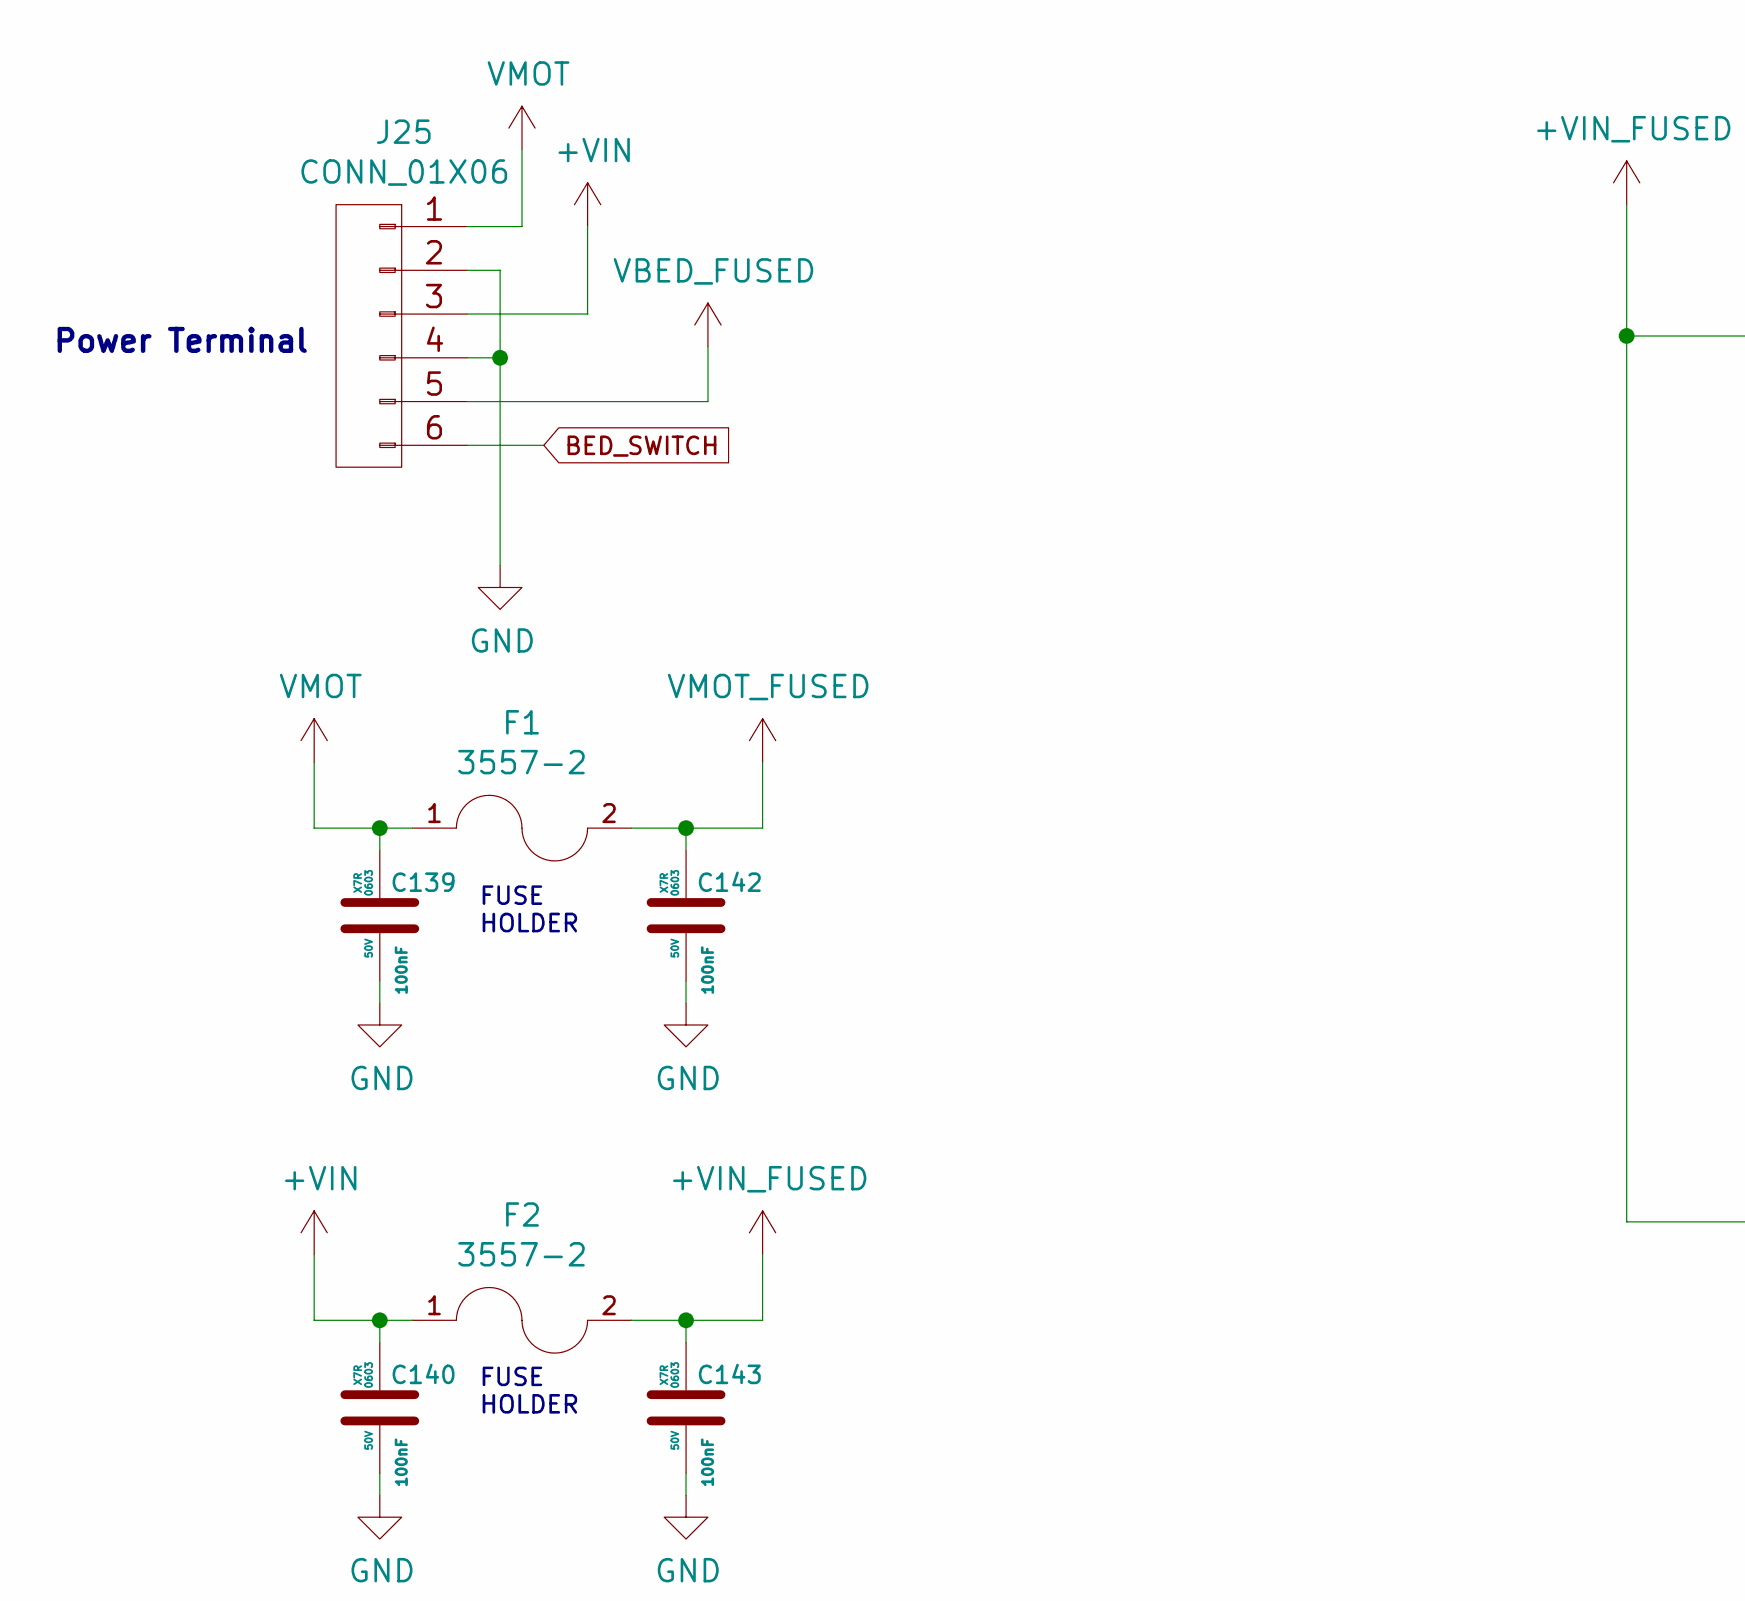
[picture p23: schematic Power.sch, Taco Raven, part in row 1, column 1]

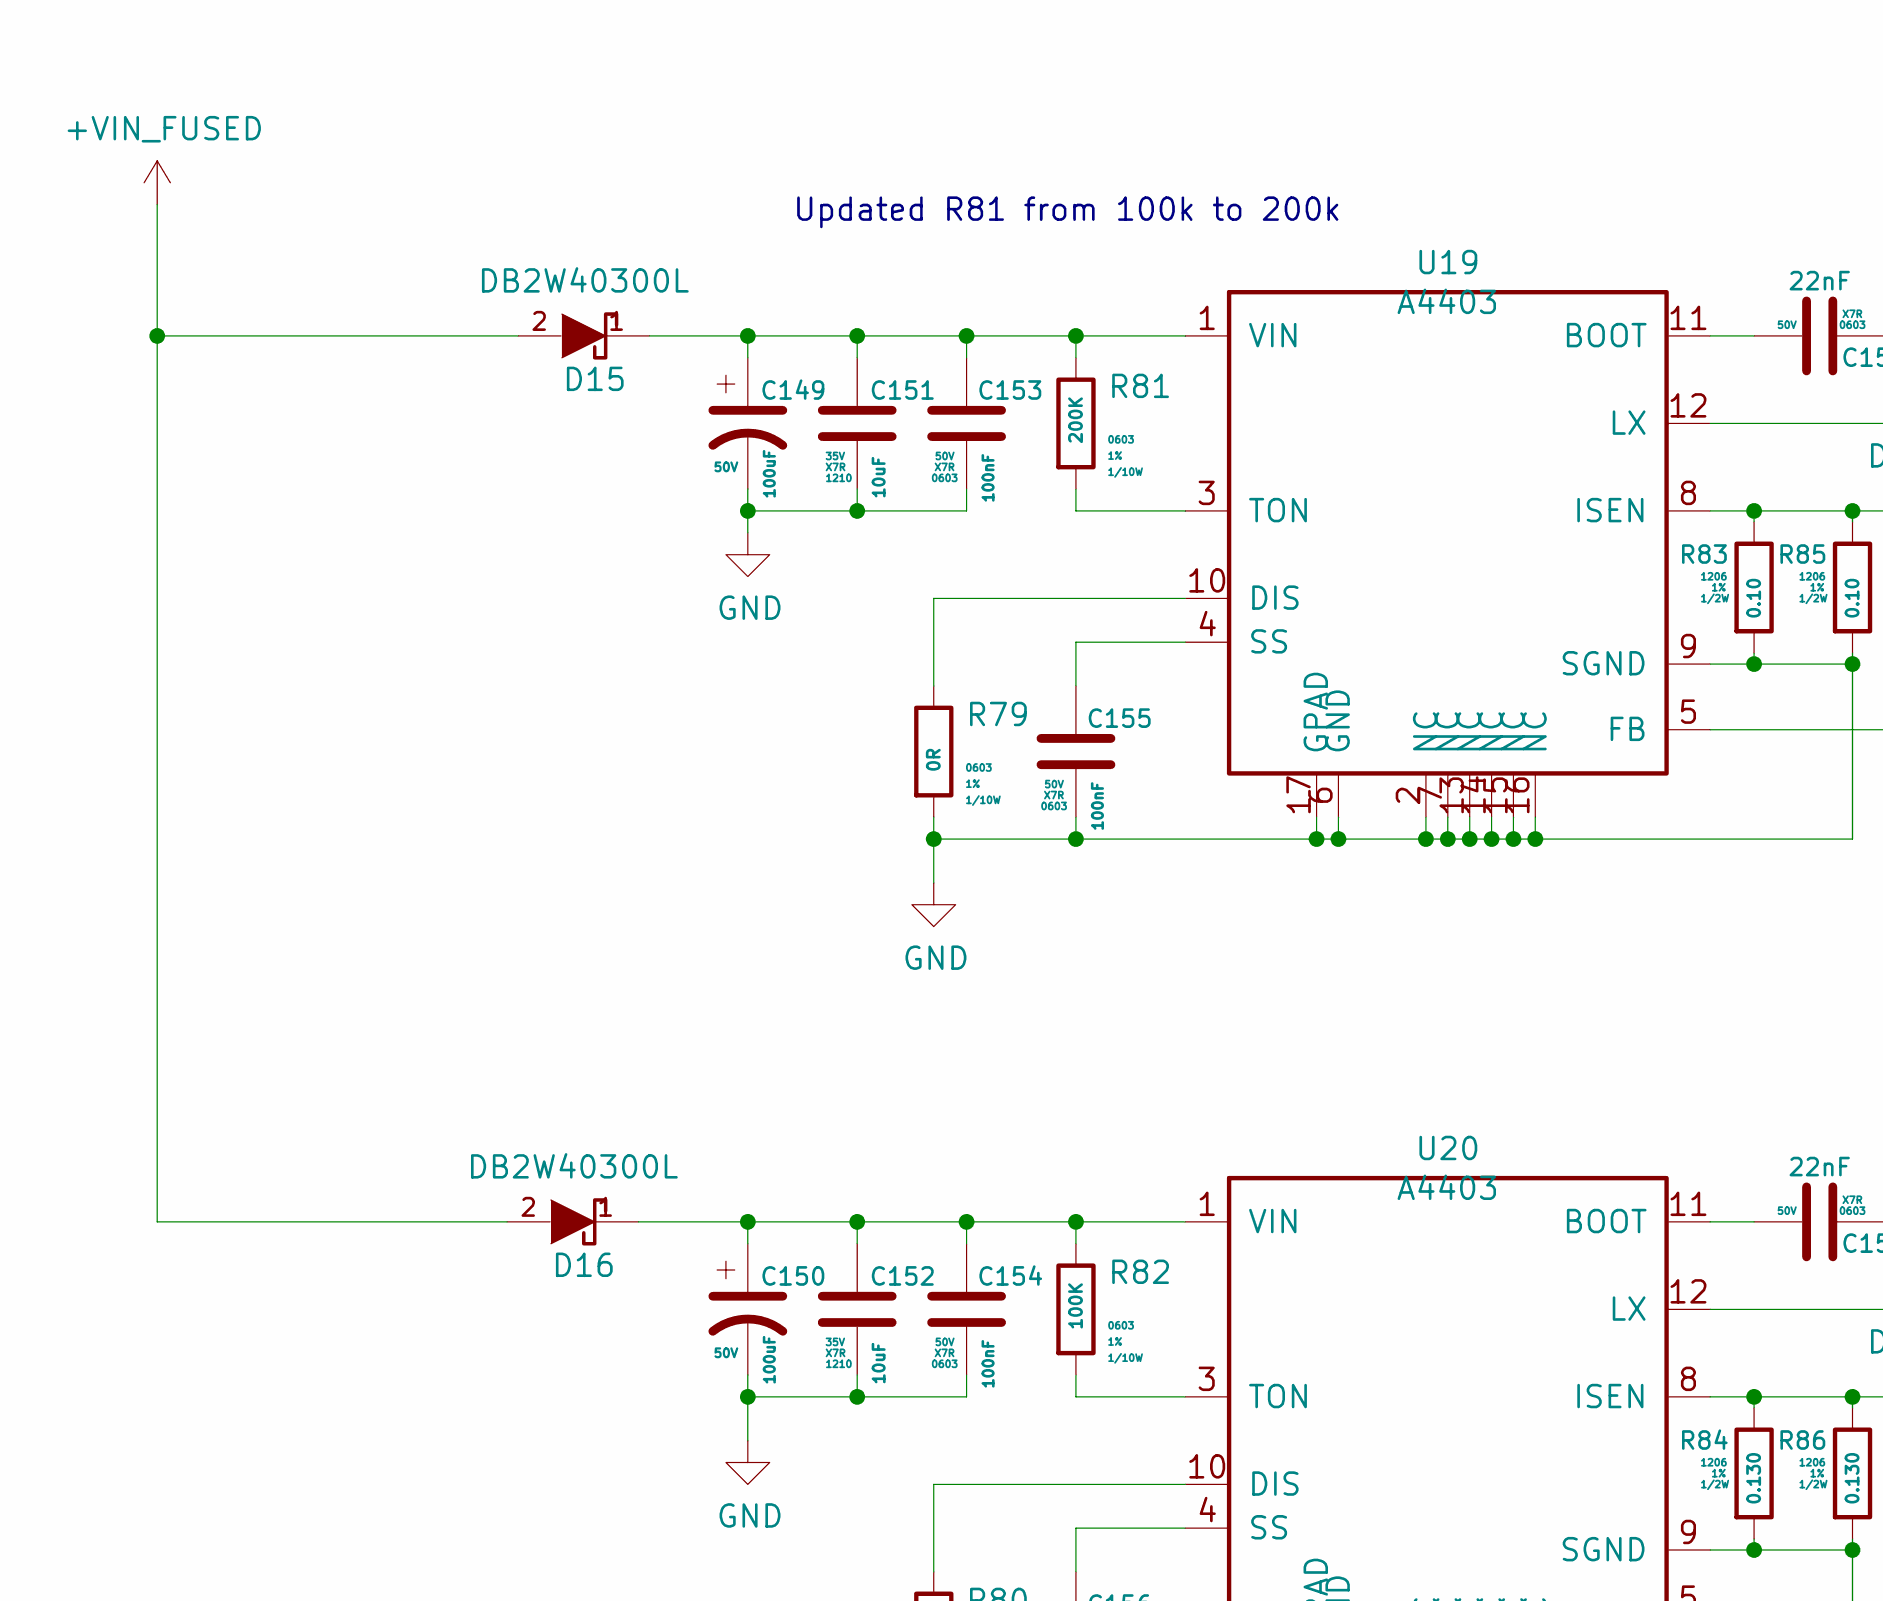
[picture p24: schematic Power.sch, Taco Raven, part in row 1, column 2]

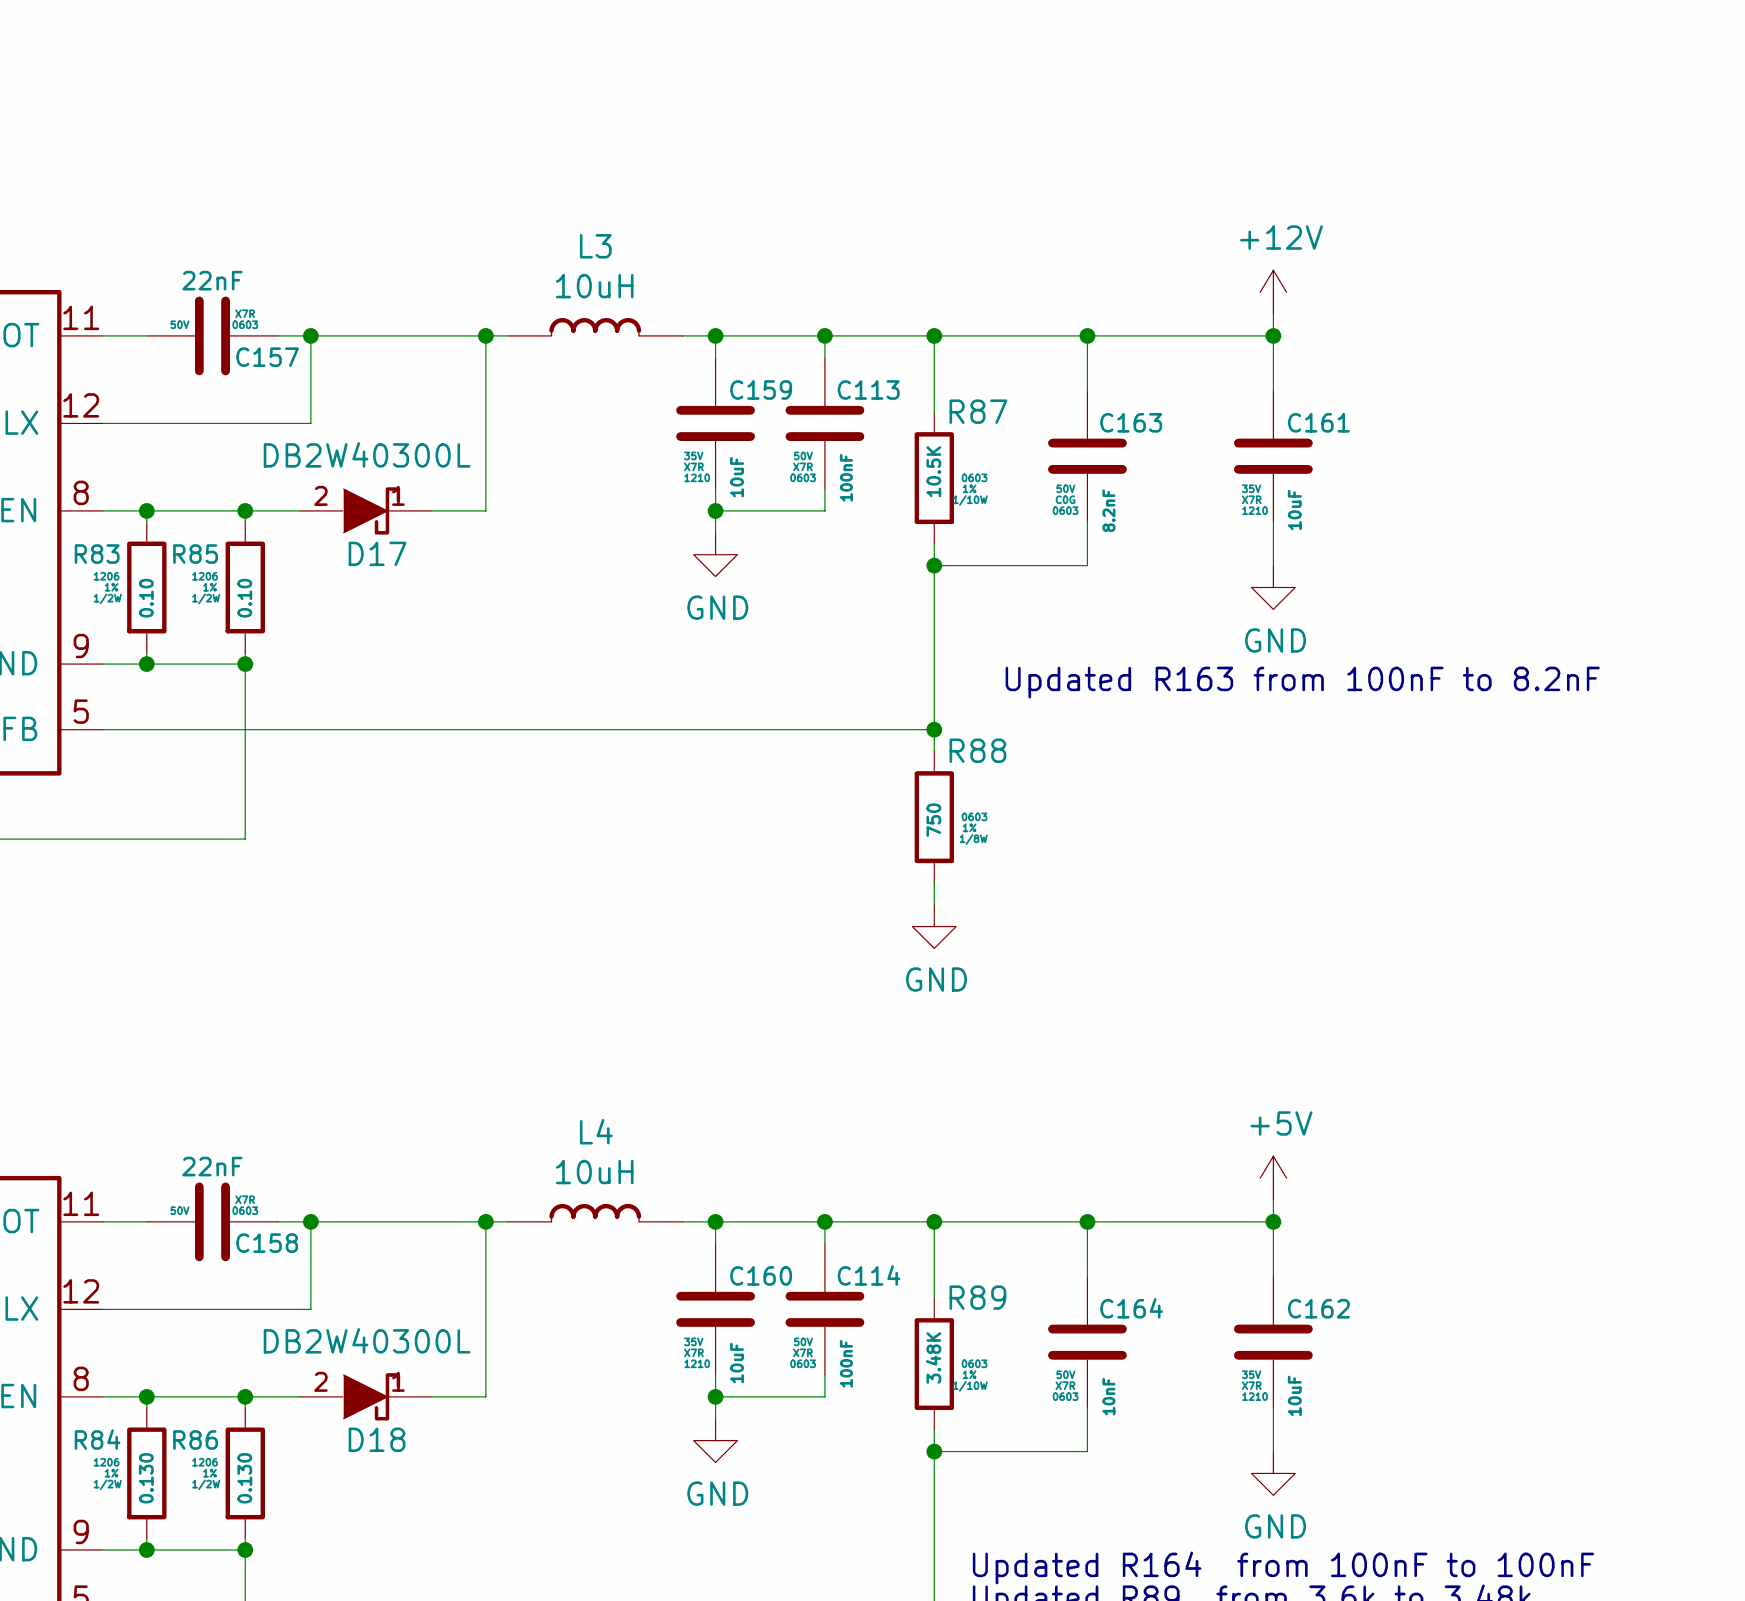
[picture p25: schematic Power.sch, Taco Raven, part in row 1, column 3]

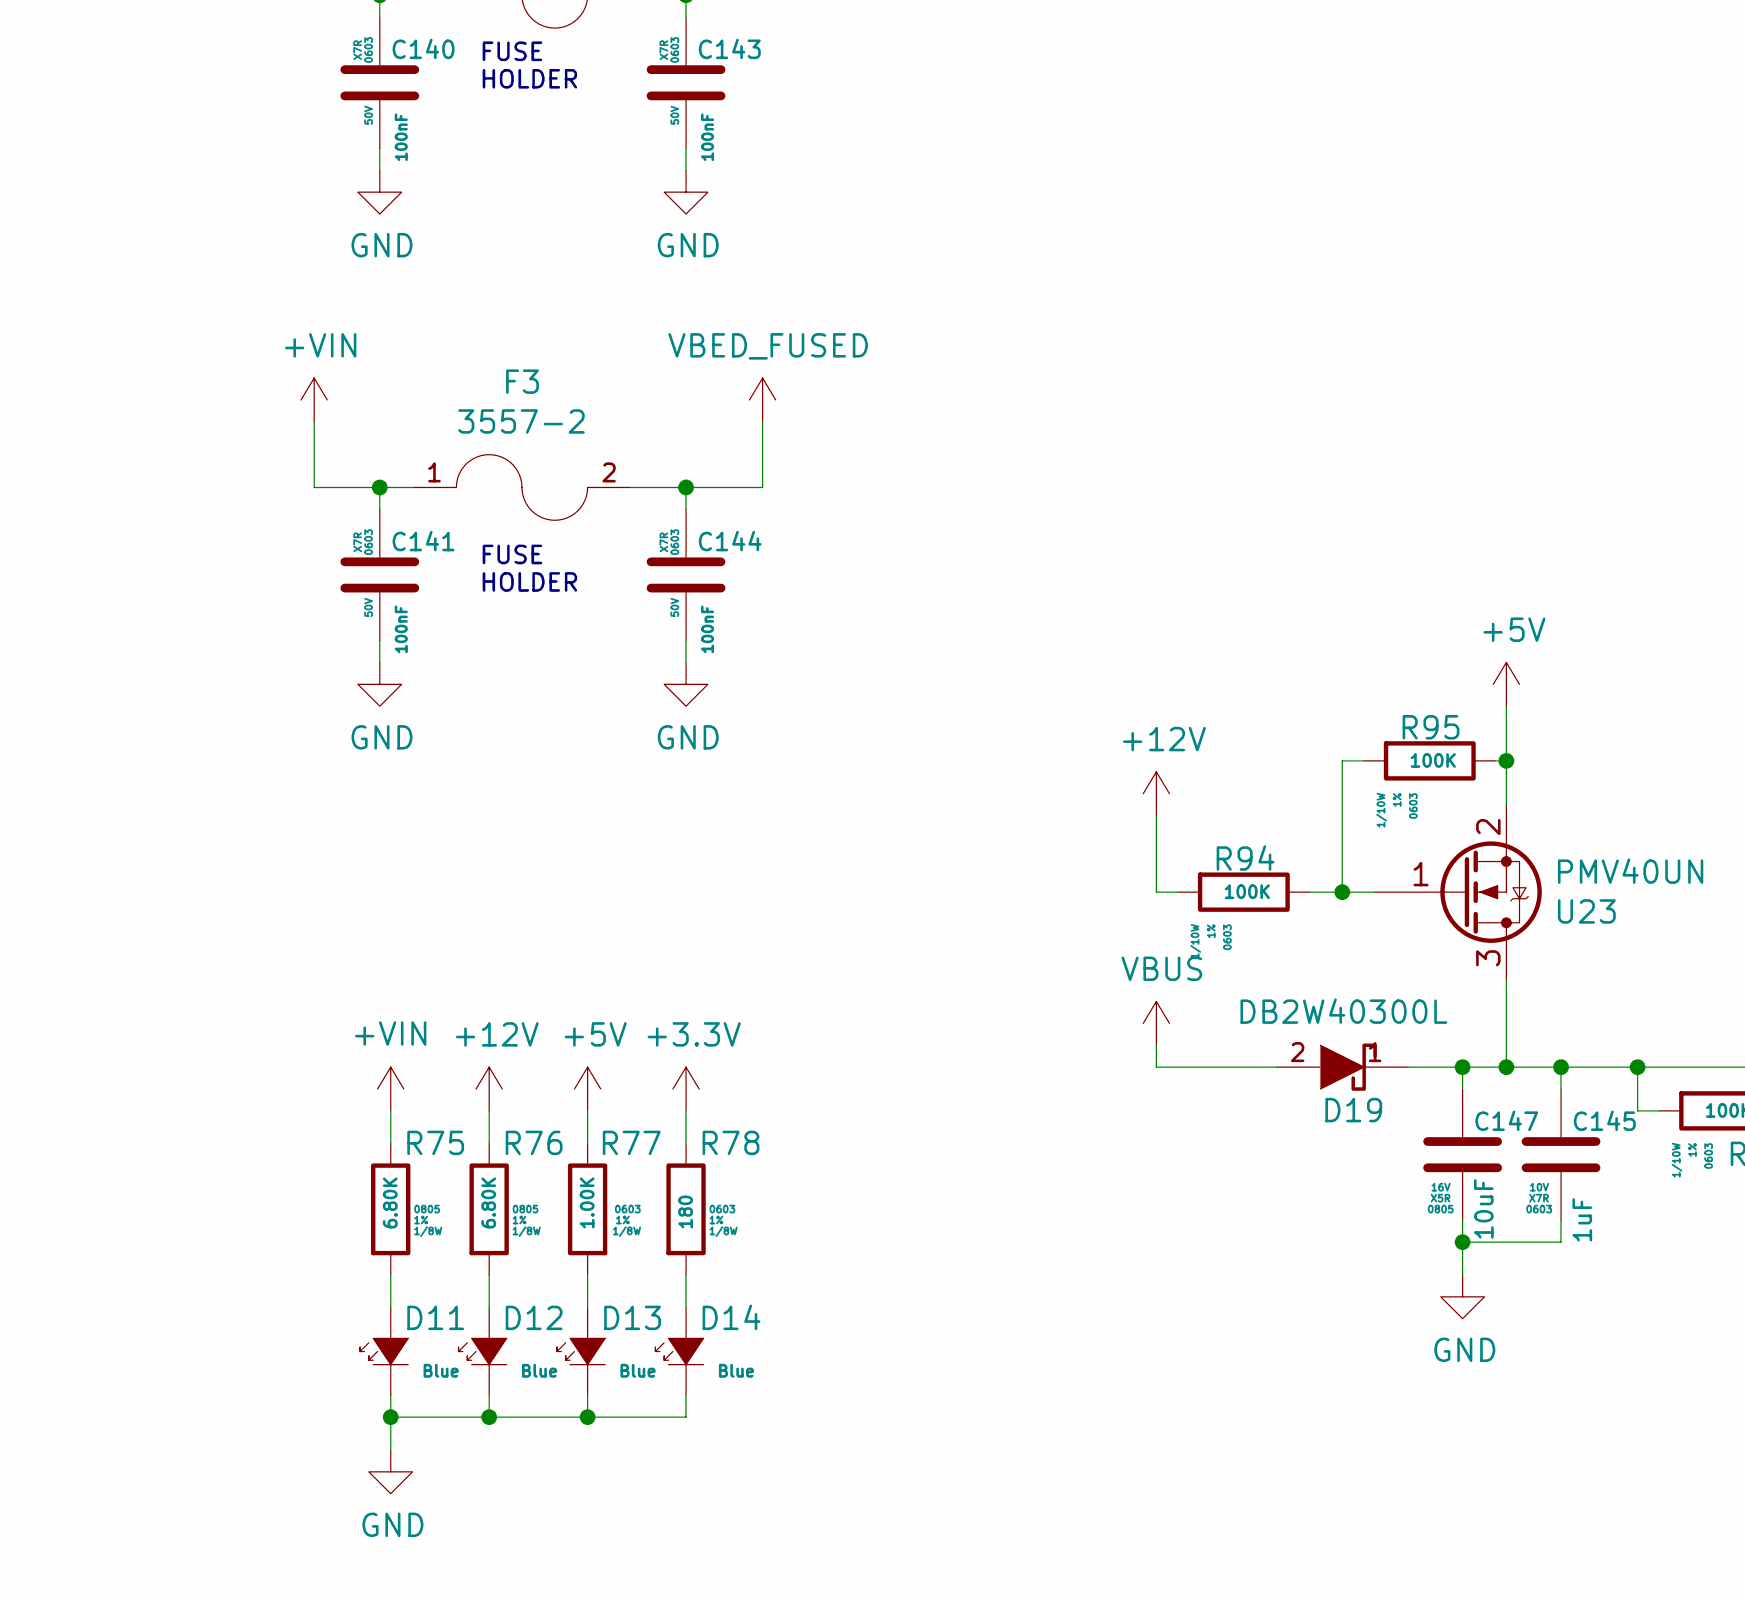
[picture p26: schematic Power.sch, Taco Raven, part in row 2, column 1]

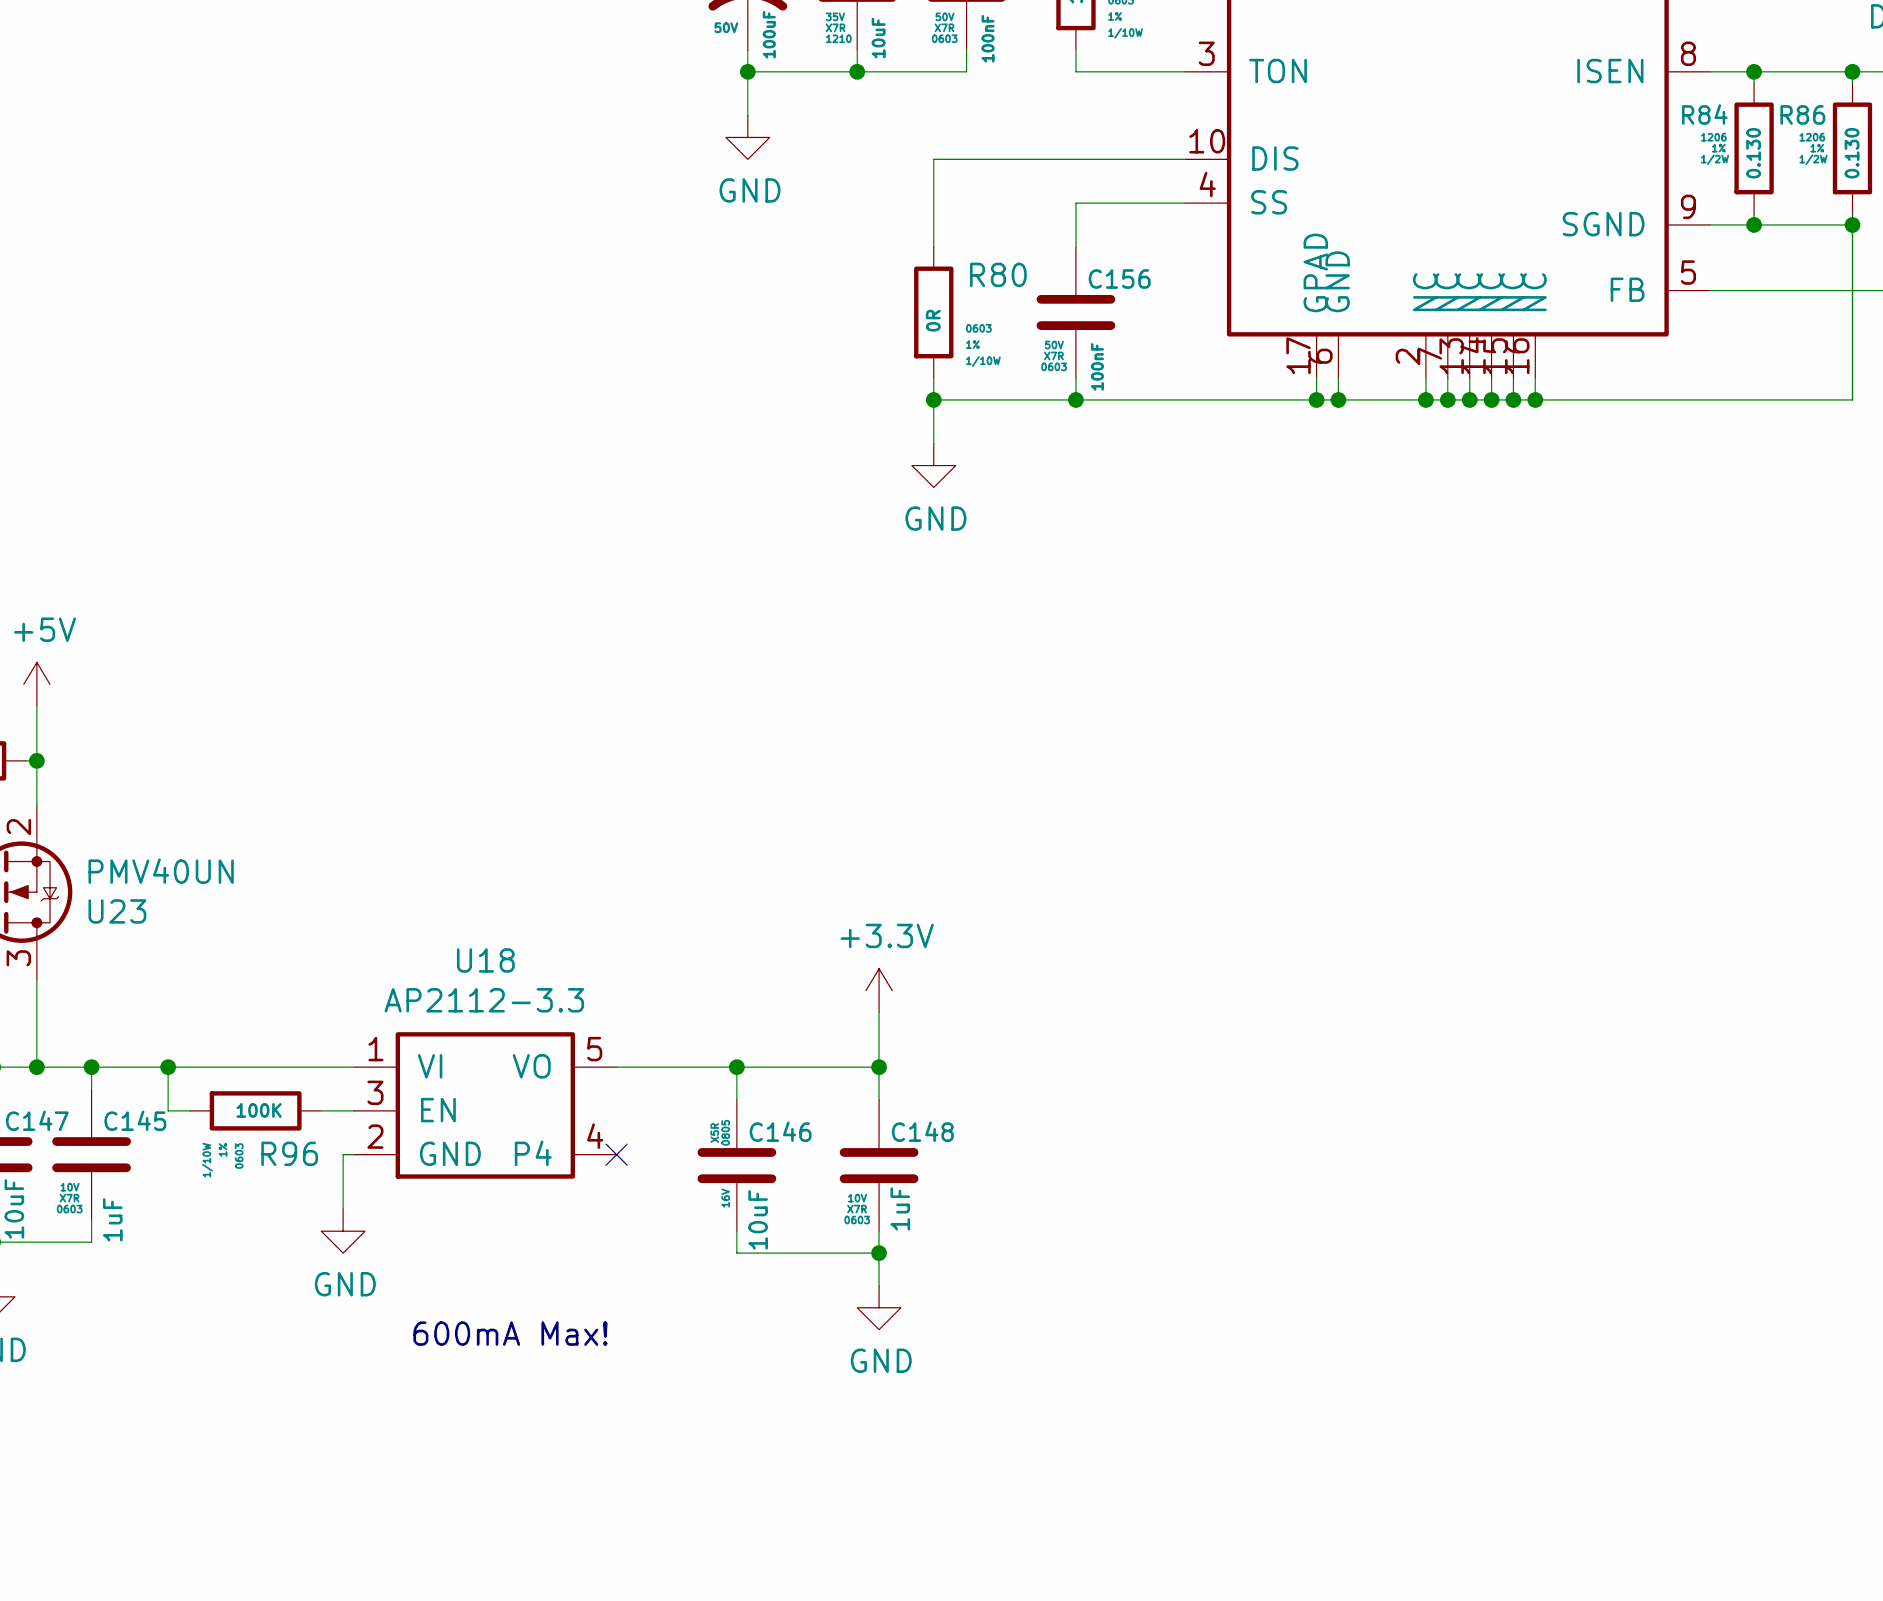
[picture p27: schematic Power.sch, Taco Raven, part in row 2, column 2]

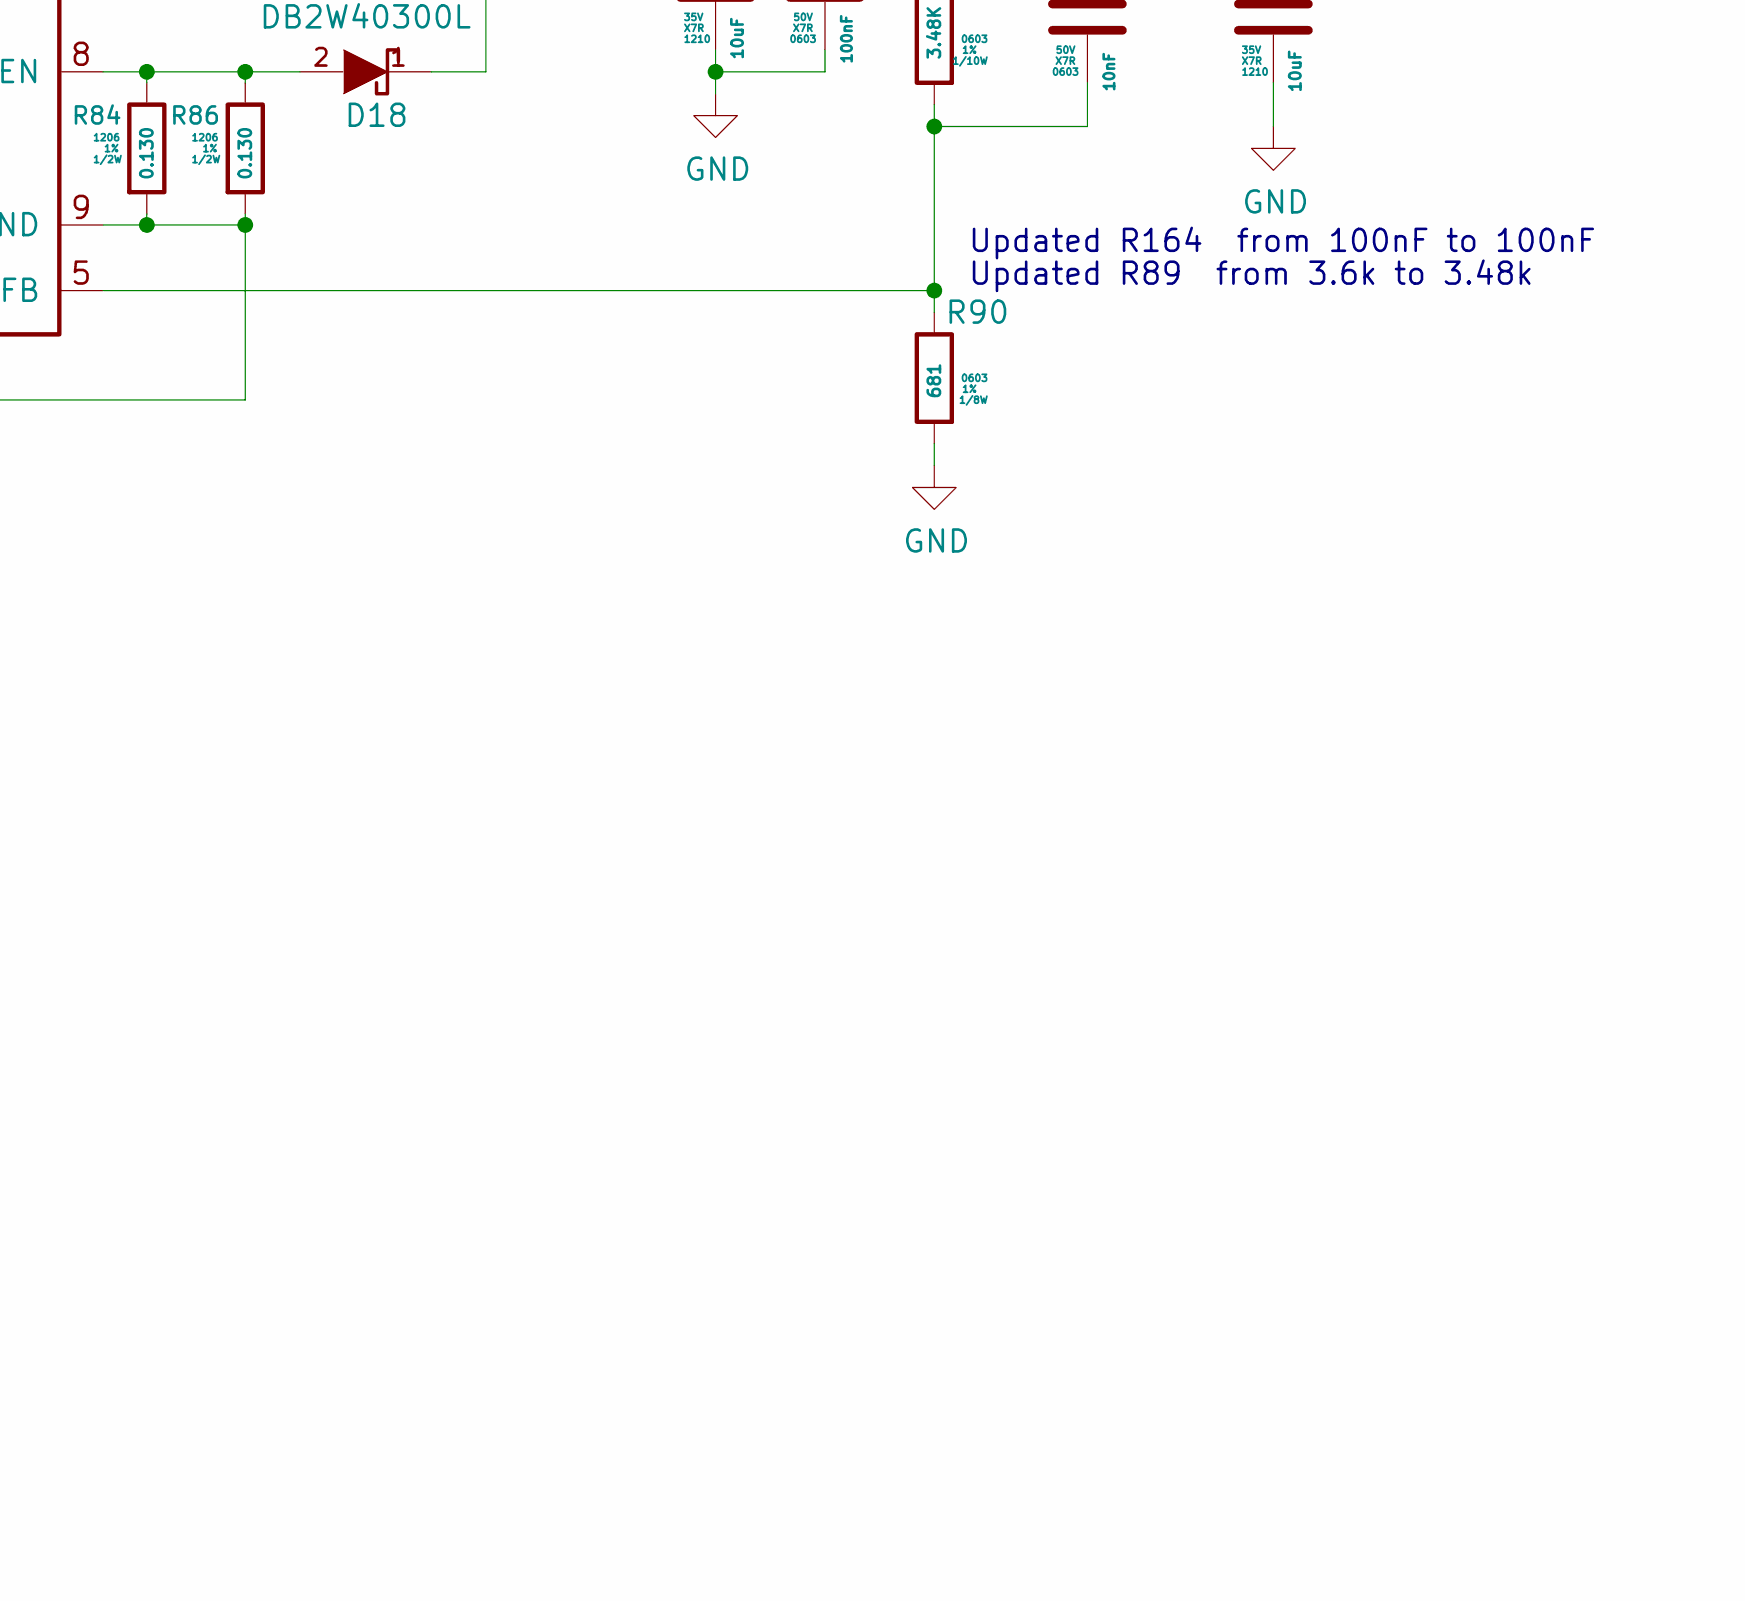
[picture p28: schematic Power.sch, Taco Raven, part in row 2, column 3]

Parts:
C113, C114, C139, C140, C141, C142, C143, C144, C153, C154, C155, C156: 100nF; C_0603; Voltage 50V; MFG PN CC0603KRX7R9BB104; Digikey P/N 311-1344-1-ND
C145, C148: 1uF; C_0603; Voltage 10V; MFG PN CL10B105KP8NNNC; Digikey P/N 1276-1946-1-ND
C146, C147: 10uF; C_0805; Voltage 16V; MFG PN CL21A106KOQNNWE; Digikey P/N 1276-2894-1-ND
C149, C150: 100uF; CP_Elec_6.3x7.7; Voltage 50V; MFG PN EMZR500ARA101MF80G; Digikey P/N 565-5153-1-ND
C151, C152, C159, C160, C161, C162: 10uF; C_1210; Voltage 35V; MFG PN C1210C106M6PACTU; Digikey P/N 399-5509-1-ND
C157, C158: 22nF; C_0603; Voltage 50V; MFG PN CL10B223KB8WPNC; Digikey P/N 311-3601-1-ND
C163: 8.2nF; C_0603; Voltage 50V; MFG PN C1608C0G1H822K080AA; Digikey P/N 445-13992-6-ND
C164: 10nF; C_0603; Voltage 50V; MFG PN 06035C103KAT2A; Digikey P/N 478-1227-1-ND
D11, D12, D13, D14: Blue; LED_0805; MFG PN 150080BS75000; Digikey P/N 732-4982-1-ND
D15, D16, D17, D18, D19: DB2W40300L; D_SOD-123F; MFG PN DB2W40300L; Digikey P/N DB2W40300LCT-ND
F1, F2, F3: 3557-2; Fuseholder_Blade_Mini_Keystone_3568; MFG PN 3557-2; Digikey P/N 36-3557-2-ND
J25: CONN_01X06; 8PCV-06-006; MFG PN 8PCV-06-006; Digikey P/N A98464-ND
L3, L4: 10uH; L_Vishay_IHLP-2525; MFG PN IHLP2525CZER100M11; Digikey P/N 541-2581-1-ND
R75, R76: 6.80K; R_0805; Tolerance 1%; MFG PN RMCF0805FT6K80; Digikey P/N RMCF0805FT6K80CT-ND
R77: 1.00K; R_0603; Tolerance 1%; MFG PN RNCP0603FTD1K00; Digikey P/N RNCP0603FTD1K00CT-ND
R78: 180; R_0603; Tolerance 1%; MFG PN RNCP0603FTD180R; Digikey P/N RNCP0603FTD180RCT-ND
R79, R80: 0R; R_0603; Tolerance 1%; MFG PN RC0603JR-070RL; Digikey P/N 311-0.0GRCT-ND
R81: 200K; R_0603; Tolerance 1%; MFG PN ERJ-3EKF2003V; Digikey P/N P200KHCT-ND
R82, R94, R95, R96: 100K; R_0603; Tolerance 1%; MFG PN ERJ-3EKF1003V; Digikey P/N P100KHCT-ND
R83, R85: 0.10; R_1206; Tolerance 1%; MFG PN CSR1206FTR100; Digikey P/N CSR1206FTR100CT-ND
R84, R86: 0.130; R_1206; Tolerance 1%; MFG PN CSR1206FTR130; Digikey P/N CSR1206FTR130CT-ND
R87: 10.5K; R_0603; Tolerance 1%; MFG PN ERJ-3EKF1052V; Digikey P/N P10.5KHCT-ND
R88: 750; R_0603; Tolerance 1%; MFG PN RNCP0603FTD750R; Digikey P/N RNCP0603FTD750RCT-ND
R89: 3.48K; R_0603; Tolerance 1%; MFG PN ERA-3AEB3481V; Digikey P/N P3.48KDBTR-ND
R90: 681; R_0603; Tolerance 1%; MFG PN RNCP0603FTD681R; Digikey P/N RNCP0603FTD681RCT-ND
U18: AP2112-3.3; SOT-23-5; MFG PN AP2112K-3.3TRG1; Digikey P/N AP2112K-3.3TRG1DICT-ND
U19, U20: A4403; WQFN-16-1EP_4x4mm_P0.65mm_EP2.1x2.1mm_ThermalVias; MFG PN A4403GEUTR-T; Digikey P/N 620-1273-1-ND
U23: PMV40UN; SOT-23; MFG PN PMV40UN2R; Digikey P/N 1727-1900-1-ND

Connections:
+3.3V: C146.2, C148.2, R78.1, U18.5 (VO); also elsewhere on the board
+5V: C114.2, C160.1, C162.1, C164.2, L4.2, R77.1, R89.1, R95.1, U23.2; also elsewhere on the board
+12V: C113.2, C159.1, C161.1, C163.2, L3.2, R76.1, R87.1, R94.2; also elsewhere on the board
+VIN: C140.2, C141.2, F2.1, F3.1, J25.3, R75.1
+VIN_FUSED: C143.2, D15.2, D16.2, F2.2; also elsewhere on the board
BED_SWITCH: J25.6; also elsewhere on the board
GND: C113.1, C114.1, C139.1, C140.1, C141.1, C142.1, C143.1, C144.1, C145.1, C146.1, C147.1, C148.1, C149.2, C150.2, C151.2, C152.2, C153.1, C154.1, C155.1, C156.1, C159.2, C160.2, C161.2, C162.2, D11.1 (K), D12.1 (K), D13.1 (K), D14.1 (K), J25.2, J25.4, R79.2, R80.2, R83.2, R84.2, R85.2, R86.2, R88.2, R90.2, U18.2 (GND), U19.2 (NC), U19.6 (GND), U19.7 (NC), U19.9 (SGND), U19.13 (NC), U19.14 (NC), U19.15 (NC), U19.16 (NC), U19.17 (GPAD), U20.2 (NC), U20.6 (GND), U20.7 (NC), U20.9 (SGND), U20.13 (NC), U20.14 (NC), U20.15 (NC), U20.16 (NC), U20.17 (GPAD); also elsewhere on the board
unnamed: C145.2, C147.2, D19.1, R96.2, U18.1 (VI), U23.3
unnamed: C149.1, C151.1, C153.2, D15.1, R81.1, U19.1 (VIN)
unnamed: C150.1, C152.1, C154.2, D16.1, R82.1, U20.1 (VIN)
unnamed: C155.2, U19.4 (SS)
unnamed: C156.2, U20.4 (SS)
unnamed: C157.1, U19.11 (BOOT)
unnamed: C157.2, D17.1, L3.1, U19.12 (LX)
unnamed: C158.1, U20.11 (BOOT)
unnamed: C158.2, D18.1, L4.1, U20.12 (LX)
unnamed: C163.1, R87.2, R88.1, U19.5 (FB)
unnamed: C164.1, R89.2, R90.1, U20.5 (FB)
unnamed: D11.2 (A), R75.2
unnamed: D12.2 (A), R76.2
unnamed: D13.2 (A), R77.2
unnamed: D14.2 (A), R78.2
unnamed: D17.2, R83.1, R85.1, U19.8 (ISEN)
unnamed: D18.2, R84.1, R86.1, U20.8 (ISEN)
unnamed: R79.1, U19.10 (DIS)
unnamed: R80.1, U20.10 (DIS)
unnamed: R81.2, U19.3 (TON)
unnamed: R82.2, U20.3 (TON)
unnamed: R94.1, R95.2, U23.1
unnamed: R96.1, U18.3 (EN)
VBED_FUSED: C144.2, F3.2, J25.5; also elsewhere on the board
VBUS: D19.2; also elsewhere on the board
VMOT: C139.2, F1.1, J25.1
VMOT_FUSED: C142.2, F1.2; also elsewhere on the board

Notes on the sheet:
Power Terminal
FUSE HOLDER
600mA Max!
Updated R81 from 100k to 200k
Updated R163 from 100nF to 8.2nF
Updated R164 from 100nF to 100nF
Updated R89 from 3.6k to 3.48k

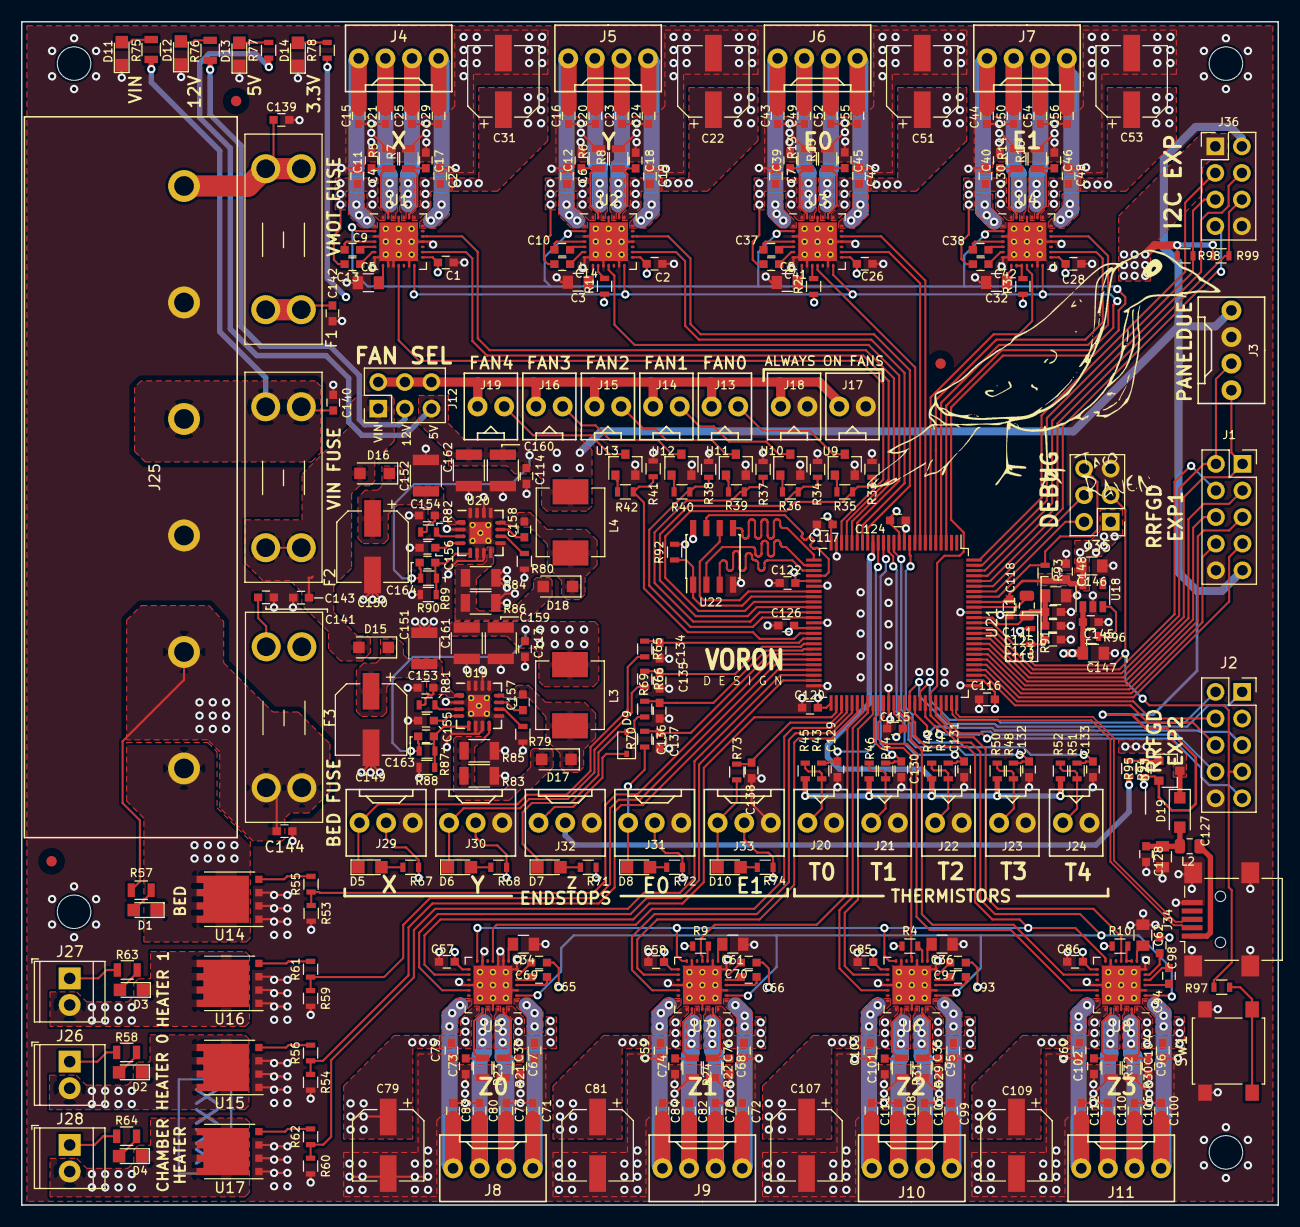
[picture p29: board Voron_Klipper_Board.kicad_pcb from above]

Board: 4 copper layers, 120.0 x 113.0 mm, 340 parts (0 on the bottom side), 241 nets.
