twmiv/Voron-Hardware/(commit log)

2020-08-16 TMC2209 upgrade layout ready for review
    [ATSAMD51.sch, Endstops.sch, FANS.sch, Heaters.sch, Power.sch, StepperXYE0E1.sch, StepperZ1234.sch, Thermistors.sch]
2020-08-16 apply gitignore
    [BOM_Taco_Raven-simple.csv]
